xiaoerlang0359/E203plus/E203Plus/readme.txt

项目设计报告请见 燕子设计报告.pdf 包括系统设计方案，功能仿真及测试结果图

constraint 文件夹中是硬件工程的约束文件

DoC 中包含各分系统设计文档

license 中是蜂鸟E203的license，根据开源协议要求添加

rtl 文件夹中是E203Plus SoC设计的rtl代码

sim 文件夹中存放了我们对分系统进行行为仿真和fpga原型测试的tb文件和c文件以及结果照片

测试 文件夹中是对赛题要求的测试项目进行测试的内容。包括c文件，以及结果照片。

软件项目工程 是完成最终身份识别任务的eclipse工程文件
