xiaoerlang0359/E203plus/RISC-V挑战杯 Digilent赛题测试图库/RISC-V Digilent 测试库/README.txt

身份证号码库
--10张身份证号码图片
--图片尺寸85.6X54mm
--微软雅黑
--字号 18
--包含尾号X的身份证号码
--图片格式JPG

人脸图片库
--10组不同的人脸图片，每一组包含15张同一人的图片
--图片像素640X480
--图片格式JPG

*主办方会根据比赛实际情况扩展图片库，图片尺寸以及格式将保持统一，请大家悉知。
