xiaoerlang0359/E203plus/E203Plus/Doc（分系统设计文档）/VGA Controller Spec.docx

# VGA Controller Spec

## 功能介绍

VGA Controller模块接受来自CPU的字符显示数据，并将字符像素通过VGA显示到屏幕上。显示分辨率为640x480，色彩格式为RGB444。总共接受18x10共计180个字符信息。显示字符包括10个阿拉伯数字和大写字母‘X’。

## IO定义

用户侧采用ICB接口：

Name | Direction | Bits | Description
Cmd_valid | I | 1 | 主设备发送读写请求
Cmd_ready | O | 1 | 从设备返回读写接收信号
Cmd_read | I | 1 | 读或者写操作指示
Cmd_addr | I | 32 | 读写地址
Cmd_wdata | I | 32 | 写操作数据
Cmd_wmask | I | 3 | 写操作字节掩码
Rsp_valid | O | 1 | 从设备发送读写反馈请求信号
Rsp_ready | I | 1 | 主设备返回读写反馈接收信号
Rsp_rdata | O | 32 | 读反馈数据
Clk | I | 1 | 模块时钟
Rst_n | I | 1 | 复位，低有效

VGA侧采用RGB444格式输出。

Name | Direction | Bits | Description
Vga_R | O | 4 | VGA四位红色信息
Vga_G | O | 4 | VGA四位绿色信息
Vga_B | O | 4 | VGA四位蓝色信息

## 地址空间

VGA Controller使用了0x1001_0000 ~ 0x1001_0FFF的物理内存空间。

其中0x1001_0000 ~ 0x1000_1083暂存180个字符信息。

0x1001_0FFC为32为模块使能寄存器（只写）。当最低比特位置1使能VGA显示模块，最低比特位置0停止VGA显示模块。
