xiaoerlang0359/E203plus/E203Plus/2+BHL115476+燕子.jpg

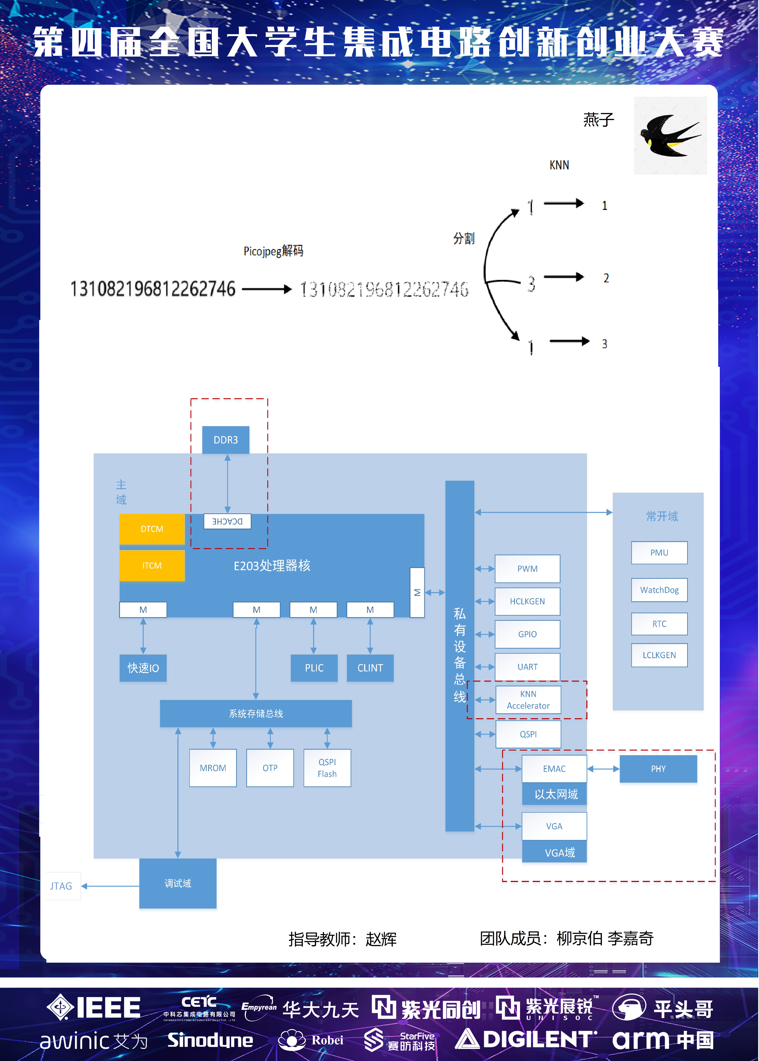
E203Plus/2+BHL115476+燕子.jpg
