xiaoerlang0359/E203plus/E203Plus/Doc（分系统设计文档）/总体设计.jpg

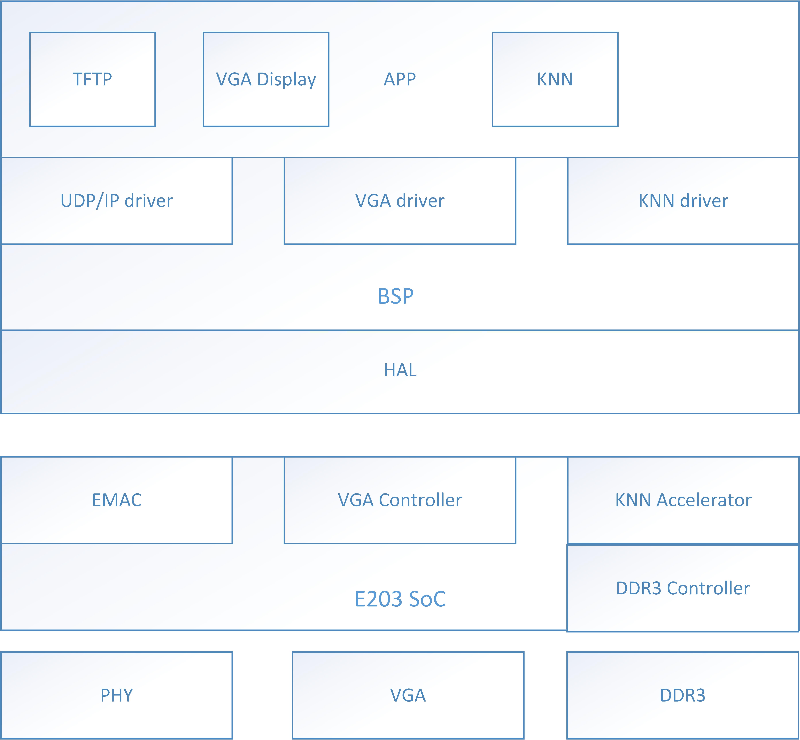
E203Plus/Doc（分系统设计文档）/总体设计.jpg
