xiaoerlang0359/E203plus/E203Plus/log_on.JPG

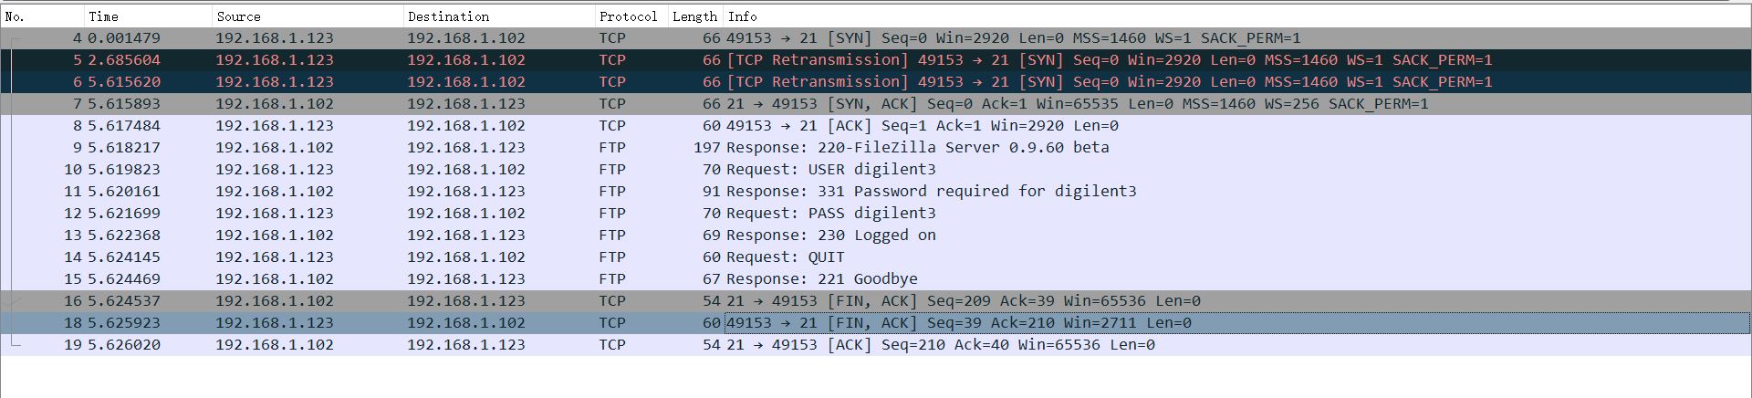
E203Plus/log_on.JPG
