xiaoerlang0359/E203plus/E203Plus/sim（分系统行为仿真及fpga测试）/DDR3/fpga存储测试.jpg

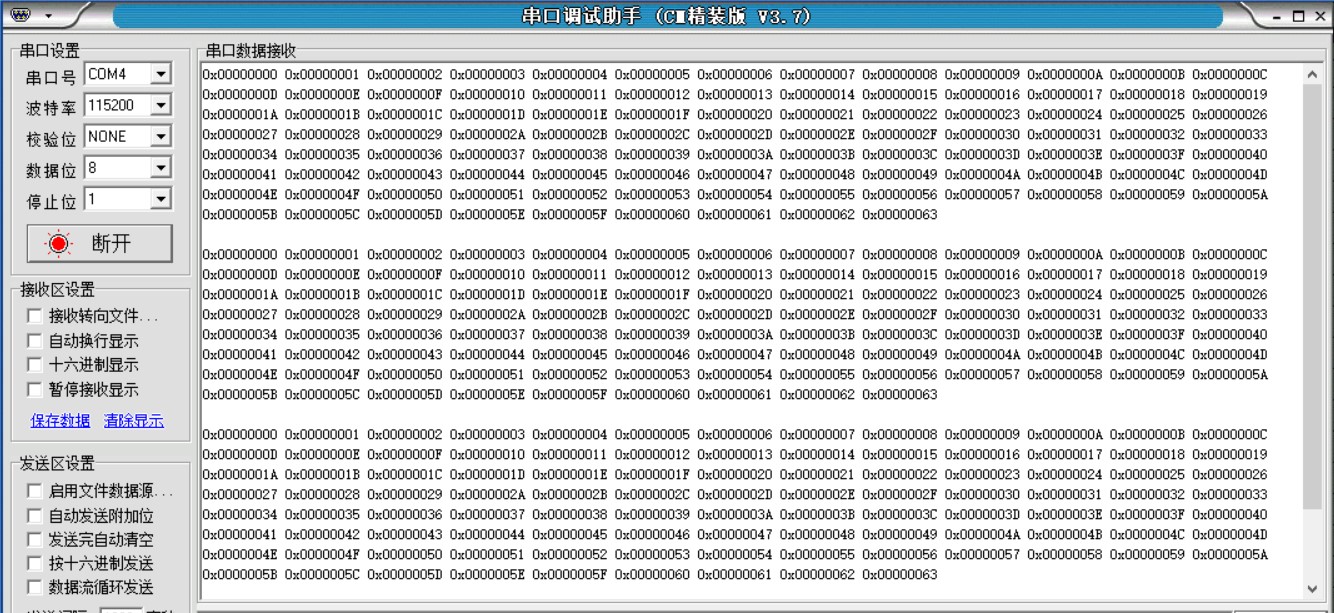
E203Plus/sim（分系统行为仿真及fpga测试）/DDR3/fpga存储测试.jpg
