xiaoerlang0359/E203plus/E203Plus/sim（分系统行为仿真及fpga测试）/EMAC/数据接收.jpg

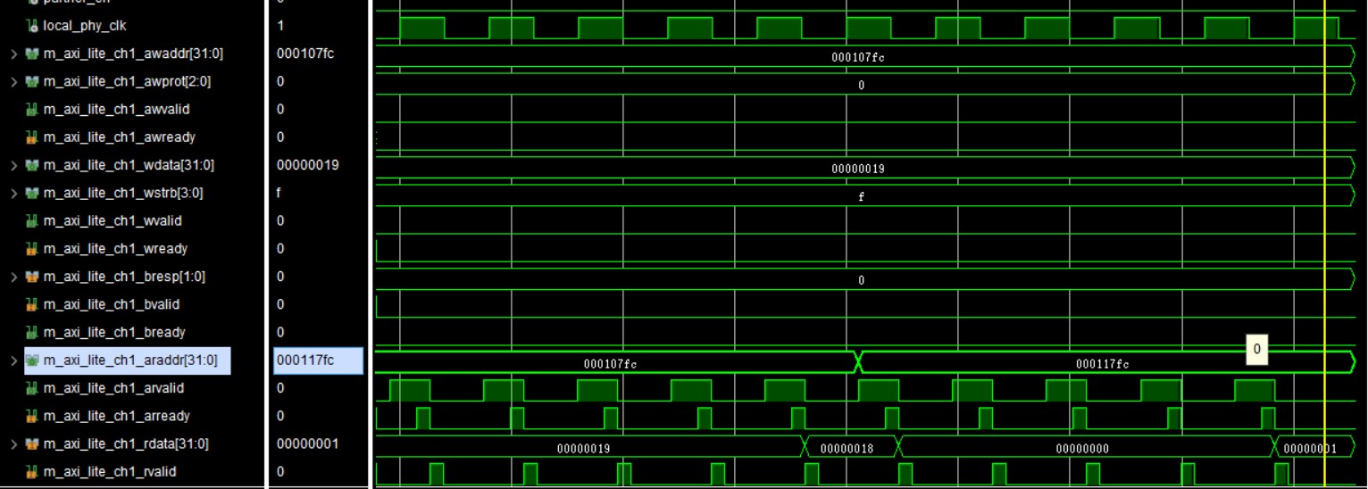
E203Plus/sim（分系统行为仿真及fpga测试）/EMAC/数据接收.jpg
