xiaoerlang0359/E203plus/E203Plus/sim（分系统行为仿真及fpga测试）/KNN/行为仿真2.jpg

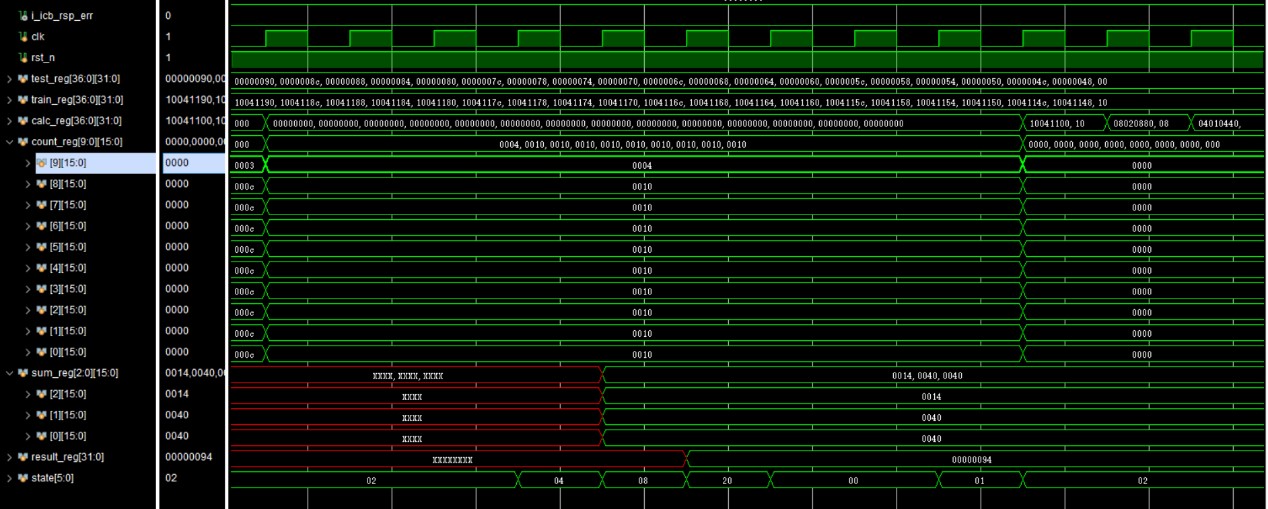
E203Plus/sim（分系统行为仿真及fpga测试）/KNN/行为仿真2.jpg
