xiaoerlang0359/E203plus/E203Plus/测试（赛题要求测试）/gpio/绿色.jpg

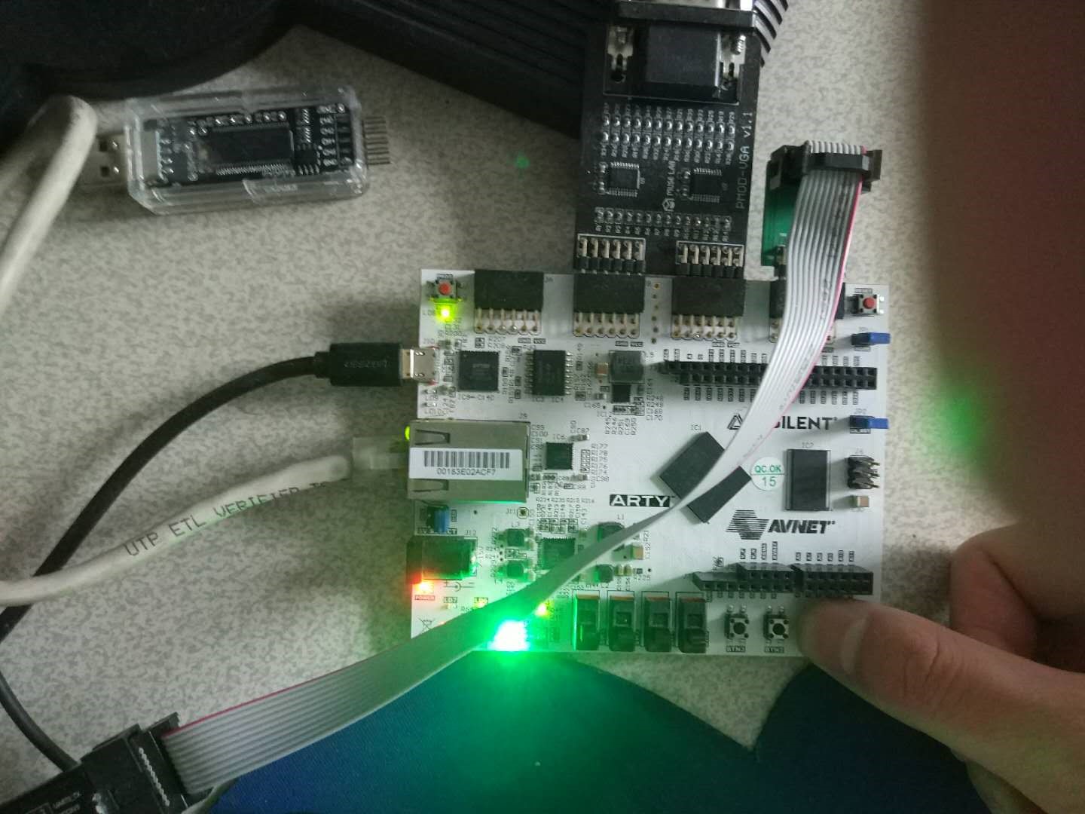
E203Plus/测试（赛题要求测试）/gpio/绿色.jpg
