xiaoerlang0359/E203plus/E203Plus/测试（赛题要求测试）/risc-v/risc_v.jpg

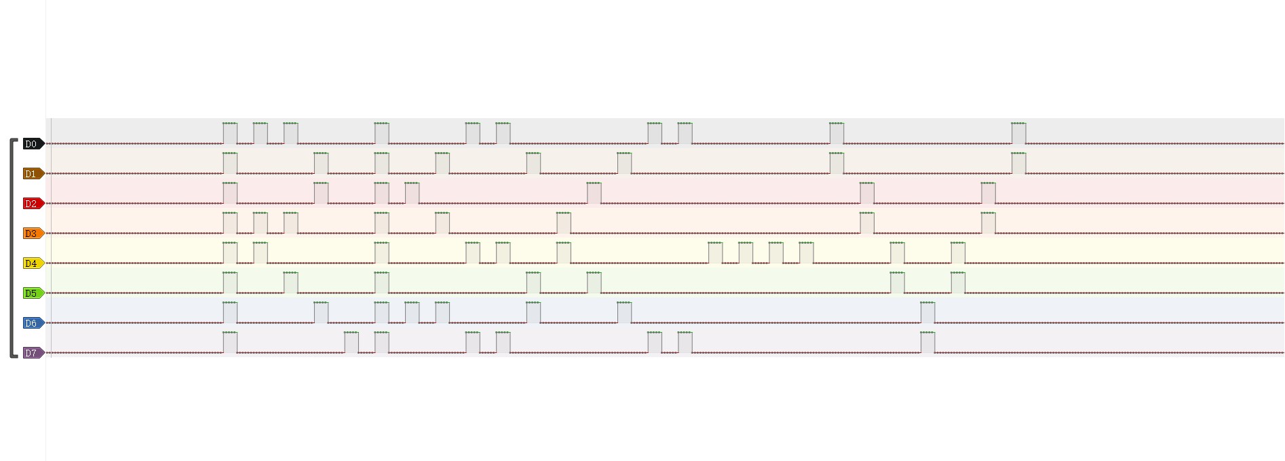
E203Plus/测试（赛题要求测试）/risc-v/risc_v.jpg
