xiaoerlang0359/E203plus/RISC-V挑战杯 Digilent赛题测试图库/RISC-V Digilent 测试库/身份证/1.jpg

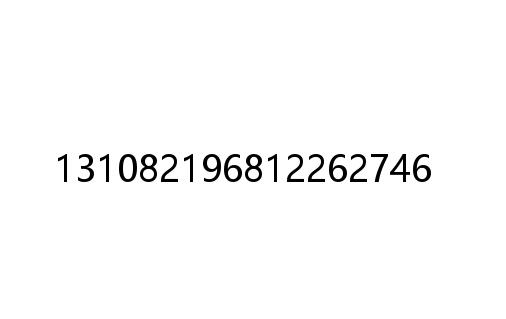
RISC-V挑战杯 Digilent赛题测试图库/RISC-V Digilent 测试库/身份证/1.jpg
