xiaoerlang0359/E203plus/E203Plus/测试（赛题要求测试）/final_test/test.txt

01234567890123456X
976230154896537150
658425970934331400
481988392863422640
382810210809111612
15487560993060459X
321890146238729340
907709837891161564
190196732524782430
78495706105604768X
