xiaoerlang0359/E203plus/trainingset/maketraingset/maketraingset/0_0_test.txt

2097151,2097151,2097151,2097151,2081023,2031679,1966111,1973775,1851151,1589127,1605511,1605511,1605507,1114051,1114051,1114051,1114051,1114051,1114051,1114051,1114051,1114051,1114051,1114055,1605511,1605511,1605511,1851151,1842719,1966111,2031679,2081023,2097151,2097151,2097151,2097151,2097151,
