xiaoerlang0359/E203plus/trainingset/maketraingset/maketraingset/1_0_test.txt

2097151,2097151,2097151,2097151,2095615,2093567,2081279,2032127,1835519,1847807,1896959,2093567,2093567,2093567,2093567,2093567,2093567,2093567,2093567,2093567,2093567,2093567,2093567,2093567,2093567,2093567,2093567,2093567,2093567,2093567,2093567,2093567,2097151,2097151,2097151,2097151,2097151,
