xiaoerlang0359/E203plus/trainingset/maketraingset/maketraingset/2_0_test.txt

2097151,2097151,2097151,2097151,2064895,1966207,1572927,1604639,1703711,1834895,2097039,2097039,2097039,2097039,2096911,2096927,2096671,2096191,2095231,2089215,2081279,2065407,2035711,1974271,1851391,1605631,1638399,1114111,1114111,1048583,1048583,1048583,2097151,2097151,2097151,2097151,2097151,
