xiaoerlang0359/E203plus/trainingset/maketraingset/maketraingset/3_0_test.txt

2097151,2097151,2097151,2097151,2064639,1966207,1835039,1866783,1965583,2096911,2096911,2096911,2096911,2096671,2096671,2095167,2031871,2032127,2031679,2096159,2096911,2096903,2097031,2097031,2097031,2097031,2096903,1834767,1637407,1572895,1572991,1966591,2097151,2097151,2097151,2097151,2097151,
