xiaoerlang0359/E203plus/trainingset/maketraingset/maketraingset/4_0_test.txt

2097151,2097151,2097151,2097151,2096191,2096191,2095167,2095167,2093119,2093119,2089535,2081343,2065983,2068031,2035263,1973823,1982015,1867327,1605183,1113663,130623,261695,3,3,3,2096703,2096703,2096703,2096703,2096703,2096703,2096703,2097151,2097151,2097151,2097151,2097151,
