xiaoerlang0359/E203plus/trainingset/maketraingset/maketraingset/5_0_test.txt

2097151,2097151,2097151,2097151,1835023,1835023,1835023,1867775,1867775,1867775,1900543,1638399,1638399,1638399,1638399,1573375,1572991,1572895,2095119,2096655,2096903,2097031,2097031,2097031,2097031,2097031,2096911,2096655,2096159,1572927,1572991,1835519,2097151,2097151,2097151,2097151,2097151,
