xiaoerlang0359/E203plus/trainingset/maketraingset/maketraingset/6_0_test.txt

2097151,2097151,2097151,2097151,2093087,2080783,2064399,2033615,1974271,1851391,1851391,1605631,1605631,1638399,1114111,1110143,1097759,1081359,1056519,1081223,1081219,1114051,1114051,1114051,1114051,1638339,1605511,1851271,1842703,1966111,2031679,2081023,2097151,2097151,2097151,2097151,2097151,
