xiaoerlang0359/E203plus/trainingset/maketraingset/maketraingset/7_0_test.txt

2097151,2097151,2097151,2097151,1048583,1048583,1048583,2097039,2096911,2096927,2096671,2096703,2096191,2096255,2095231,2095231,2093311,2093311,2093567,2089471,2089471,2081791,2081791,2081791,2066431,2066431,2066431,2066431,2035711,2035711,2035711,2035711,2097151,2097151,2097151,2097151,2097151,
