xiaoerlang0359/E203plus/trainingset/maketraingset/maketraingset/8_0_test.txt

2097151,2097151,2097151,2097151,2081023,2031679,1966111,1842703,1588999,1605511,1605511,1605511,1605511,1867535,1851151,1973791,2031679,2031679,1835039,1850895,1638159,1113991,1179591,1179591,1179591,1179591,1113991,1638287,1588751,1835039,1966143,2064639,2097151,2097151,2097151,2097151,2097151,
