xiaoerlang0359/E203plus/trainingset/maketraingset/maketraingset/9_0_test.txt

2097151,2097151,2097151,2097151,2081023,2031679,1966111,1842703,1589007,1605511,1113991,1114055,1114051,1114051,1114051,1114051,1605507,1588995,1580547,1835075,1966147,2064835,2097095,2097031,2097031,2097039,2096911,2096671,1701951,1572991,1573119,1836031,2097151,2097151,2097151,2097151,2097151,
