xiaoerlang0359/E203plus/trainingset/maketraingset/maketraingset/X_0_test.txt

2097151,2097151,2097151,2097151,131056,1114081,1114049,1605571,1851271,1851271,1974031,1973791,2035231,2067519,2065471,2080895,2081023,2089215,2089215,2080895,2064511,2065471,2034751,2039327,1974031,1851151,1851271,1605511,1114051,1114049,131041,262128,2097151,2097151,2097151,2097151,2097151,
