xiaoerlang0359/E203plus/E203Plus/测试（赛题要求测试）/final_test/硬件连接.jpg

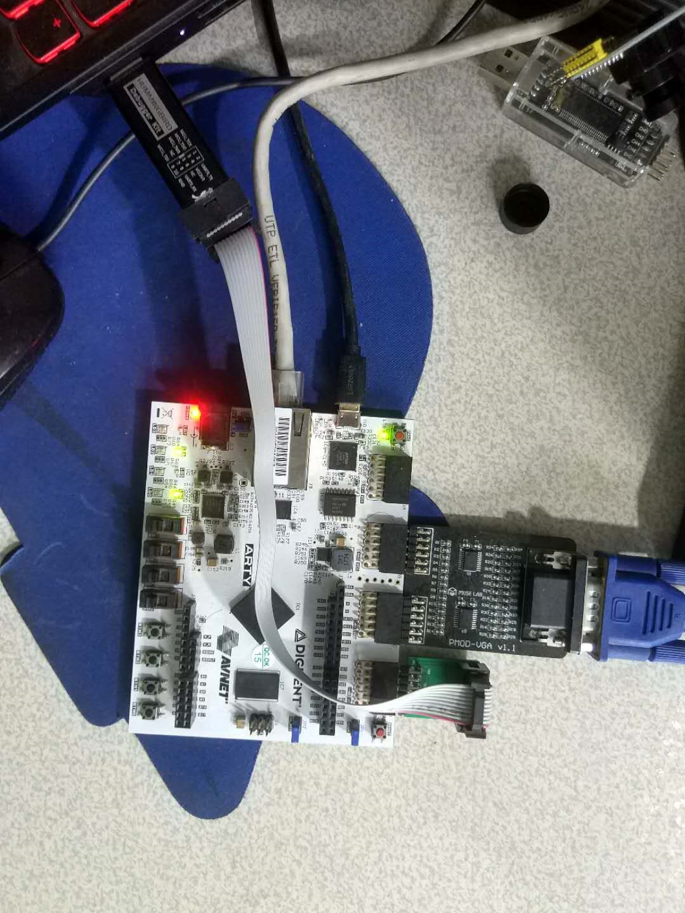
E203Plus/测试（赛题要求测试）/final_test/硬件连接.jpg
