xiaoerlang0359/E203plus/(threads)

Thread 1 (2021-04-27):

hi 您好 这个项目很感兴趣呢

weisuolong, 2021-04-27:
您好 这个项目很感兴趣，但是 浮点数 乘加法，没有除法么？
您是学生？

xiaoerlang0359, 2021-04-27:
您好，感谢您对我的项目的肯定，我是学生。本次设计的SoC中是没有浮点数运算单元的，最终的图像比较是通过KNN算法实现的。详见E203Plus子文件夹中的介绍文档。如果您对risc-v内核的FPU实现感兴趣，可以参考其他开源项目，比如国科大的果壳，或者https://github.com/ljwljwljwljw/FPU，https://github.com/xiaoerlang0359/CNRV-FPU。当然如果您还对用verilog实现的较高性能rv core感兴趣，欢迎关注我的新项目：https://github.com/xiaoerlang0359/HiCore_a_riscv32_core
