xiaoerlang0359/E203plus/boards/nucleikit/蜂鸟FPGA开发板光绘图.pdf

# ART FILM - TOP

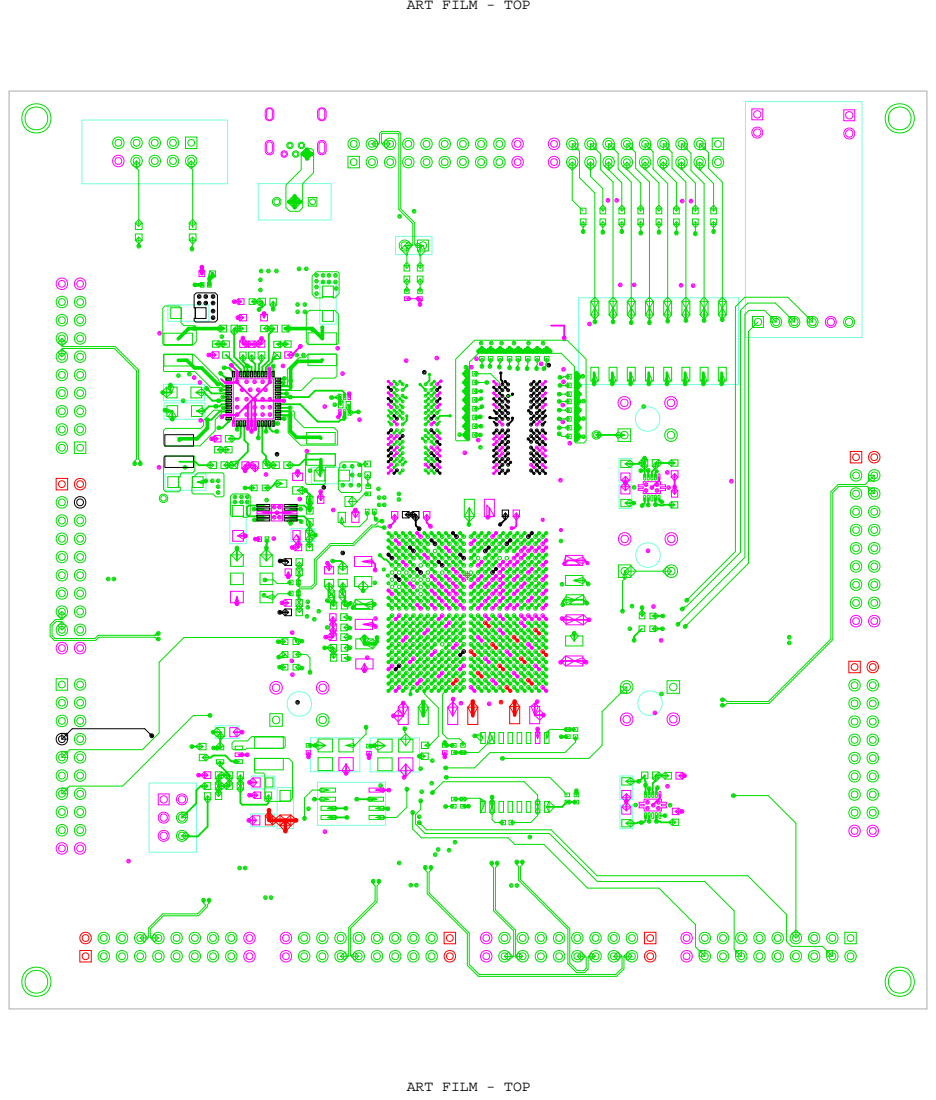
[picture p192: page 1]

ART FILM - TOP

# ART FILM - L2_GND_1

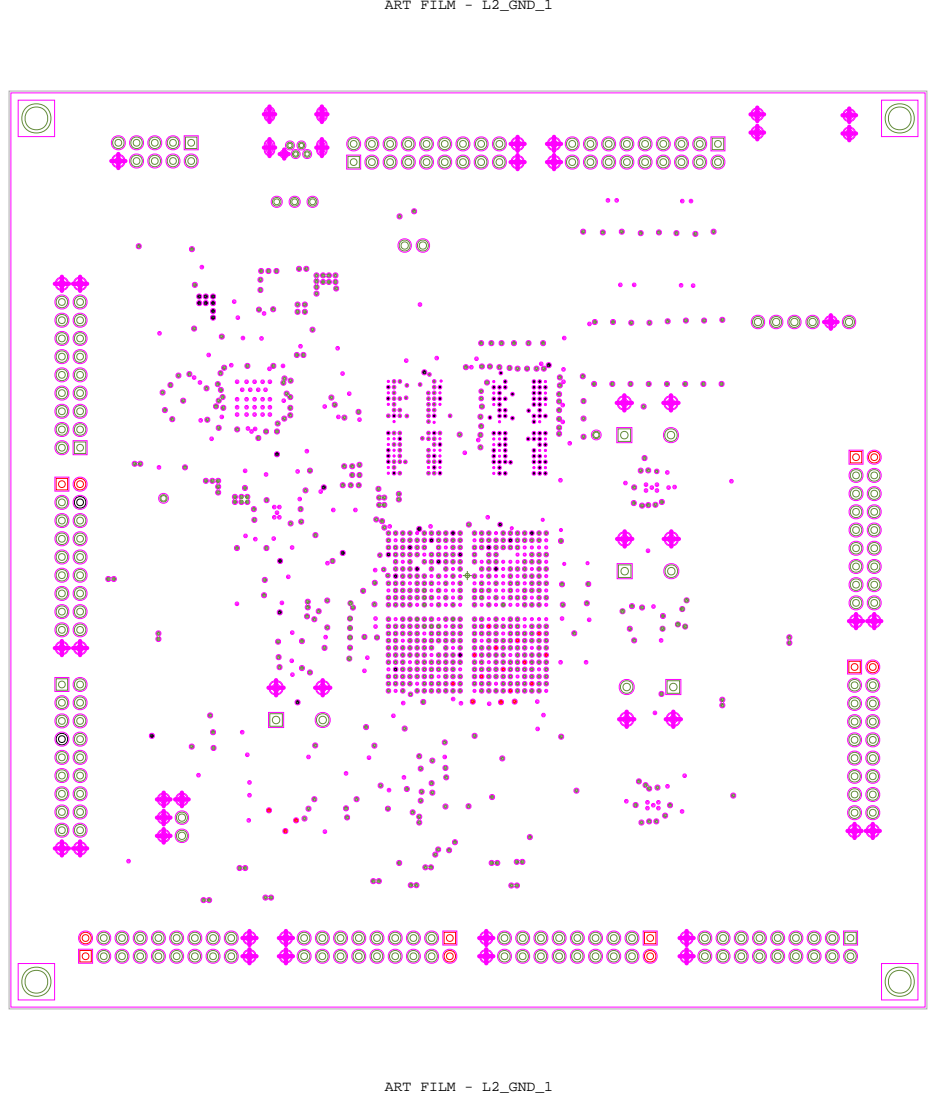
[picture p193: page 2]
ART FILM - L2_GND_1

# ART FILM - L3_SIG_2

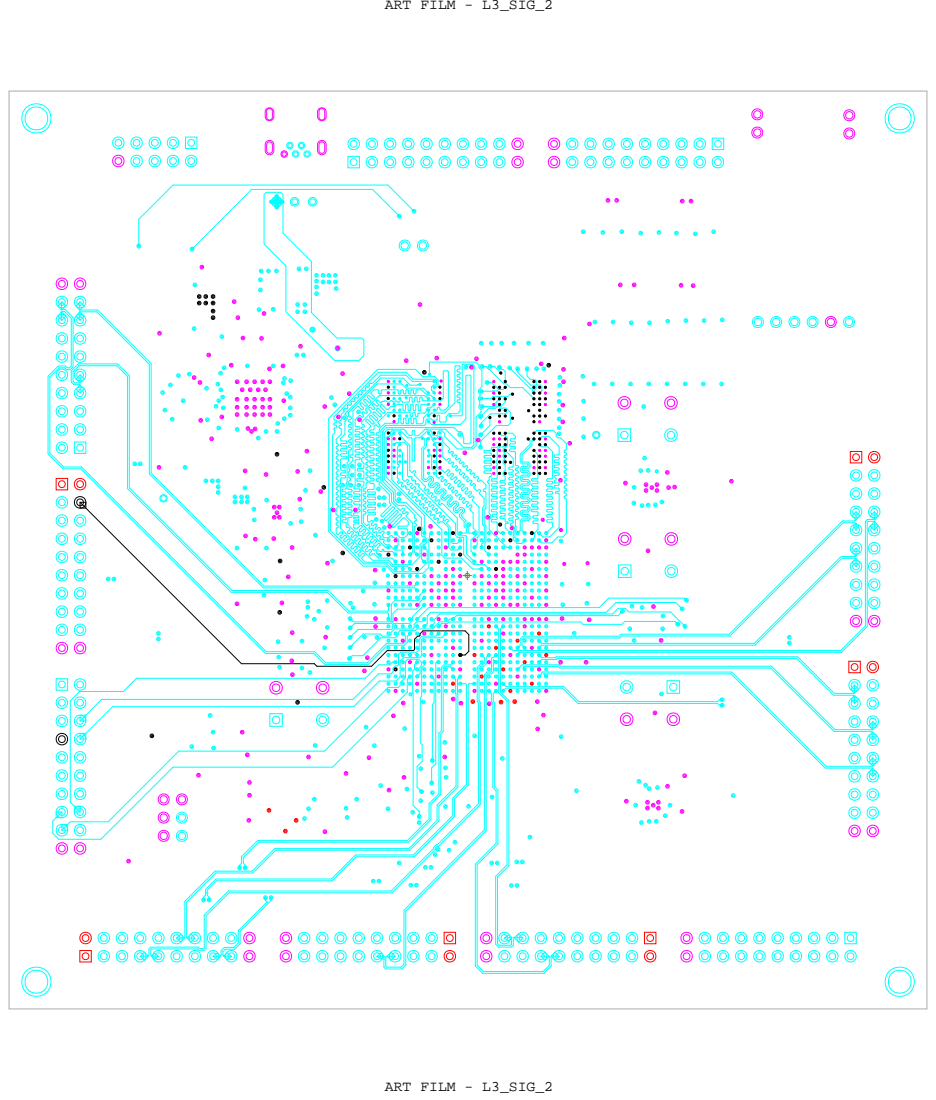
[picture p194: page 3]
ART FILM - L3_SIG_2

# ART FILM - L4_GND_3

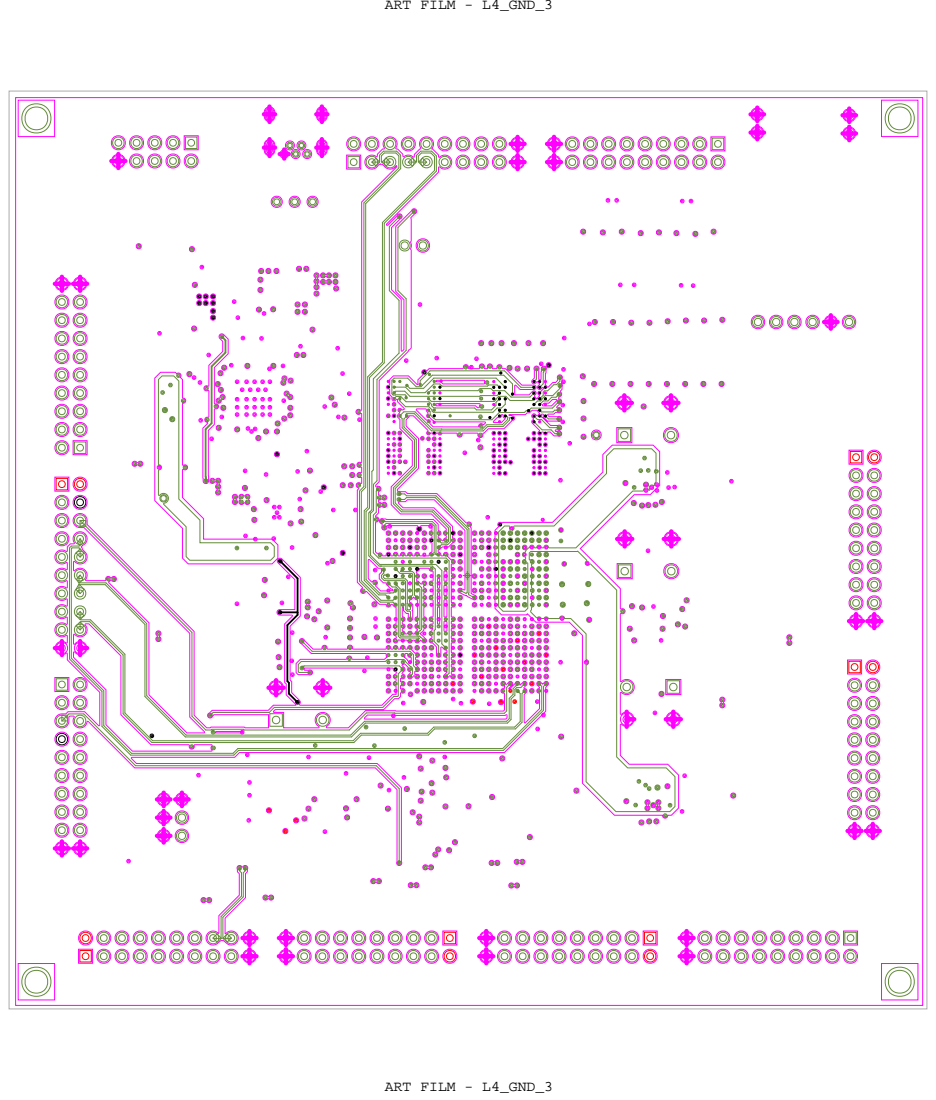
[picture p195: page 4]
ART FILM - L4_GND_3

# ART FILM - L7_GND_6

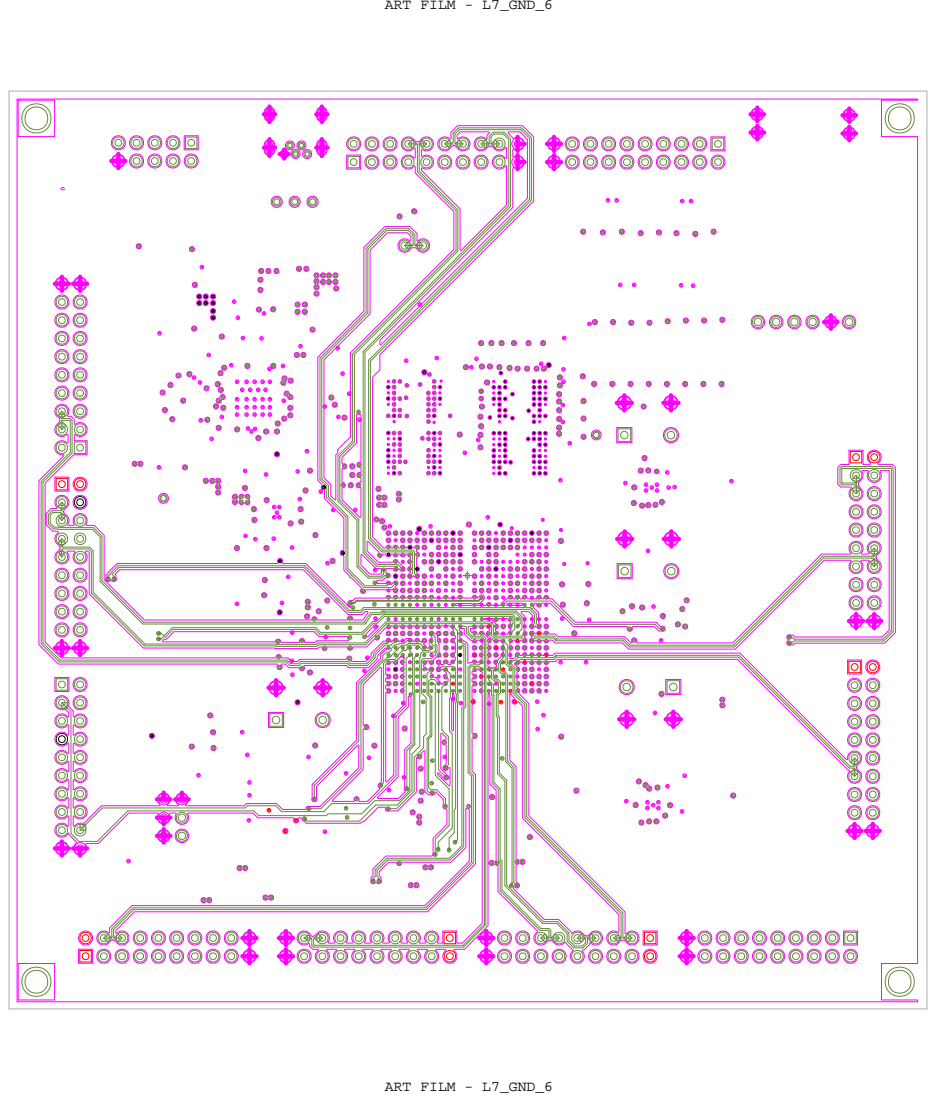
[picture p196: page 5]
ART FILM - L7_GND_6

# ART FILM - BOTTOM

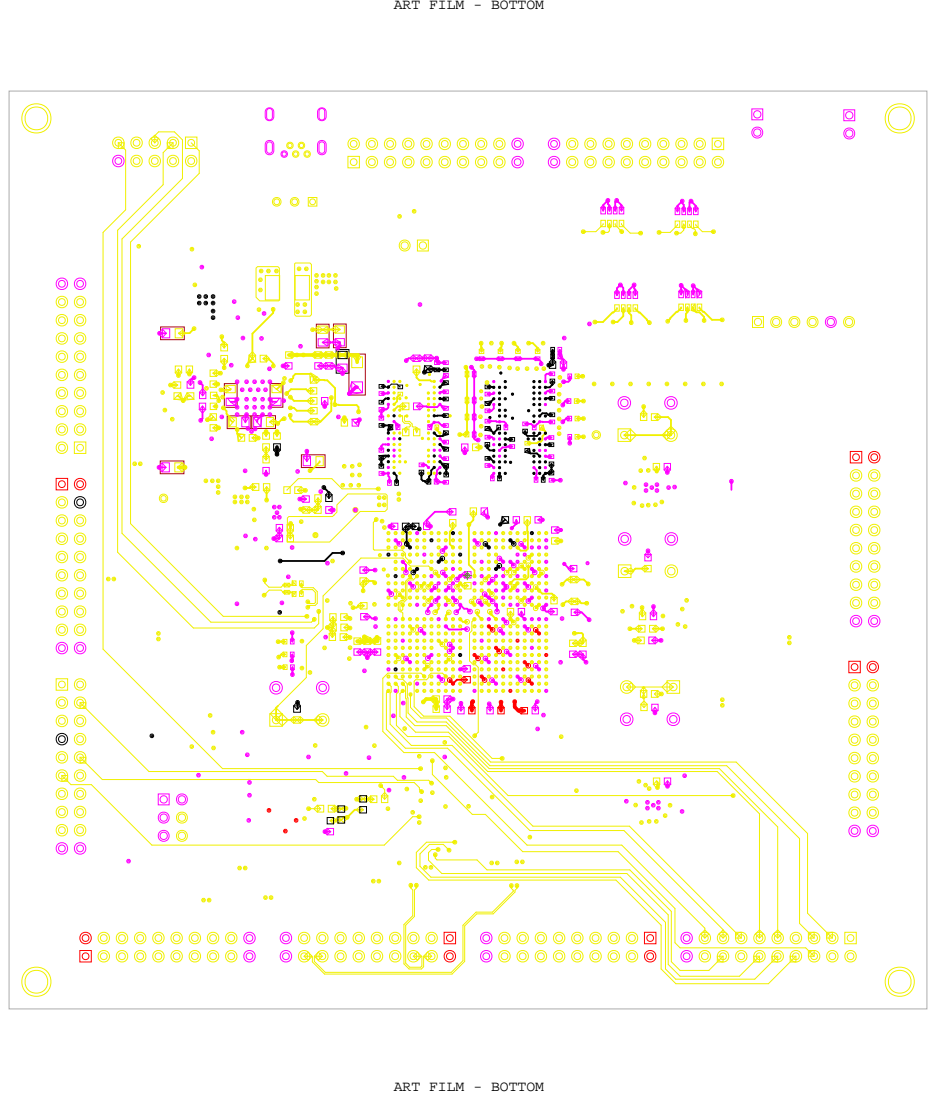
[picture p197: page 6]

ART FILM - BOTTOM

# ART FILM - SILKSCREEN_BOT

RN1

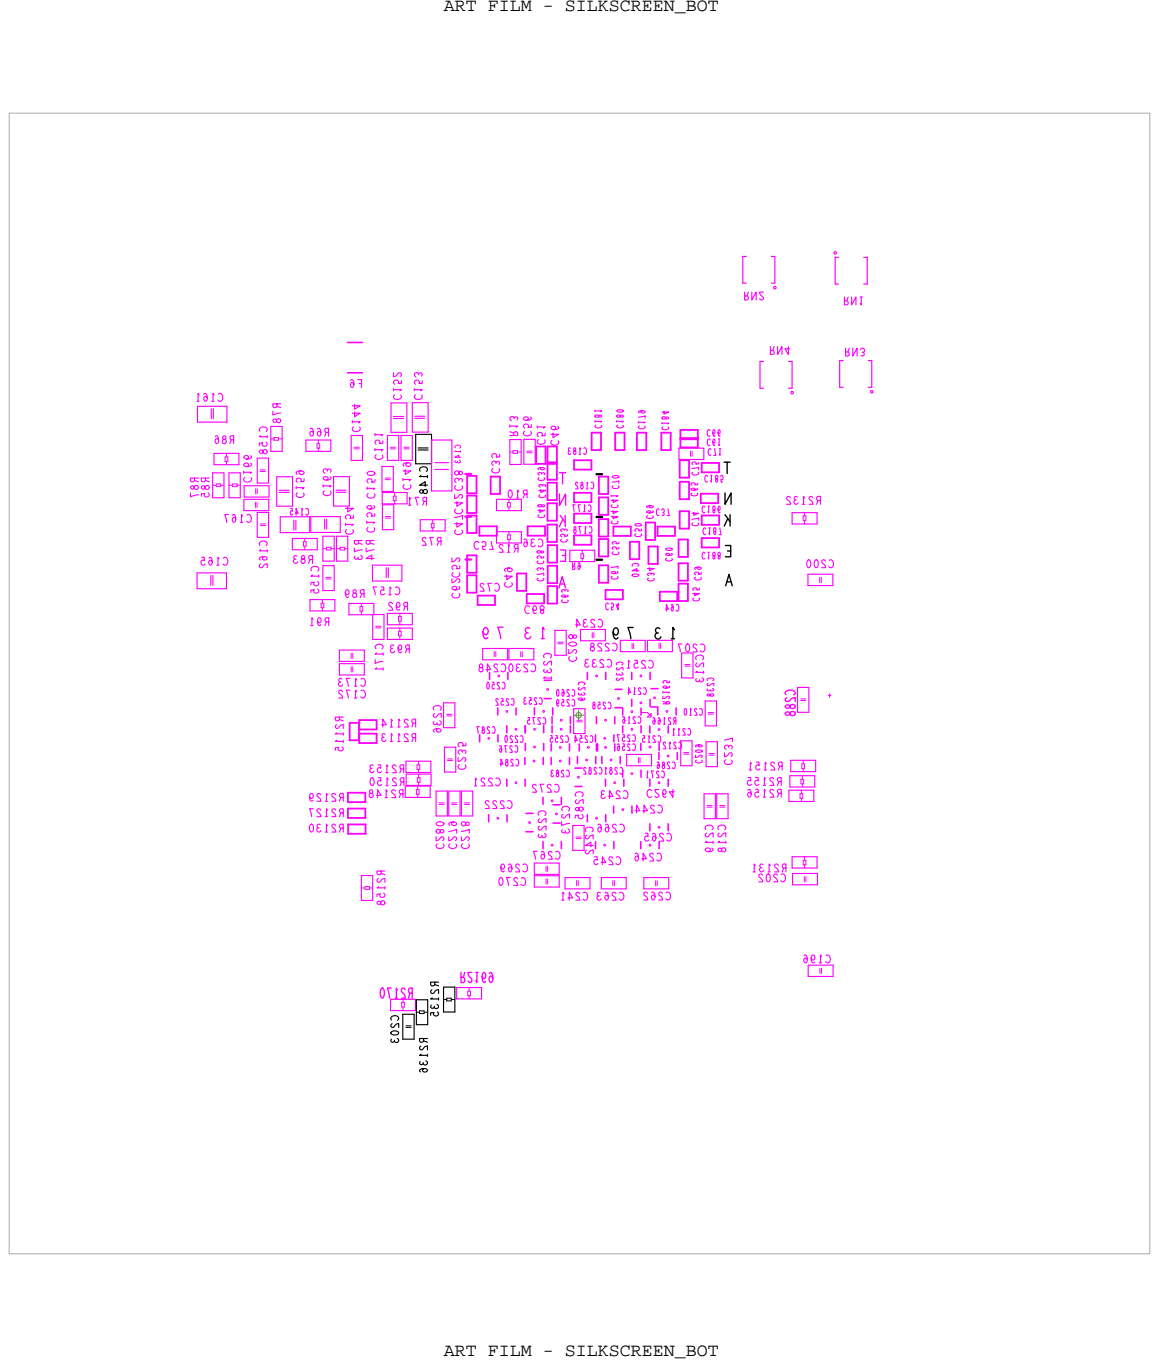
[picture p198: page 7]

# ART FILM - SILKSCREEN_TOP

J50

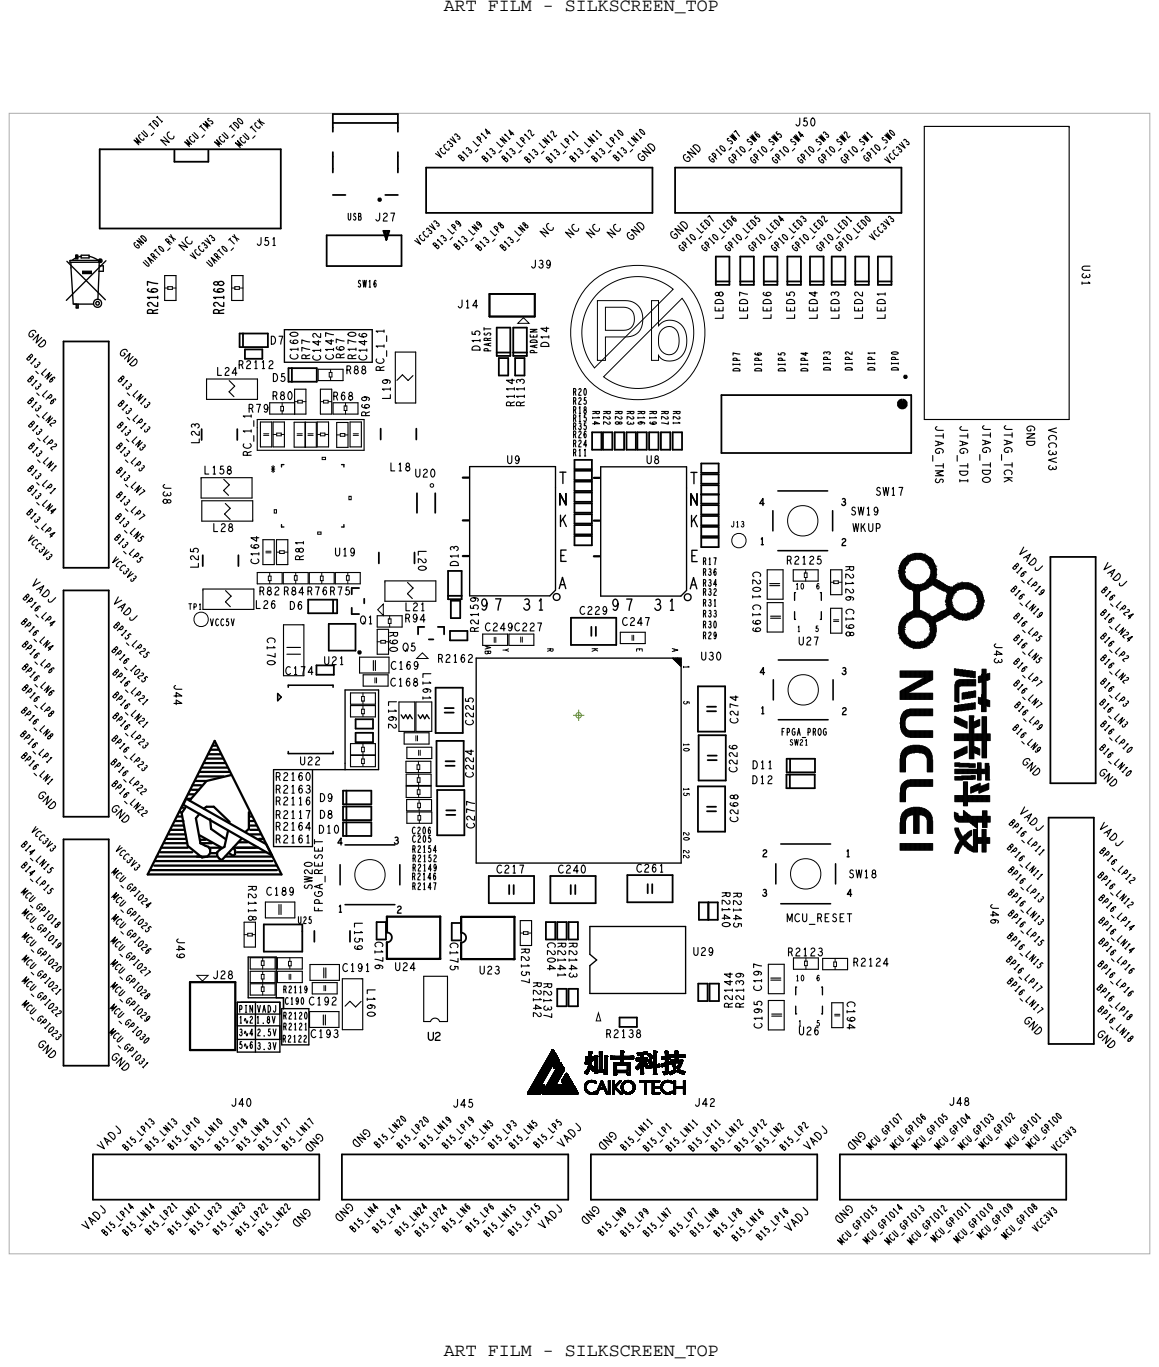
[picture p199: page 8]

# ART FILM - L8_SIG_7

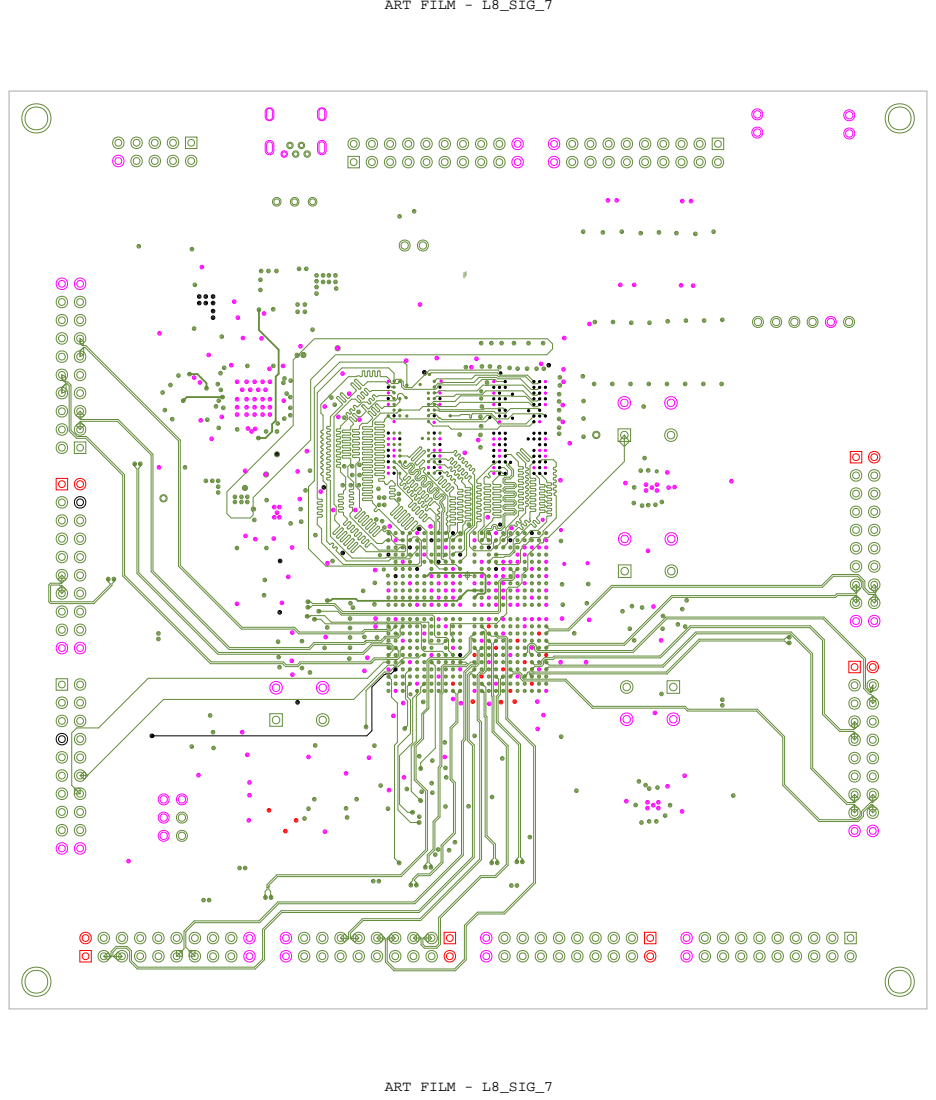
[picture p200: page 9]
ART FILM - L8_SIG_7

# ART FILM - L9_GND_8

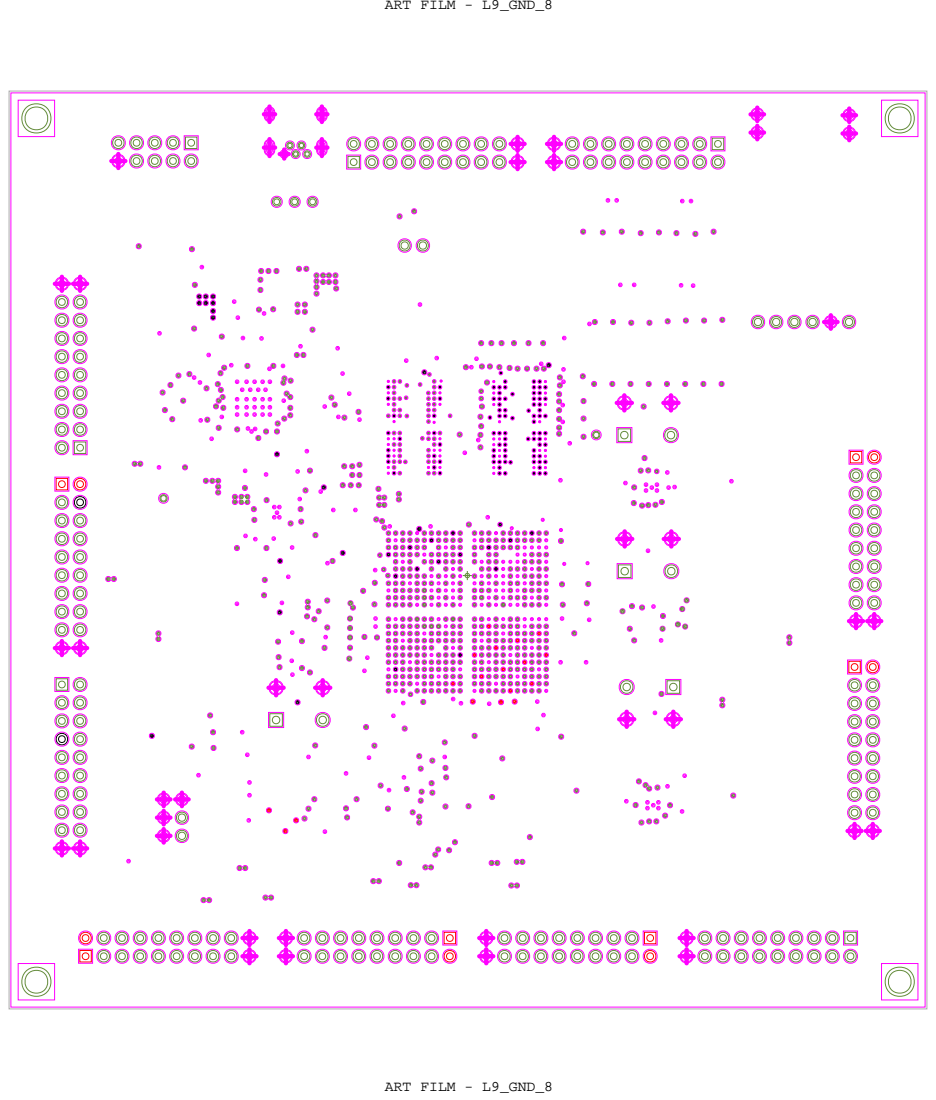
[picture p201: page 10]
ART FILM - L9_GND_8

# ART FILM - L5_PWER_4

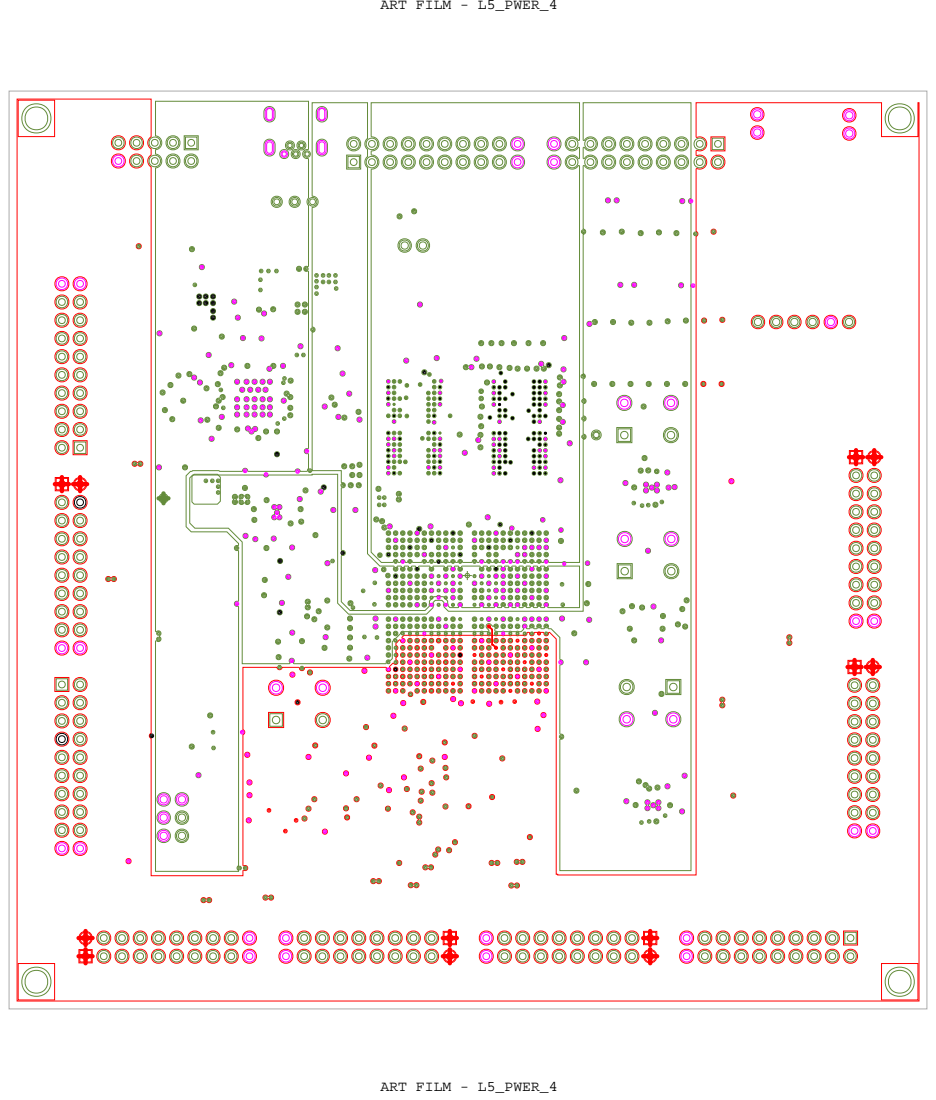
[picture p202: page 11]
ART FILM - L5_PWER_4

# ART FILM - L6_PWER_5

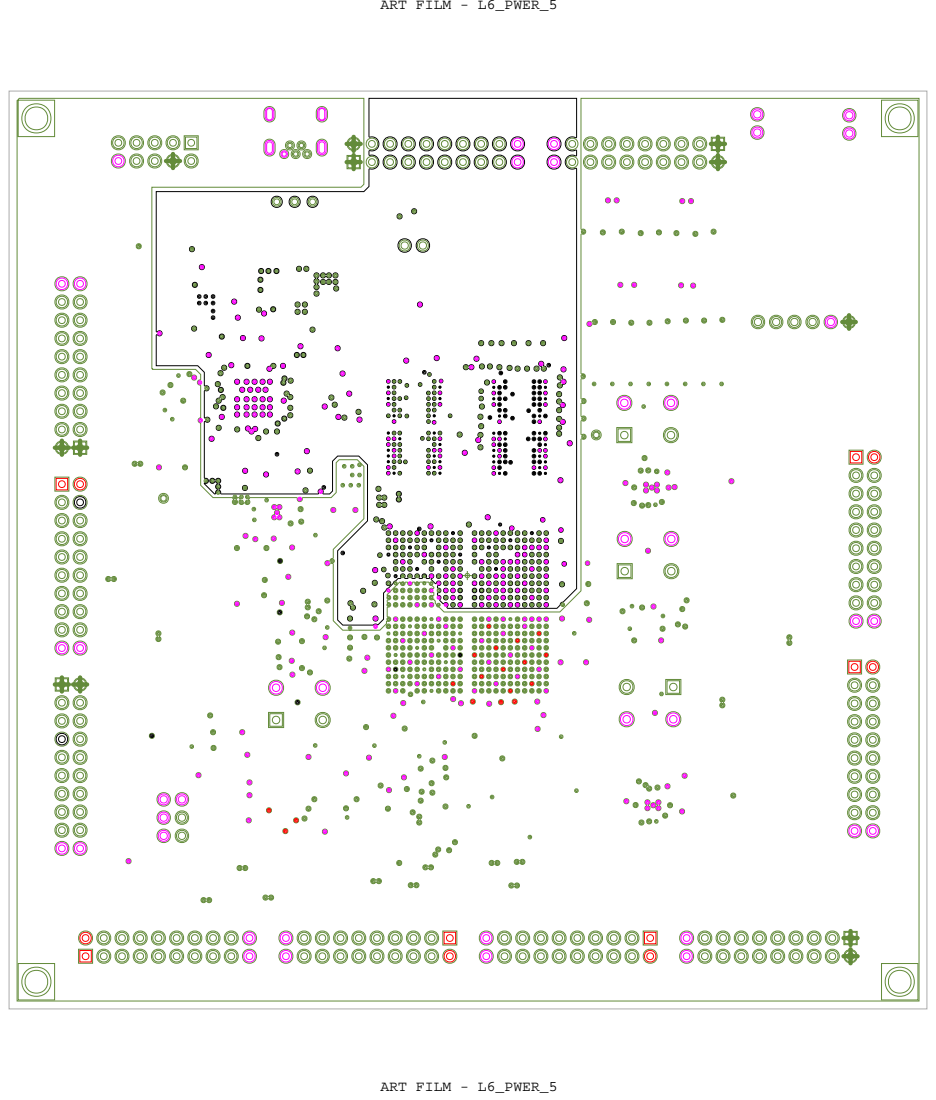
[picture p203: page 12]
ART FILM - L6_PWER_5
