xiaoerlang0359/E203plus/boards/nucleikit/蜂鸟FPGA开发板原理图.pdf

# TOP

## CONNECTOR

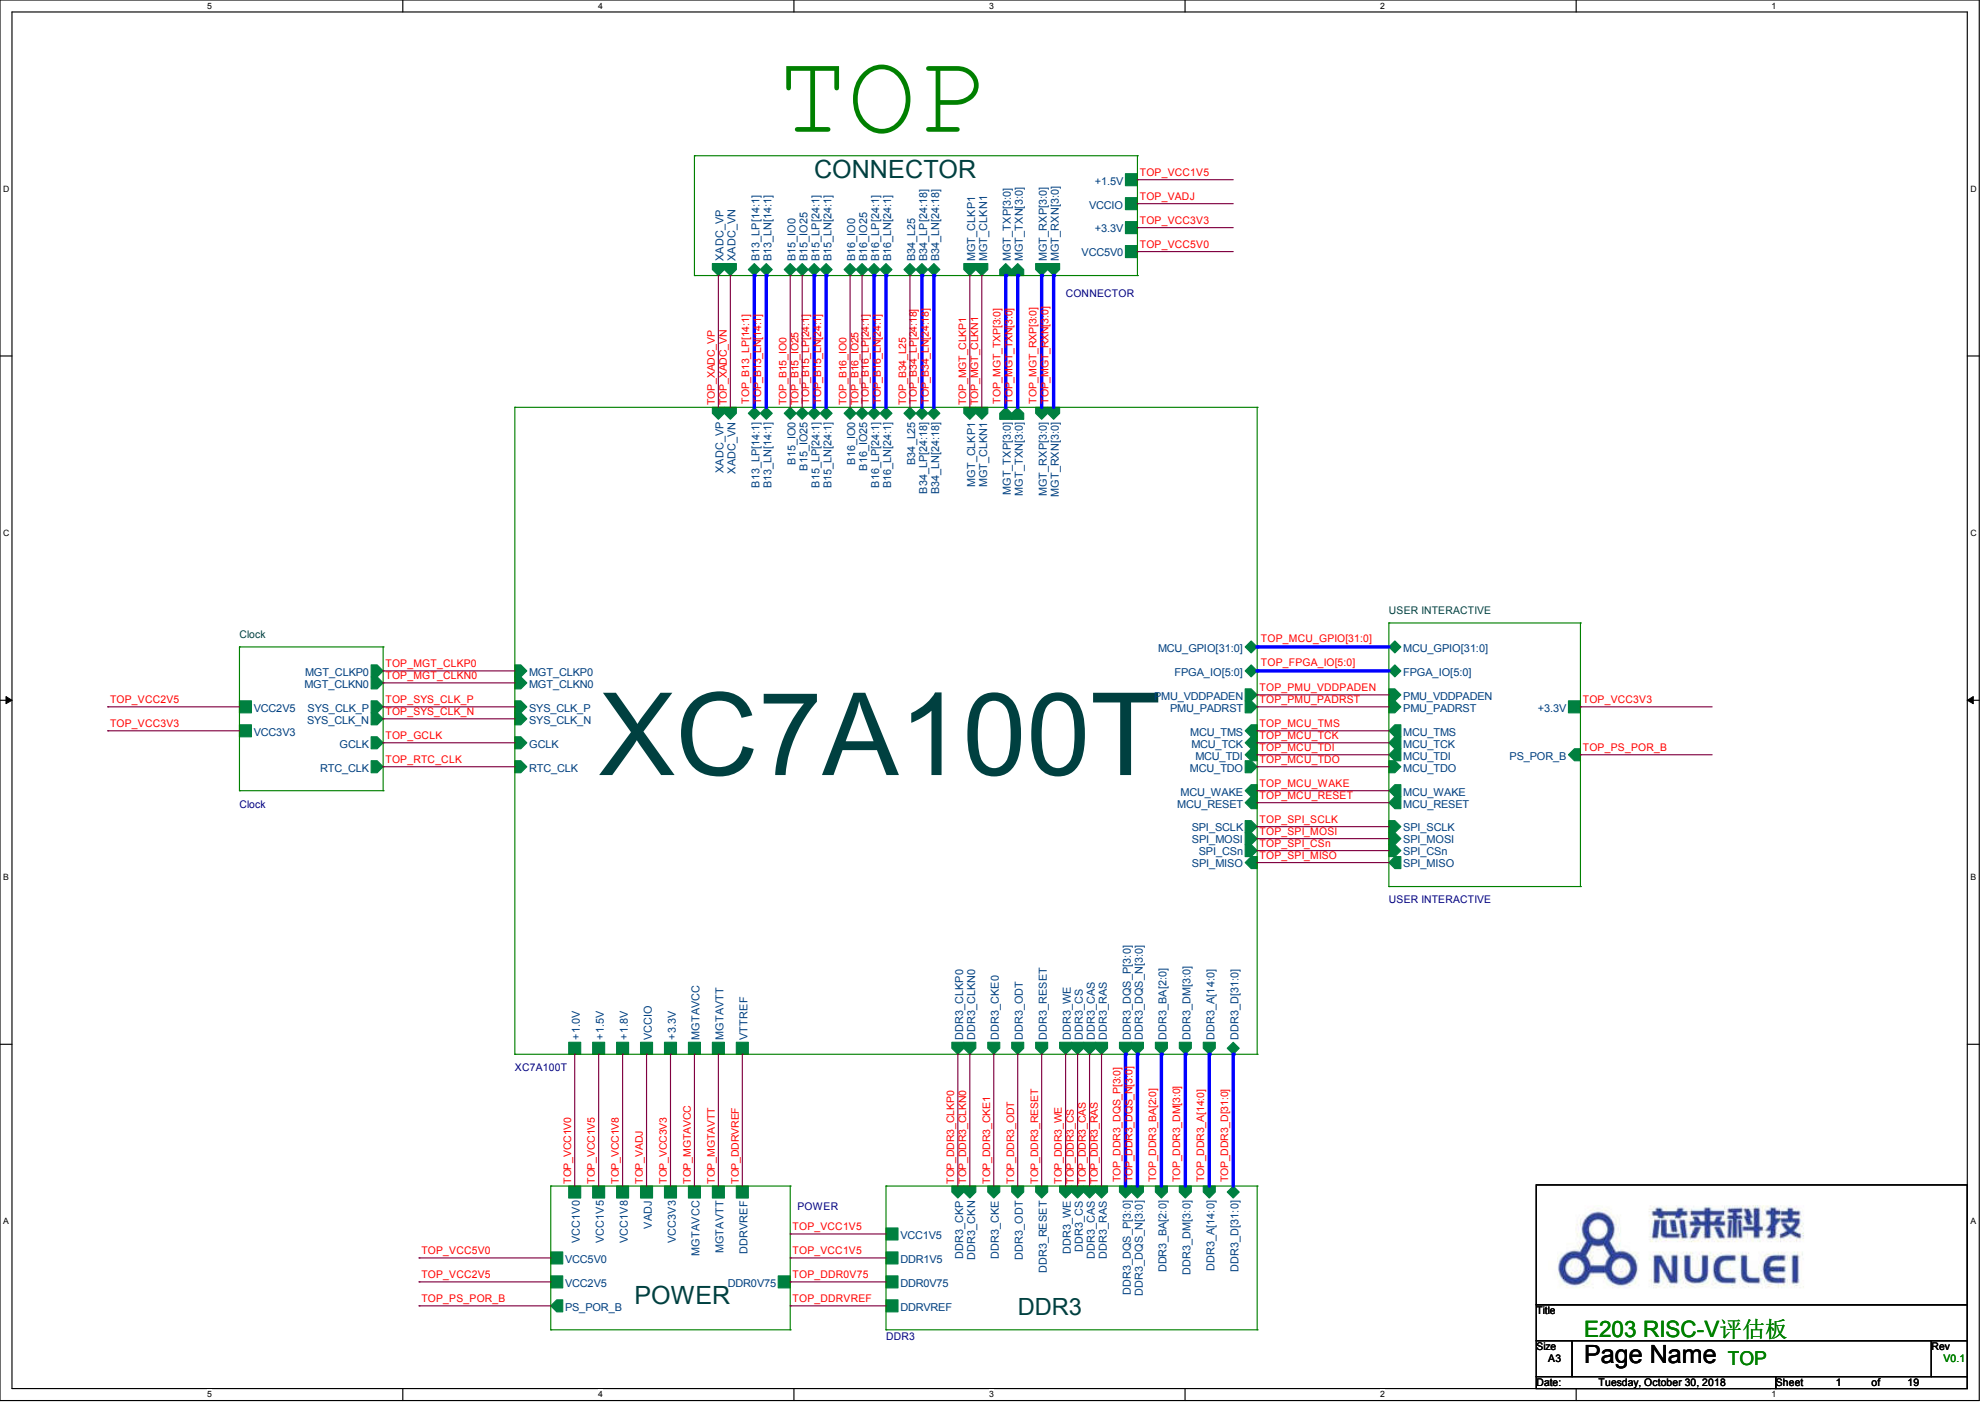
[picture p204: page 1]
Title; Size; Page Name; Rev; Date:; Sheet; TOP; E203 RISC-V评估板; Tuesday, October 30, 2018; CONNECTOR; XADC_VP; XADC_VN; MGT_CLKP1; MGT_CLKN1; MGT_TXP[3:0]; MGT_TXN[3:0]; MGT_RXP[3:0]; MGT_RXN[3:0]; VCC5V0; VCCIO; USER INTERACTIVE; MCU_RESET; MCU_WAKE; MCU_GPIO[31:0]; FPGA_IO[5:0]; MCU_TDI; MCU_TMS MCU_TCK; MCU_TDO; PS_POR_B; PMU_PADRST; PMU_VDDPADEN; SPI_SCLK; SPI_MISO; SPI_MOSI SPI_CSn; Clock; VCC2V5; MGT_CLKP0 MGT_CLKN0; SYS_CLK_N; SYS_CLK_P; VCC3V3; GCLK; RTC_CLK; MGTAVCC; MGTAVTT; VTTREF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

# CLOCK

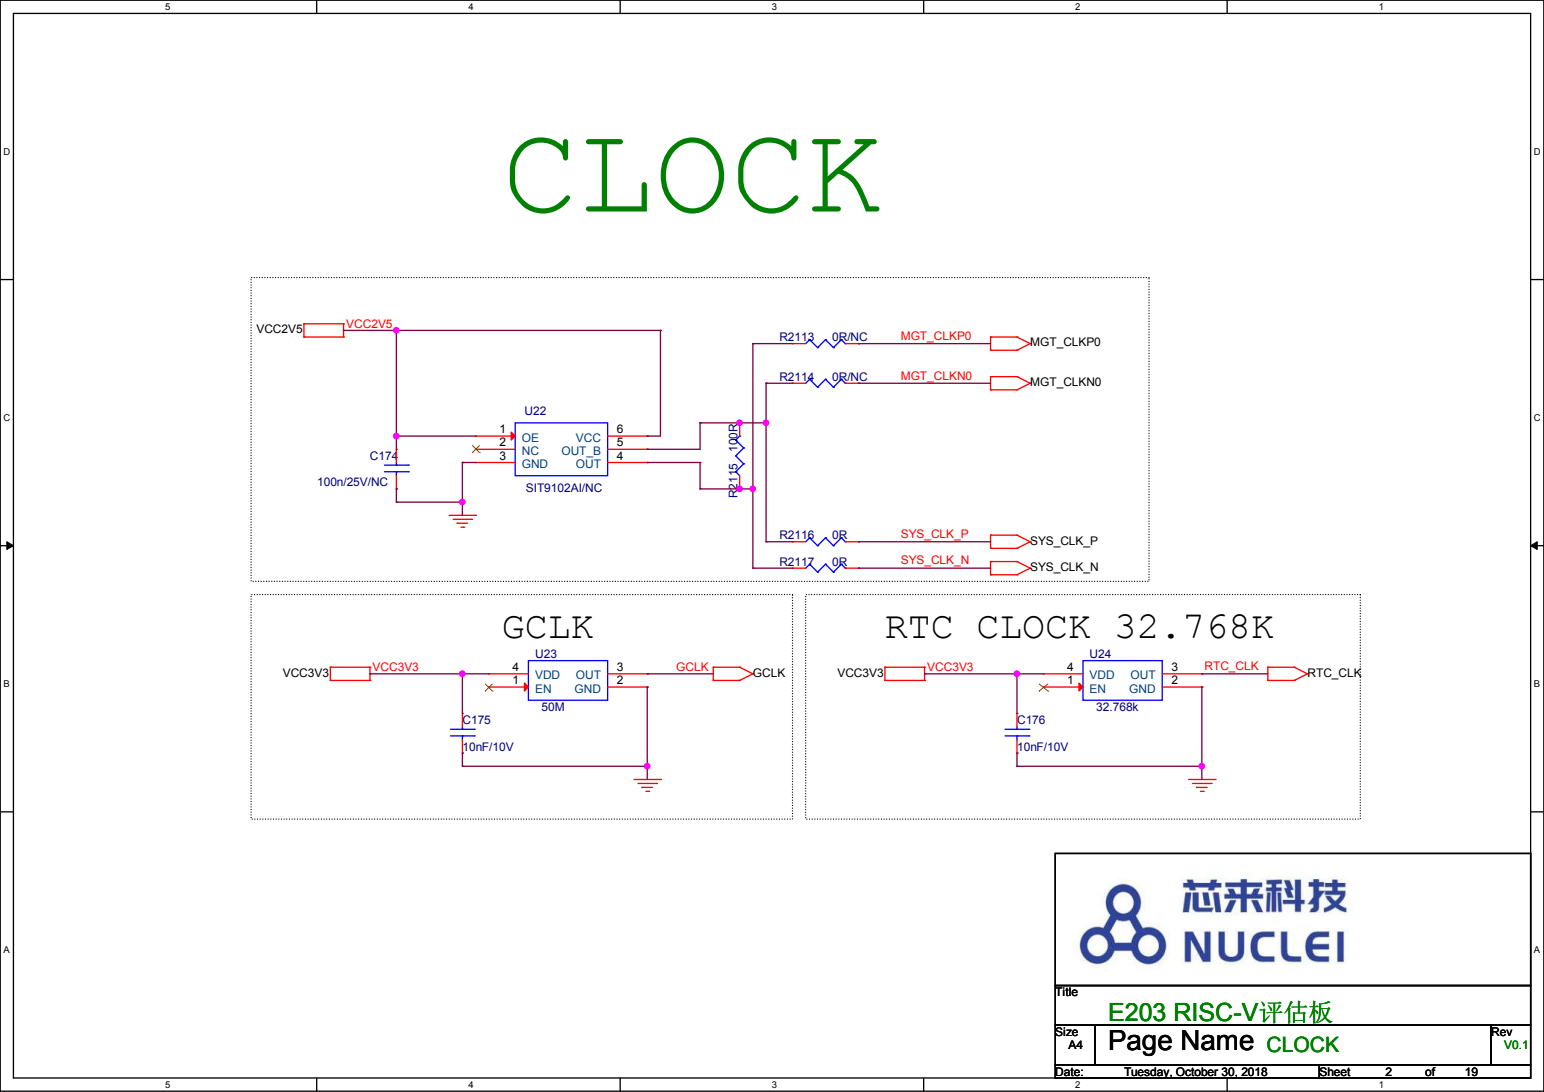
[picture p205: page 2]

# CONNECTOR

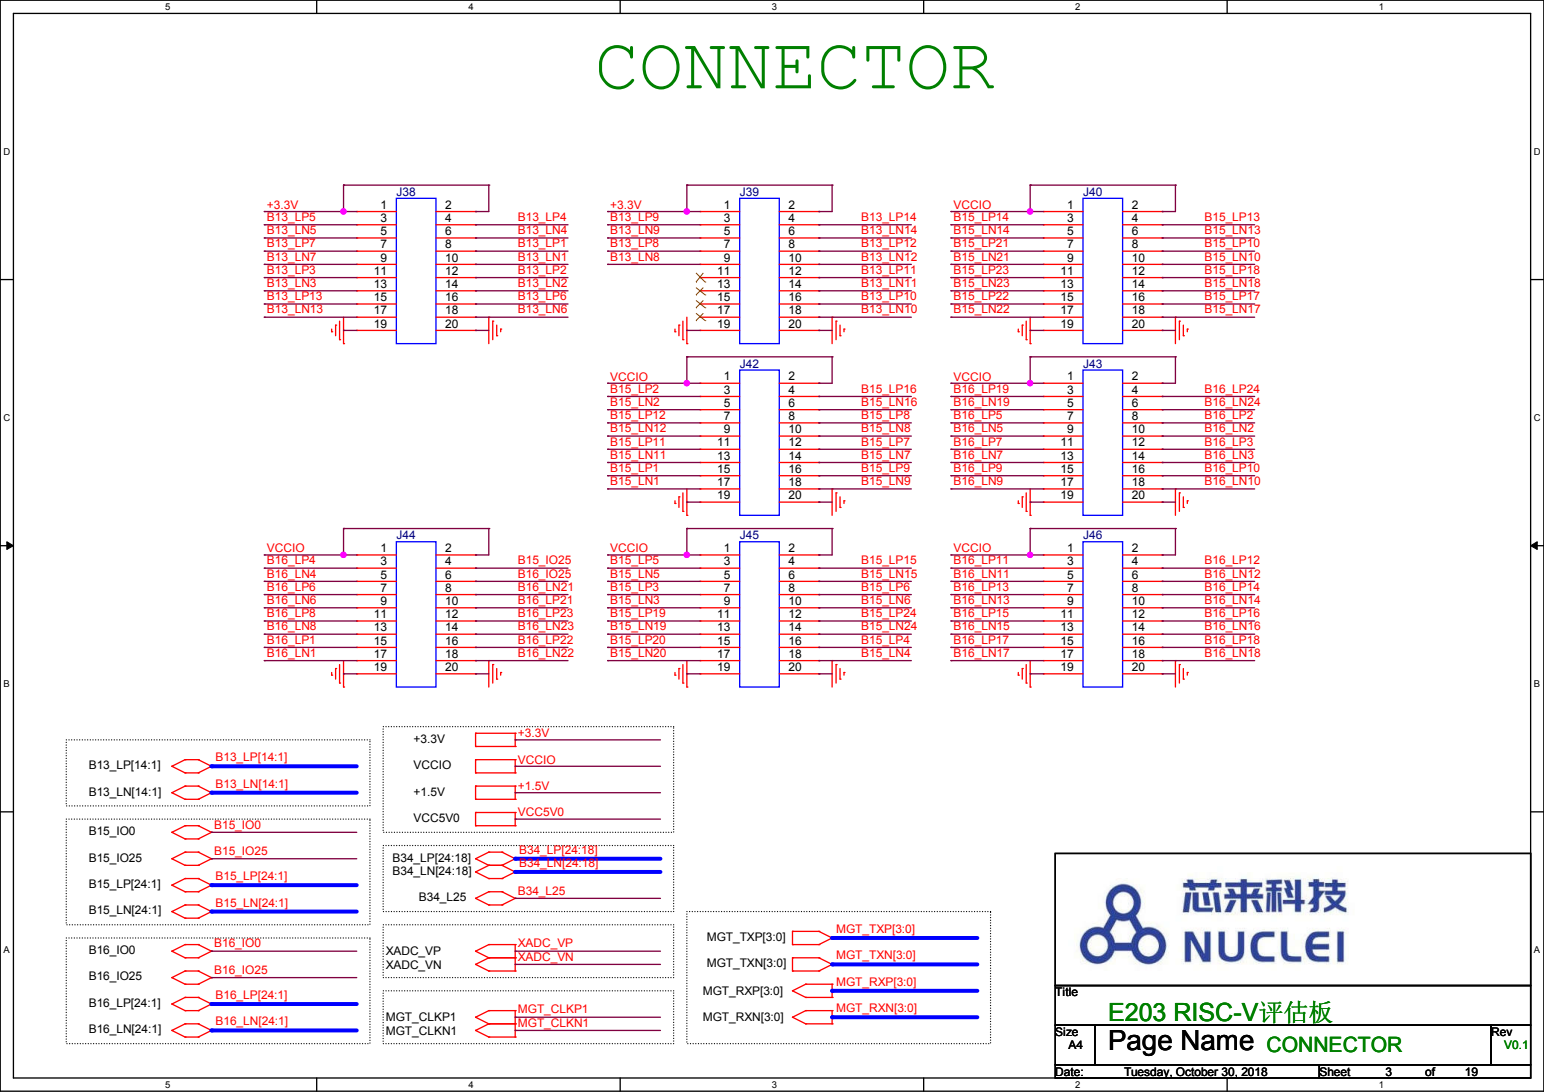
[picture p206: page 3]

# DDR3 TO TOP PORT

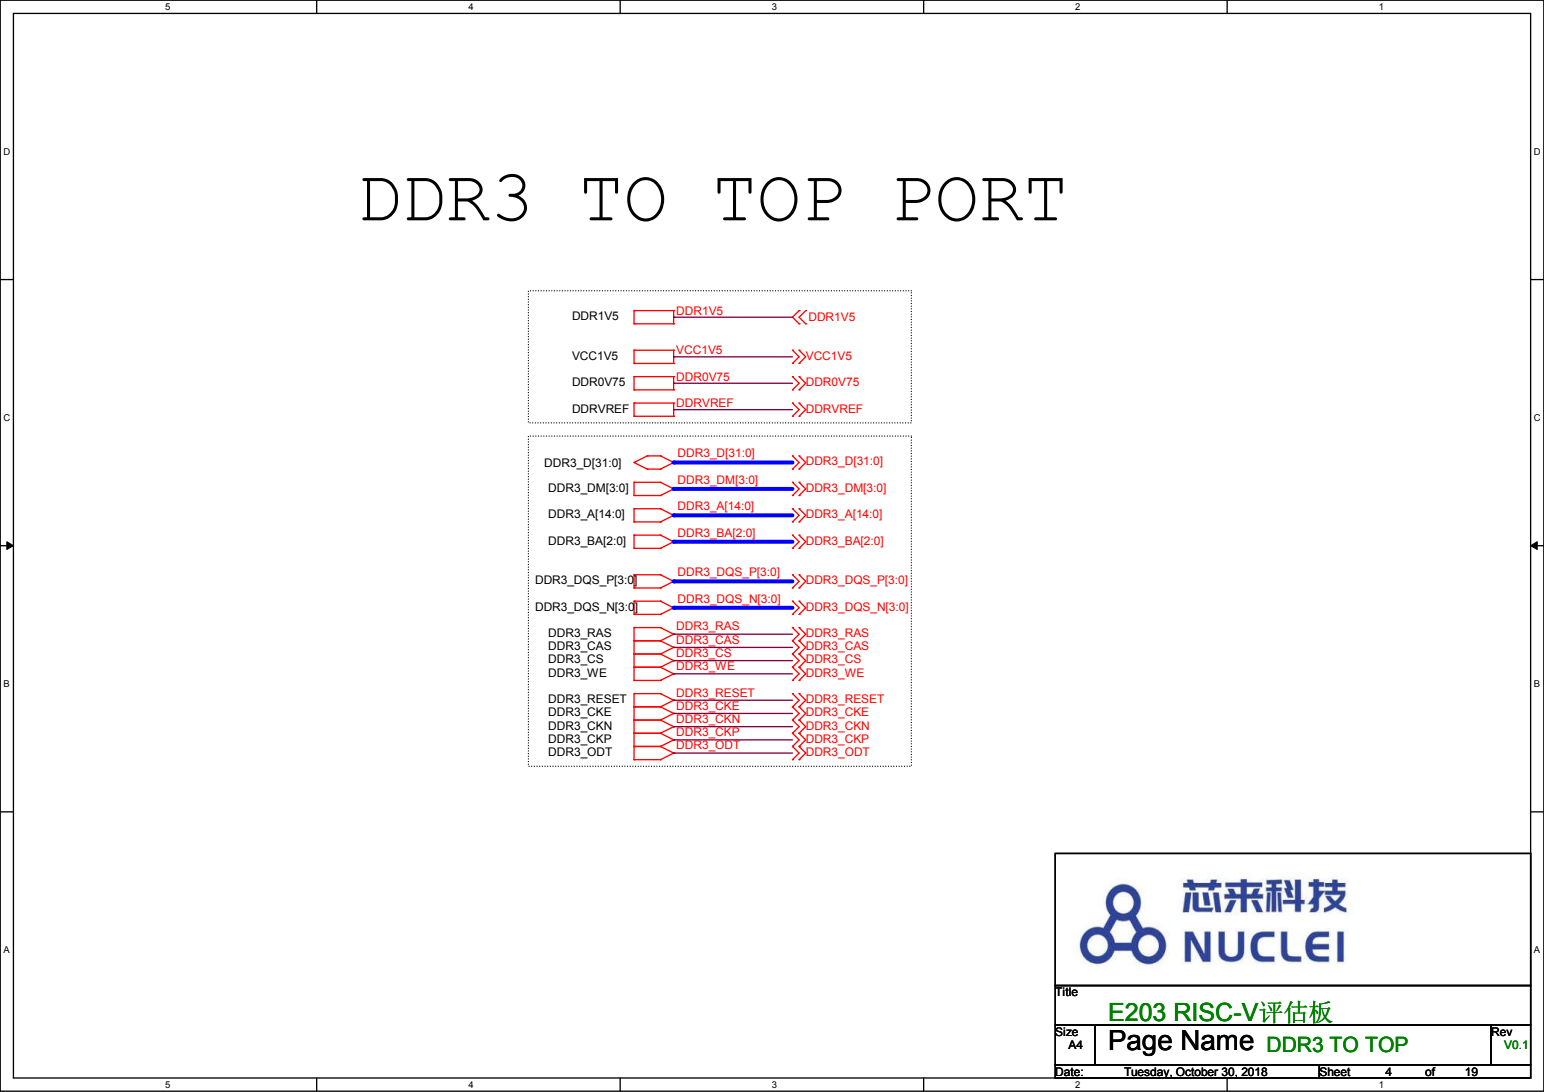
[picture p207: page 4]
VCC1V5; DDR0V75; DDRVREF; DDR3_D[31:0]; DDR3_DM[3:0]; DDR3_A[14:0]; DDR3_BA[2:0]; DDR3_RAS DDR3_CAS DDR3_CS DDR3_WE; DDR3_ODT; DDR3_RESET DDR3_CKE DDR3_CKN DDR3_CKP; DDR1V5; DDR3_DQS_P[3:0]; DDR3_DQS_N[3:0]; Title; DDR3 TO TOP; Tuesday, October 30, 2018; DDR3_RAS; DDR3_CS; DDR3_CAS; DDR3_WE; DDR3_CKE; DDR3_RESET; DDR3_CKN DDR3_CKP DDR3_ODT

# DDR3 SDRAM

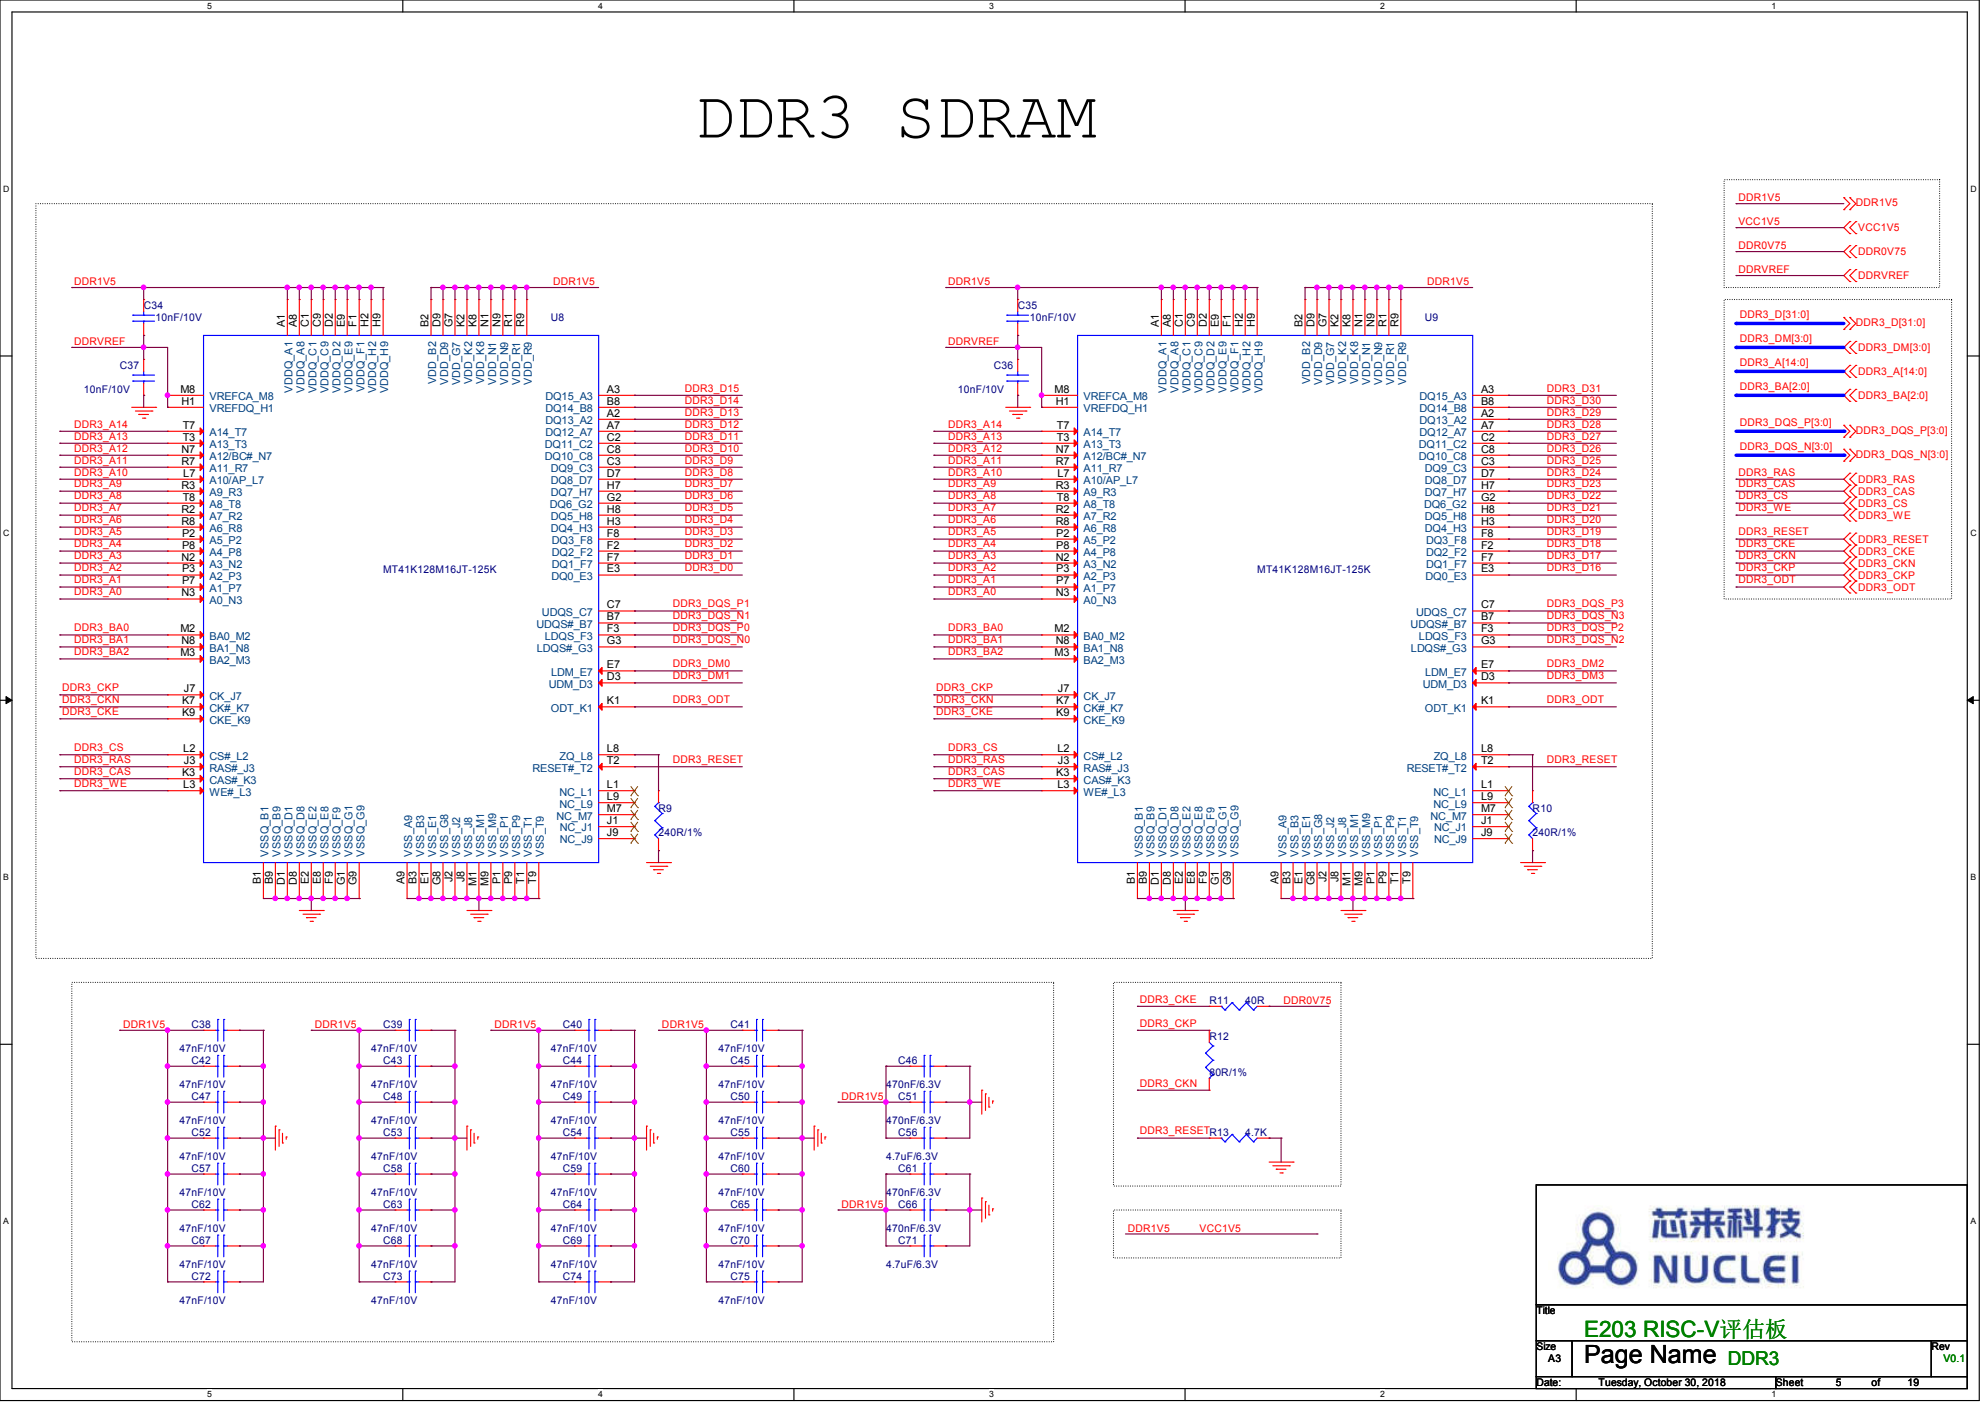
[picture p208: page 5]

# DDR3 TERMINATION

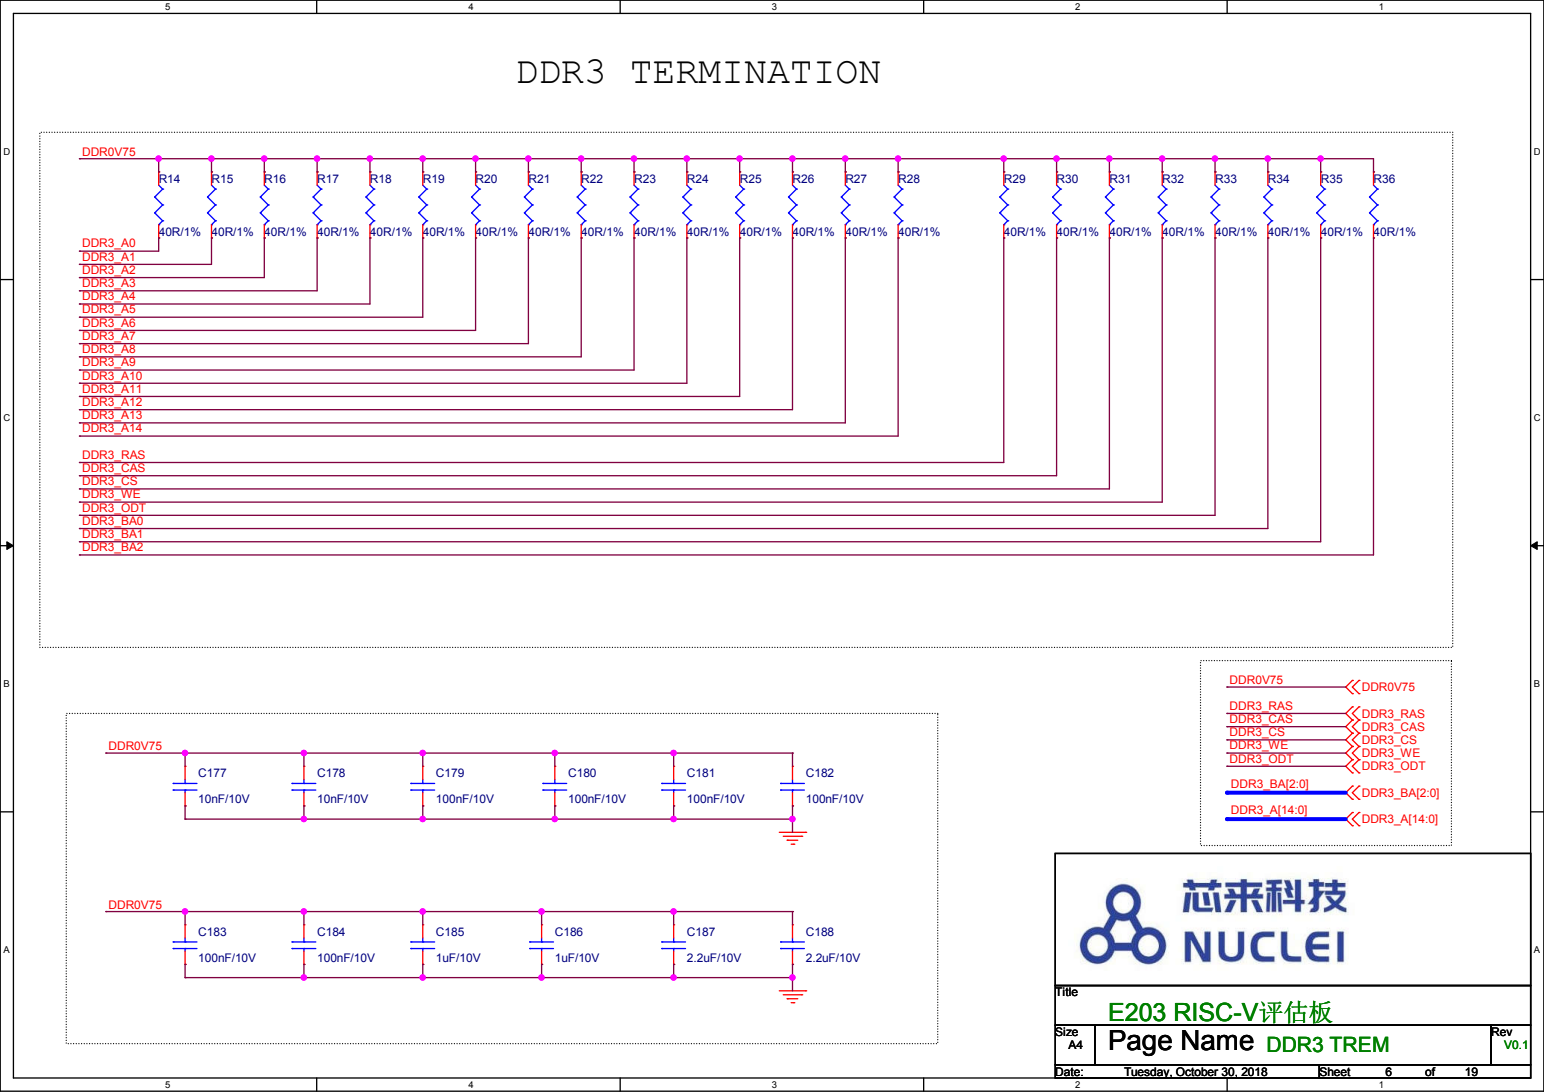
[picture p209: page 6]

# POWER TO TOP

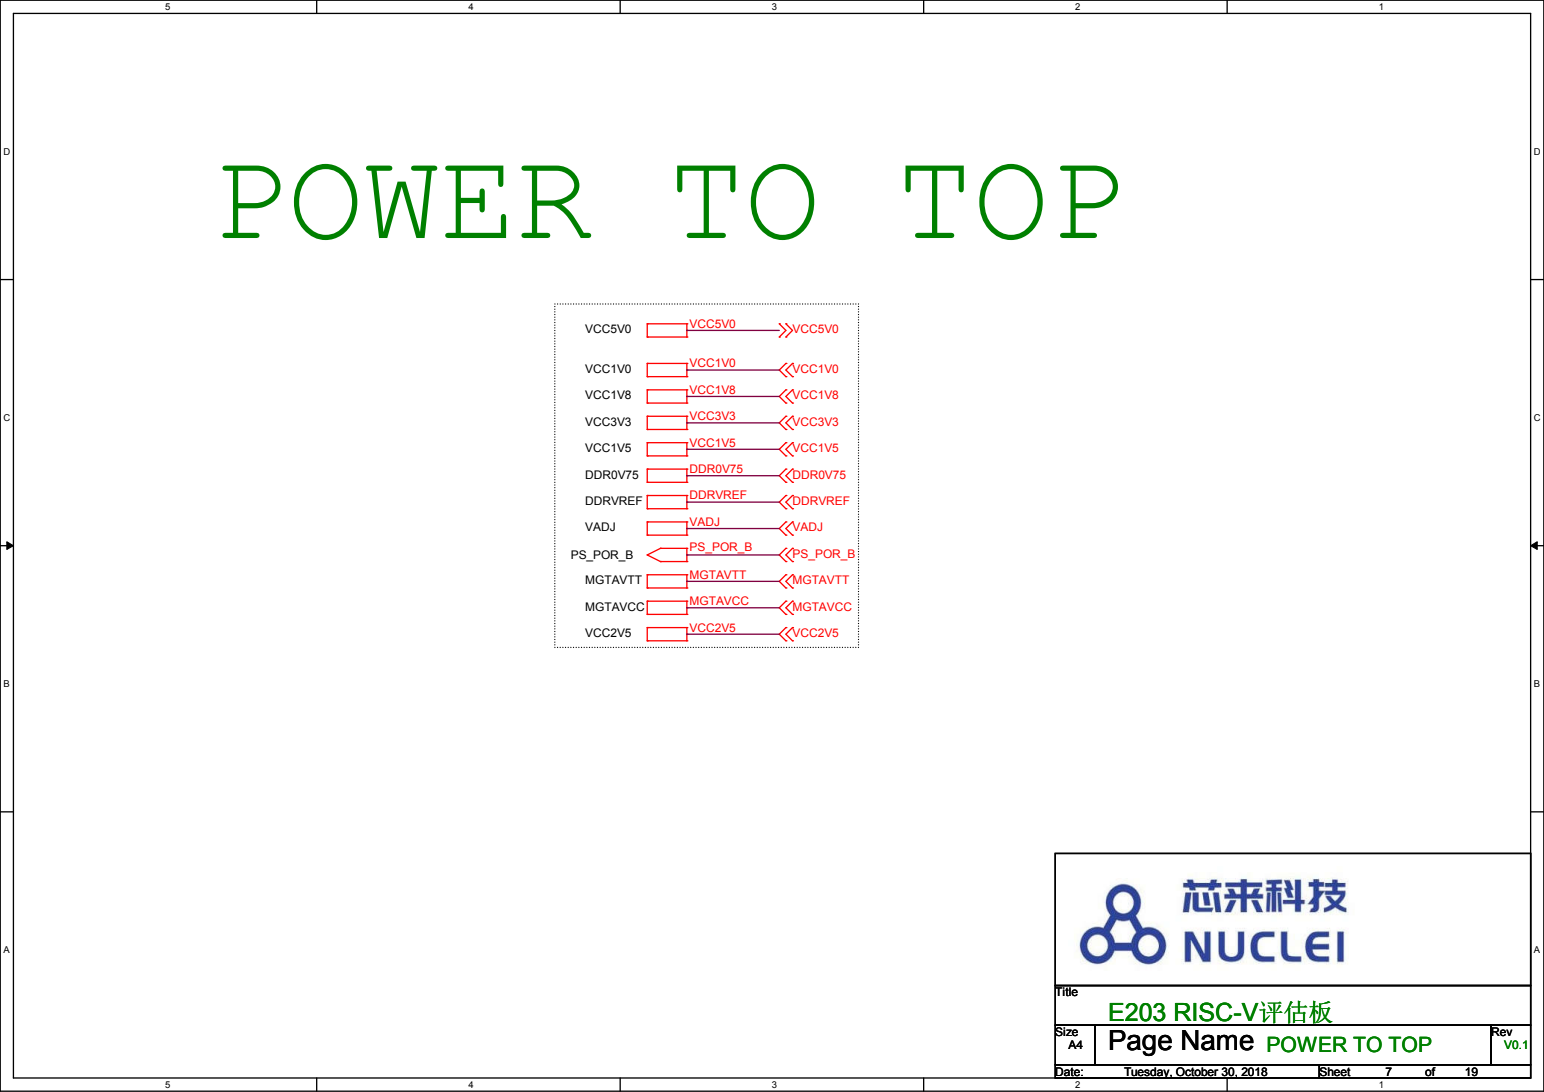
[picture p210: page 7]
VCC5V0; VCC1V0; VCC1V8; VCC3V3; VCC1V5; DDR0V75; DDRVREF; PS_POR_B; VADJ; MGTAVTT; MGTAVCC; VCC2V5; Title; POWER TO TOP; Tuesday, October 30, 2018

# XILINX CORE SUPPLY

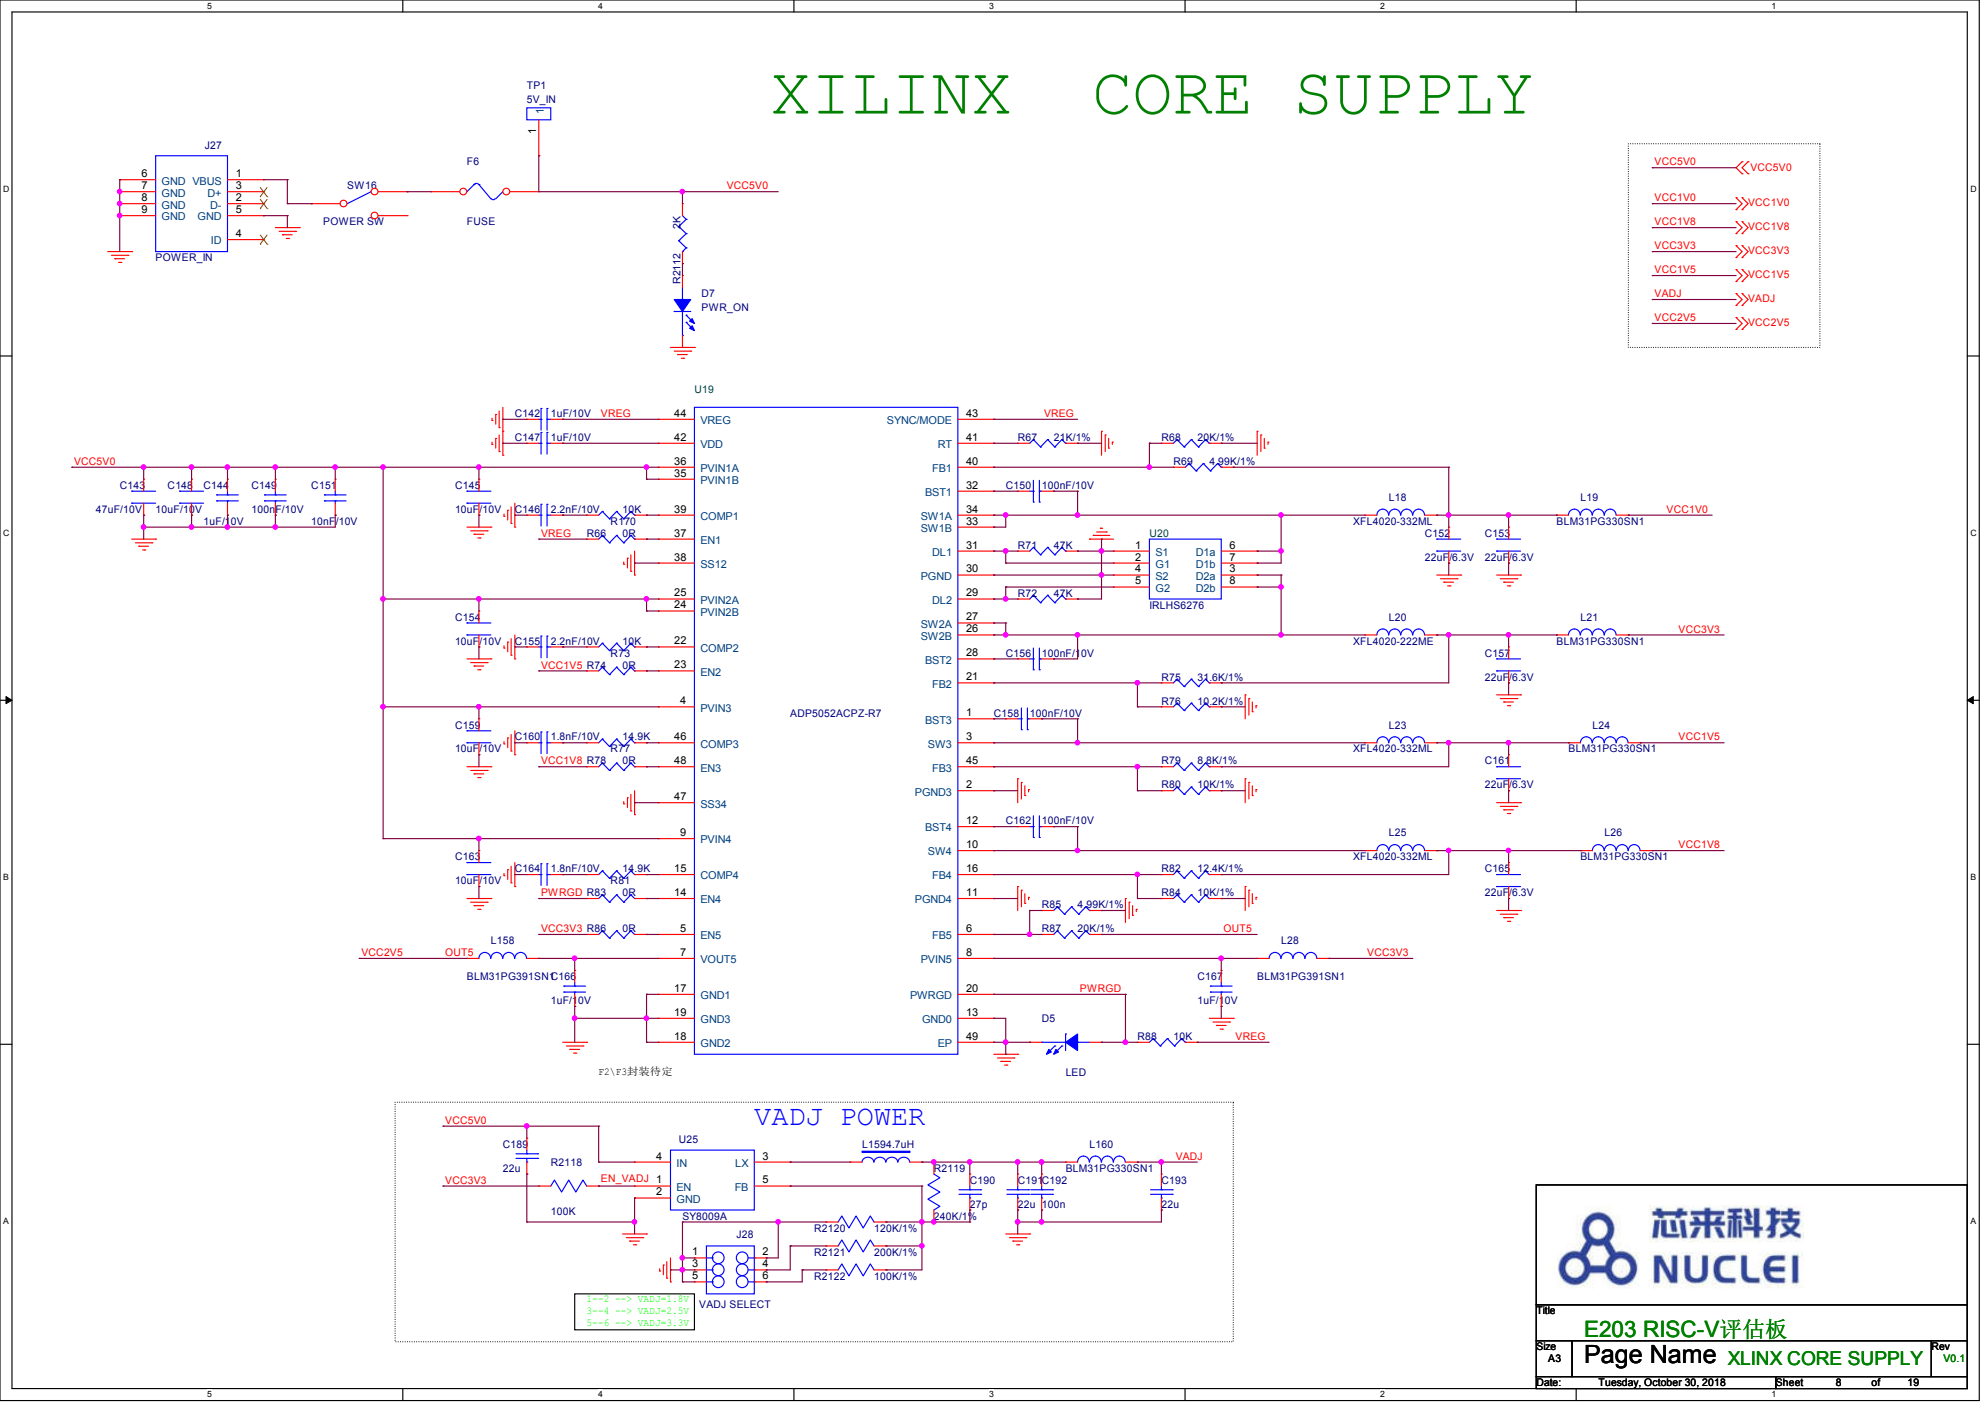
[picture p211: page 8]

DDR3 SUPPLY | DDR0V75

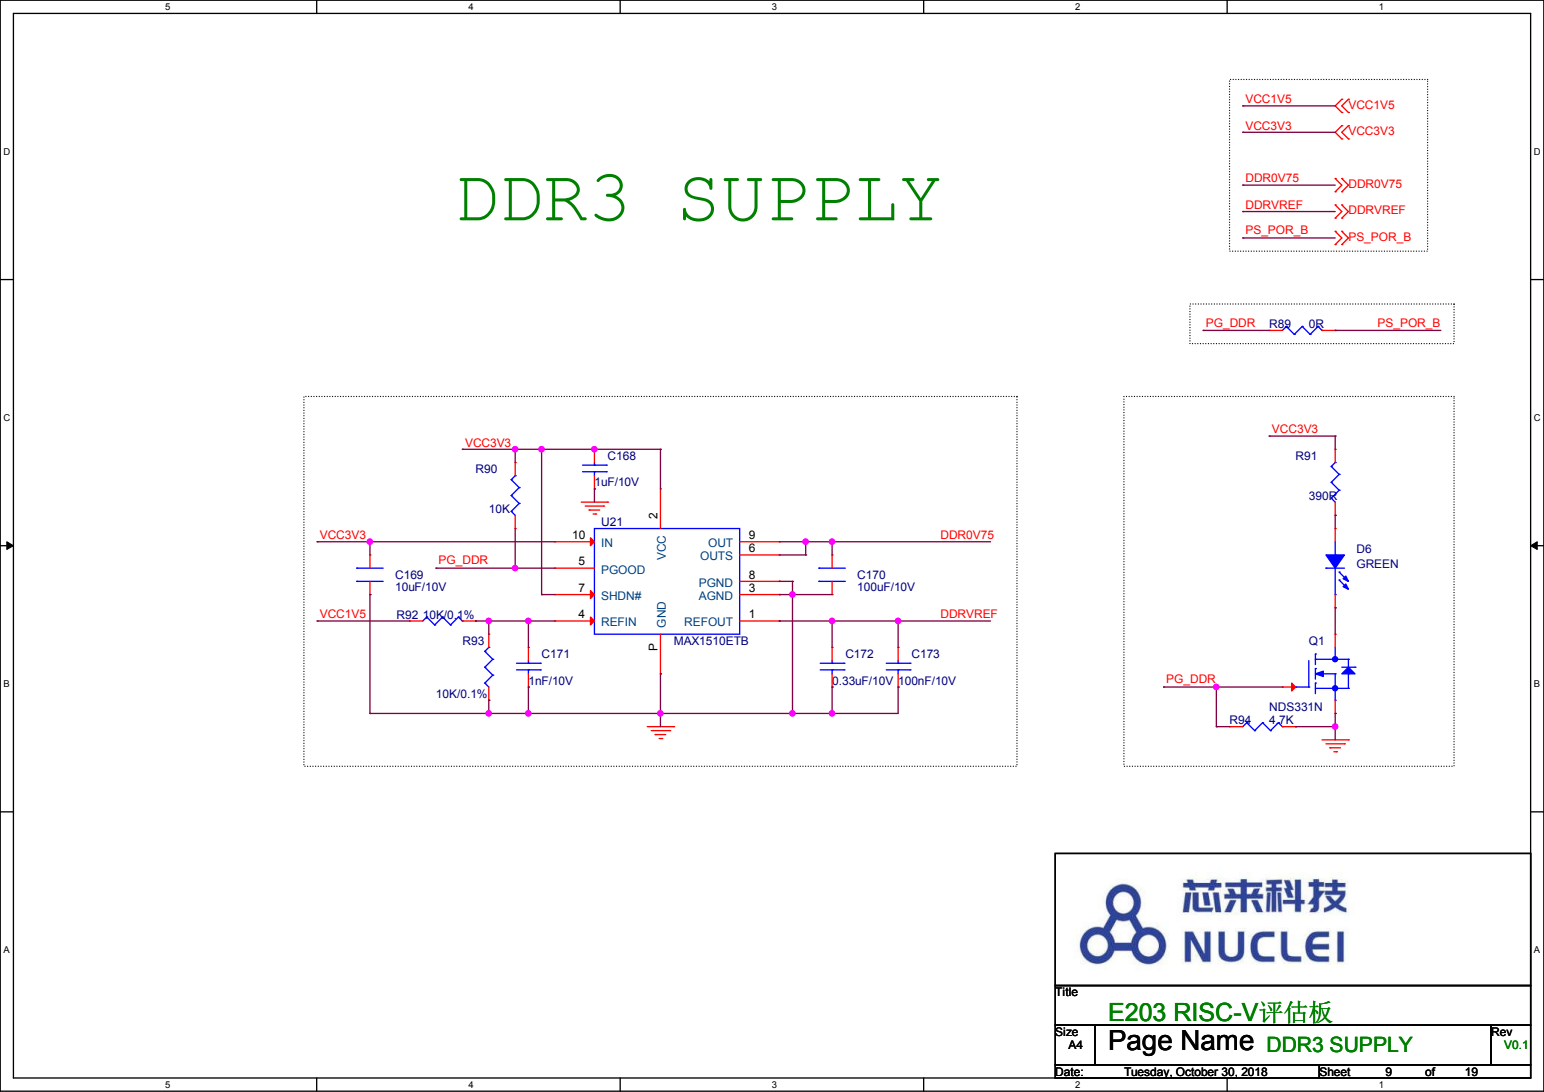
[picture p212: page 9]

# MGT POWER

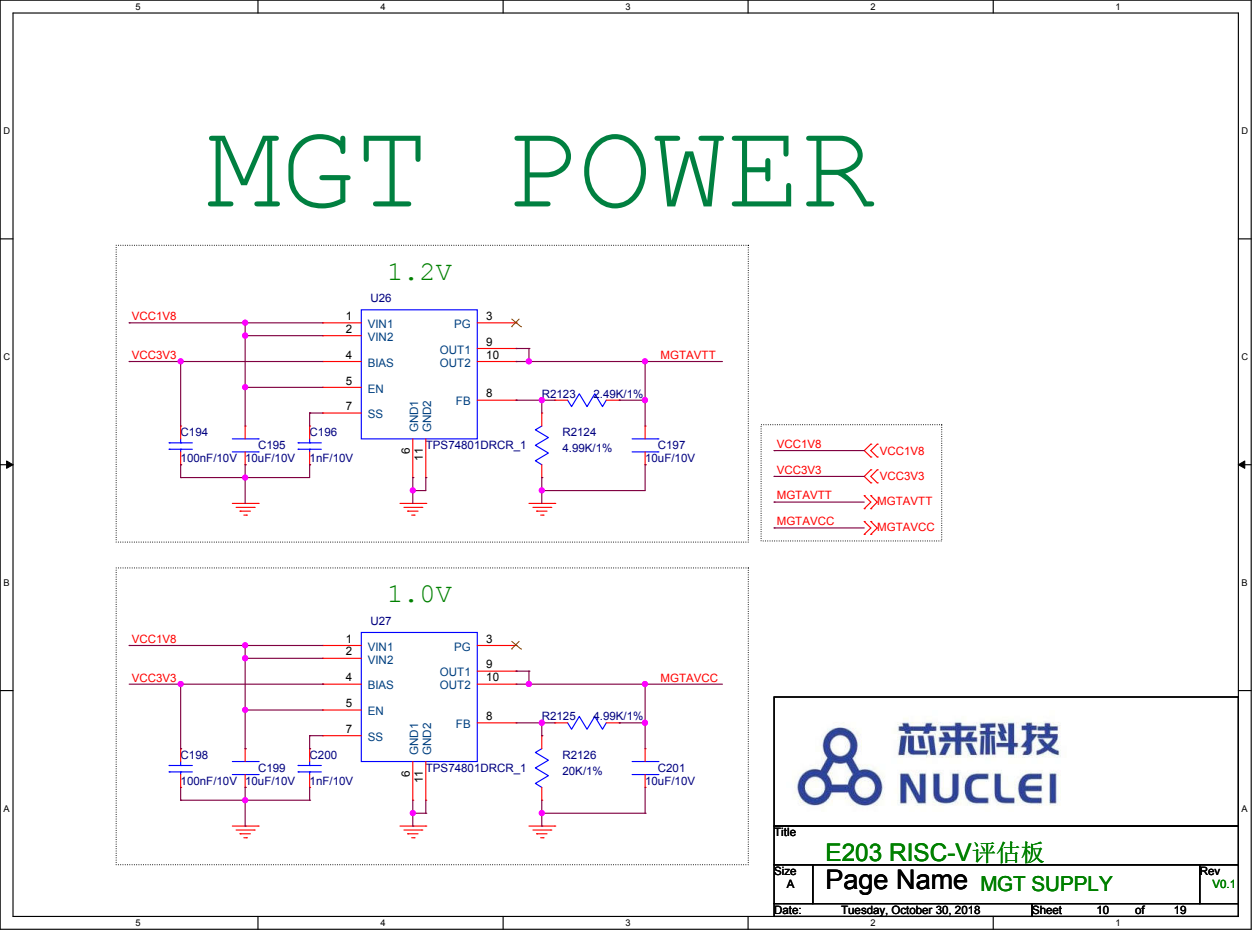
[picture p213: page 10]

# USER INTERACTIVE

## GPIO JACK

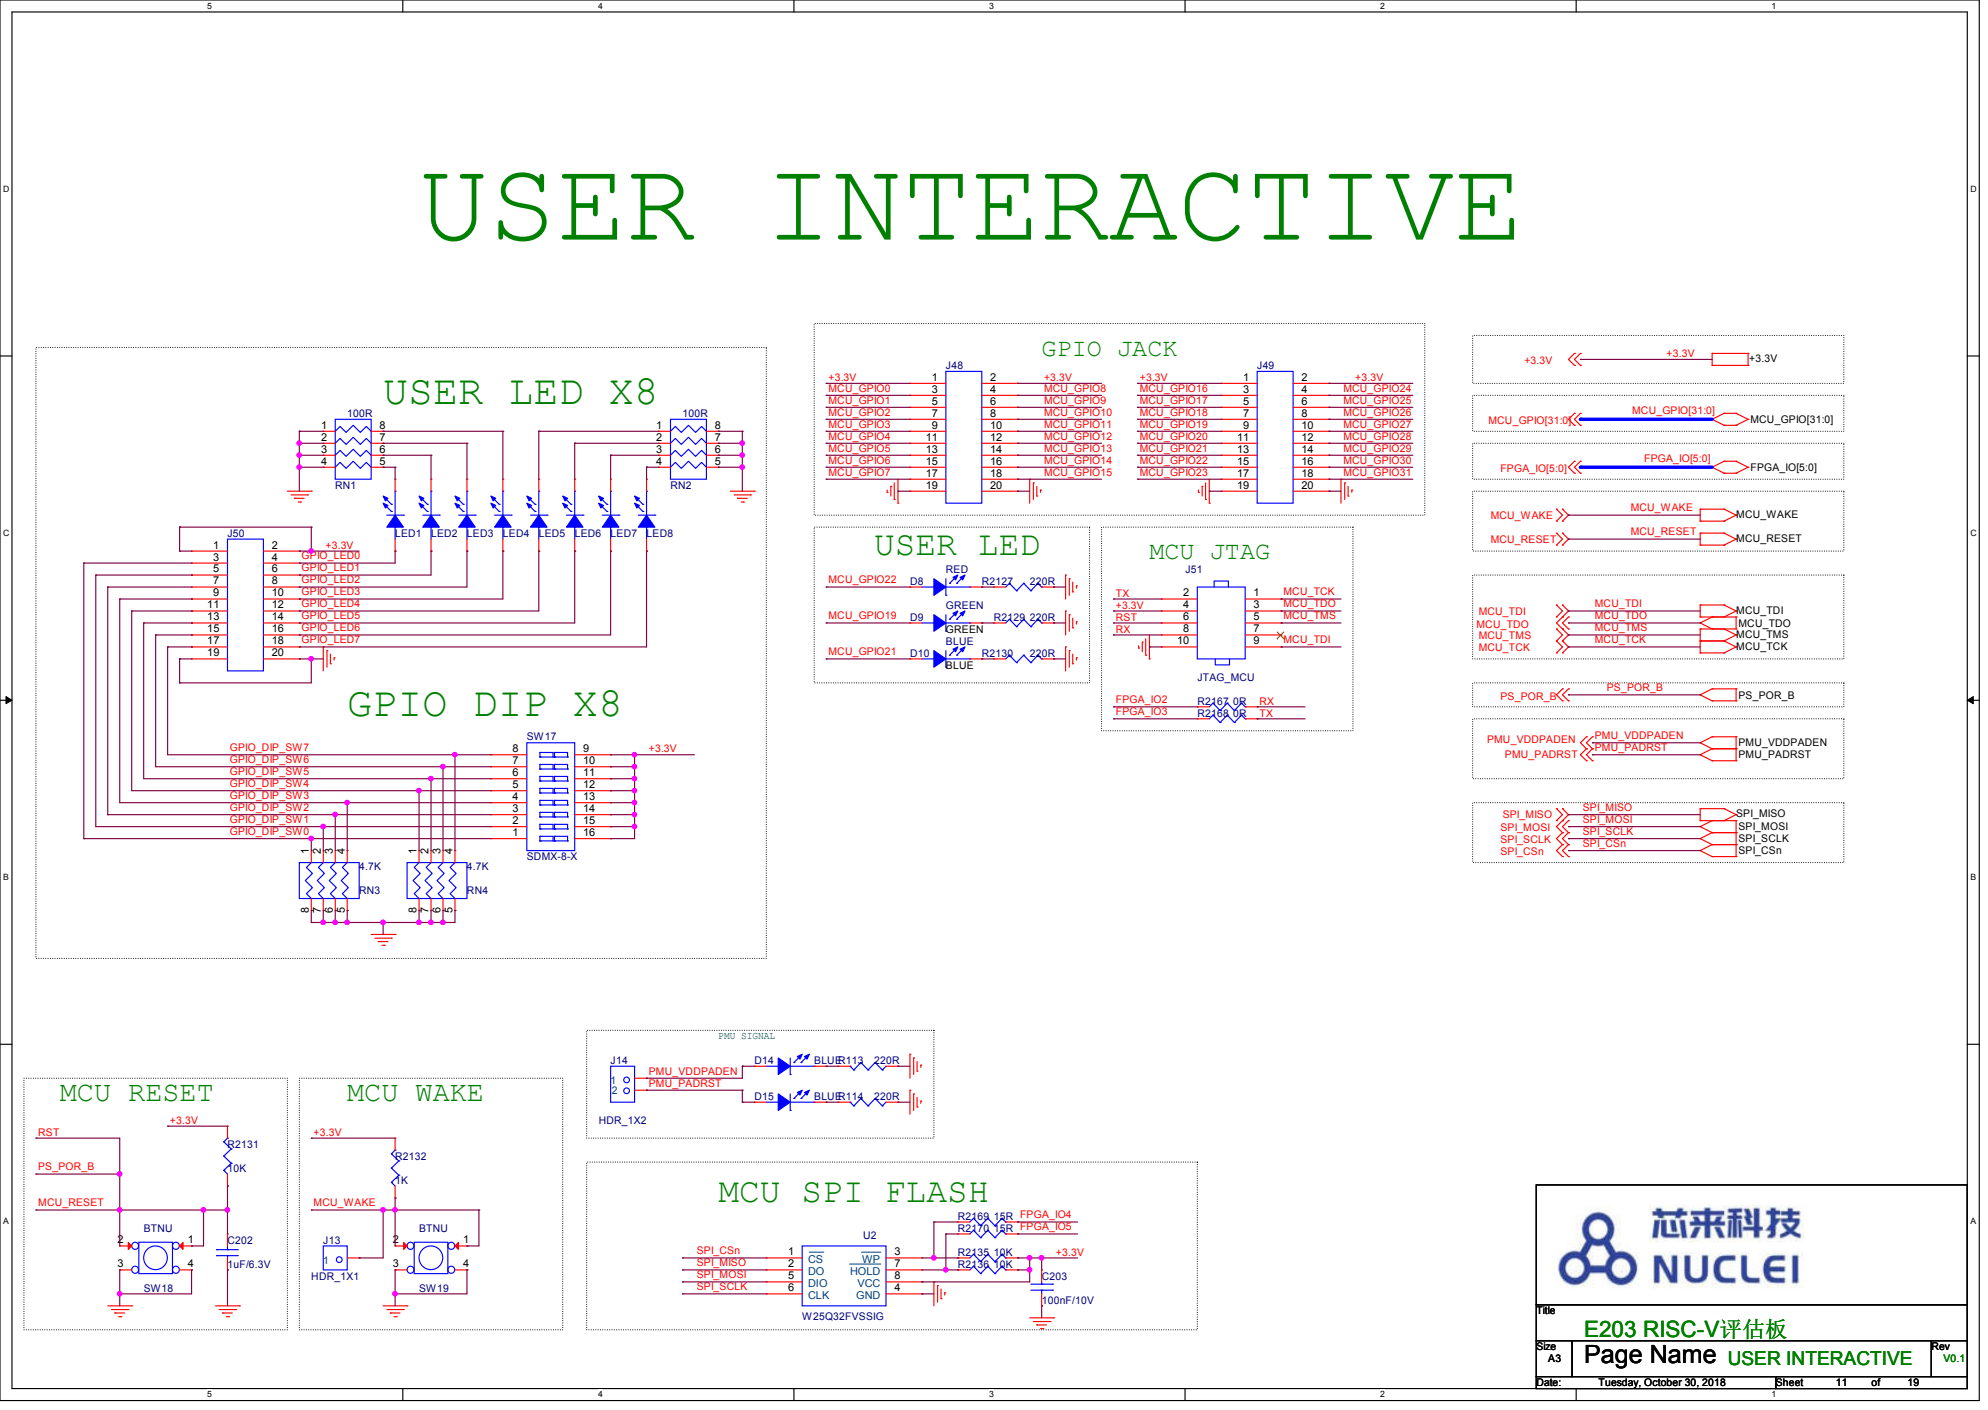
[picture p214: page 11]

# XC7A100T PORT TO TOP

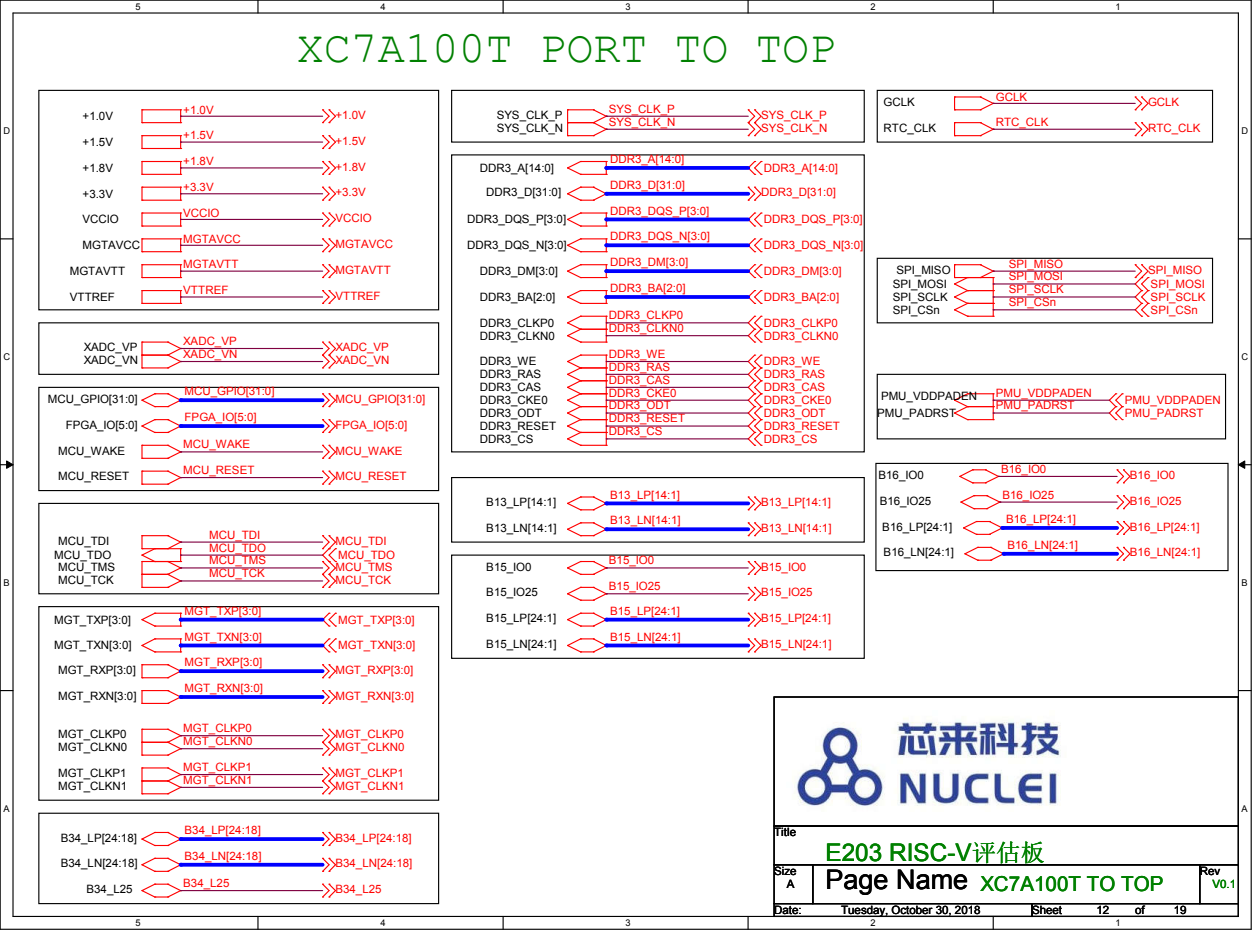
[picture p215: page 12]
XADC_VP XADC_VN; MCU_GPIO[31:0]; FPGA_IO[5:0]; MCU_RESET; MCU_WAKE; MCU_TDI; MCU_TMS MCU_TCK; MCU_TDO; MGT_TXP[3:0]; MGT_TXN[3:0]; MGT_RXP[3:0]; MGT_RXN[3:0]; MGT_CLKP0 MGT_CLKN0; MGT_CLKP1 MGT_CLKN1; SYS_CLK_P SYS_CLK_N; DDR3_A[14:0]; DDR3_D[31:0]; DDR3_DQS_P[3:0]; DDR3_DQS_N[3:0]; DDR3_DM[3:0]; DDR3_BA[2:0]; DDR3_CLKP0 DDR3_CLKN0; DDR3_WE DDR3_RAS DDR3_CAS DDR3_CKE0; DDR3_RESET; RTC_CLK; GCLK; VCCIO; MGTAVCC; MGTAVTT; VTTREF; DDR3_CS; DDR3_ODT; PMU_VDDPADEN; PMU_PADRST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

# FPGA & MCU CONFIG

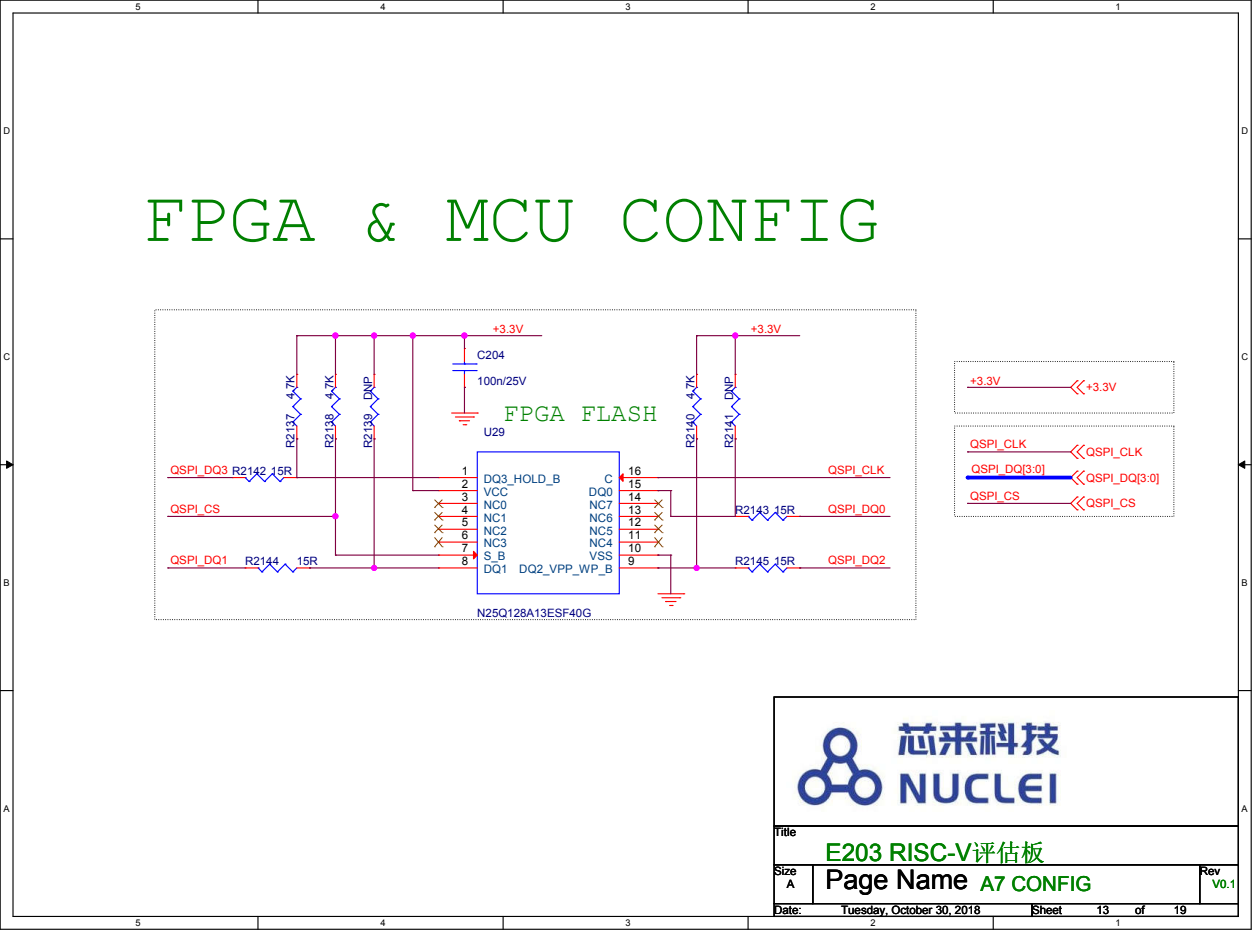
[picture p216: page 13]

# BANK0

## BANK0

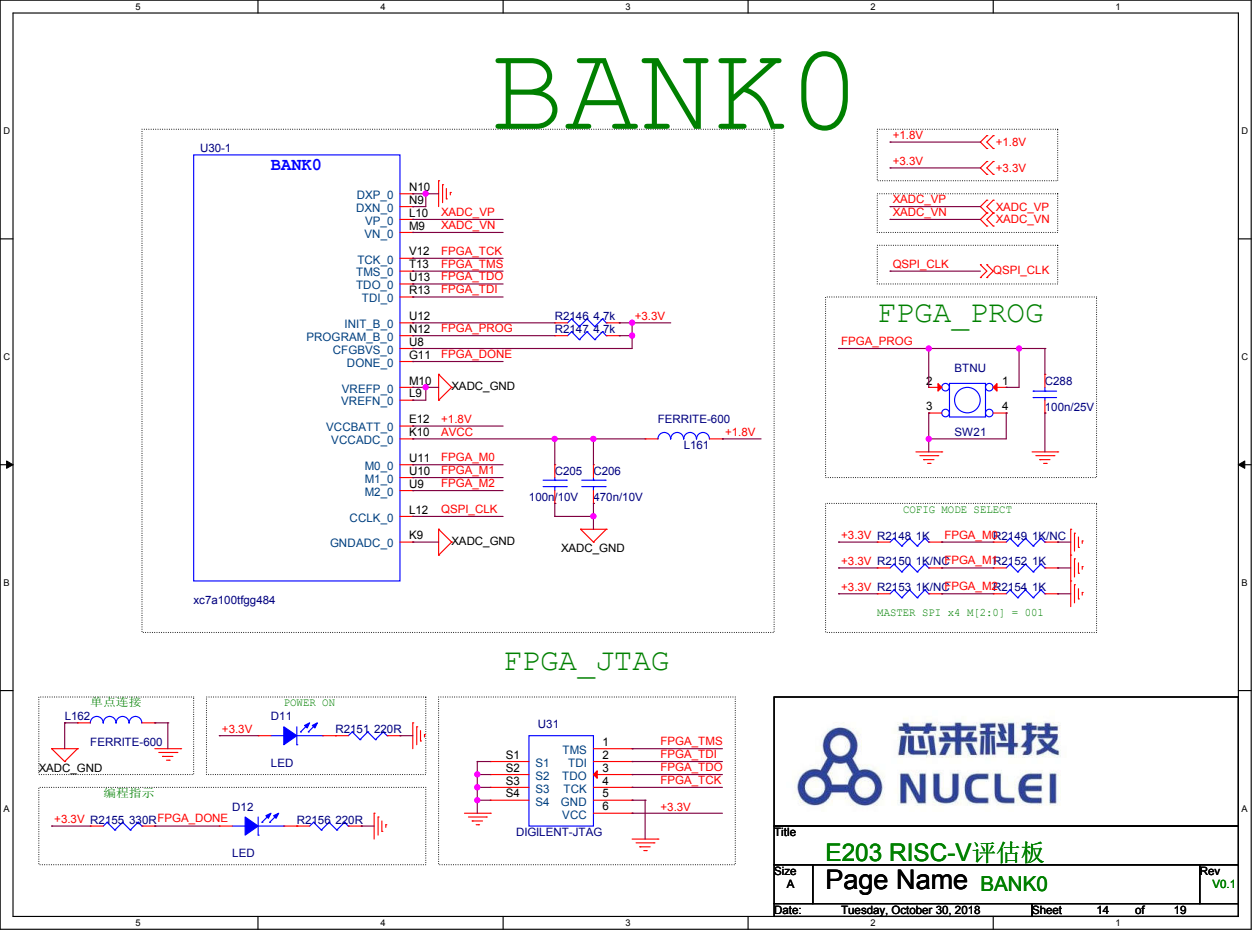
[picture p217: page 14]

# BANK13 & BANK14

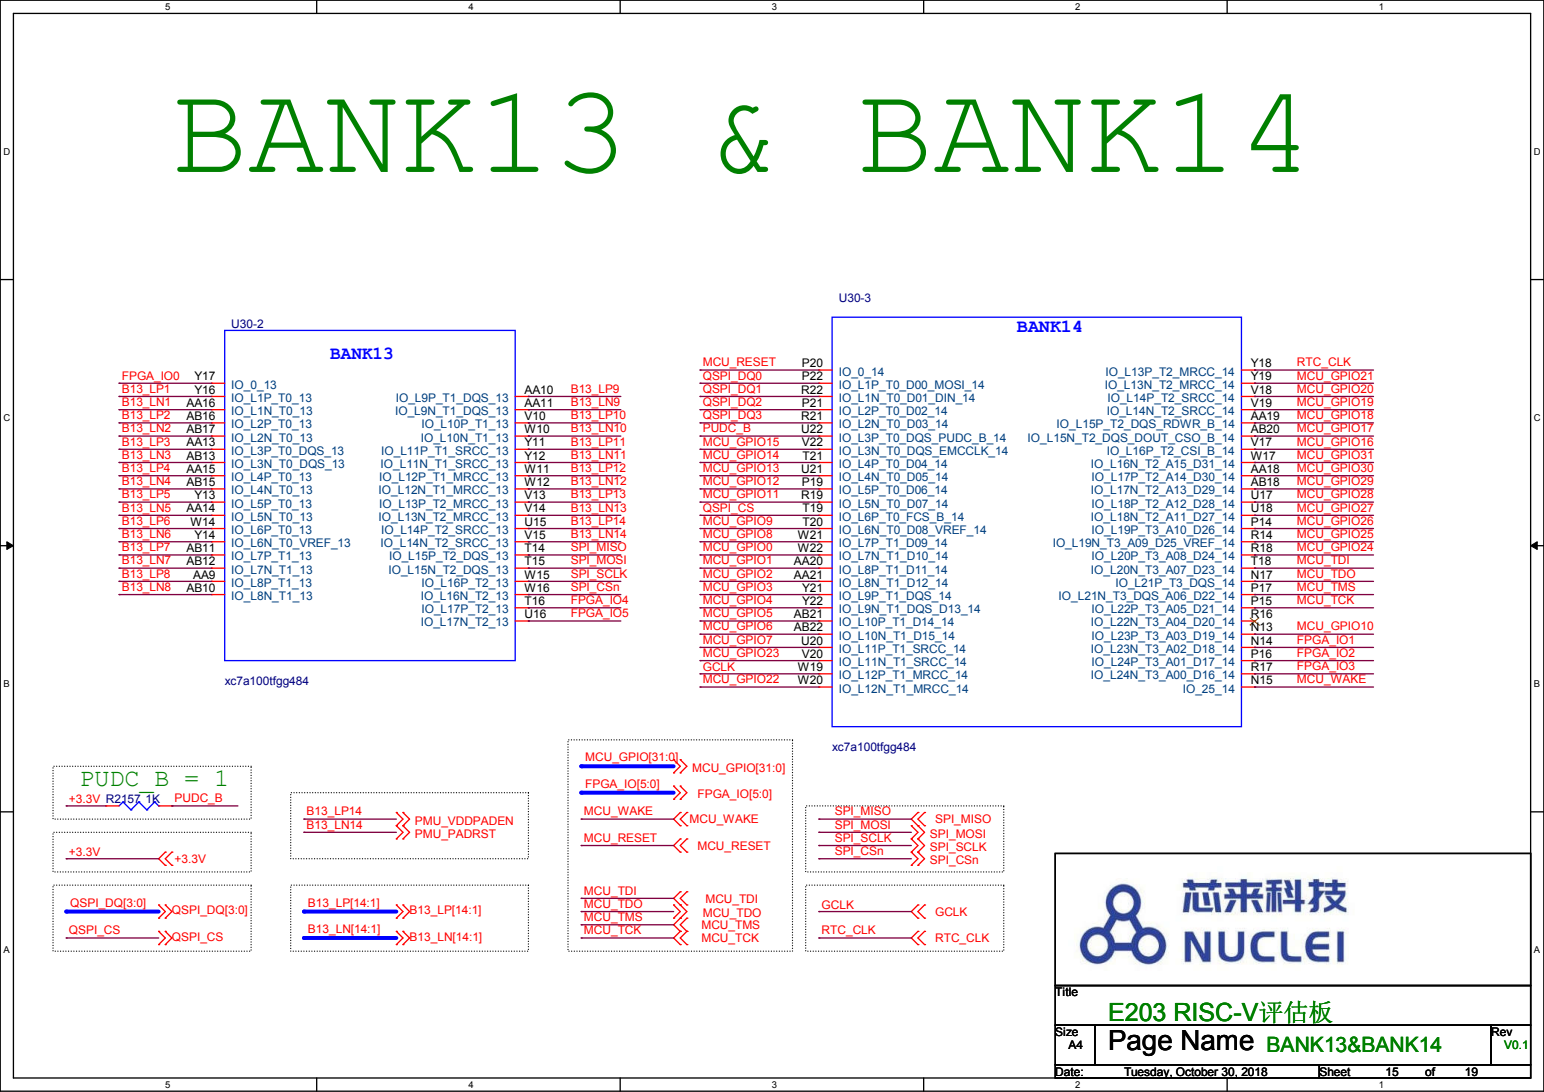
[picture p218: page 15]

# BANK15 & BANK16

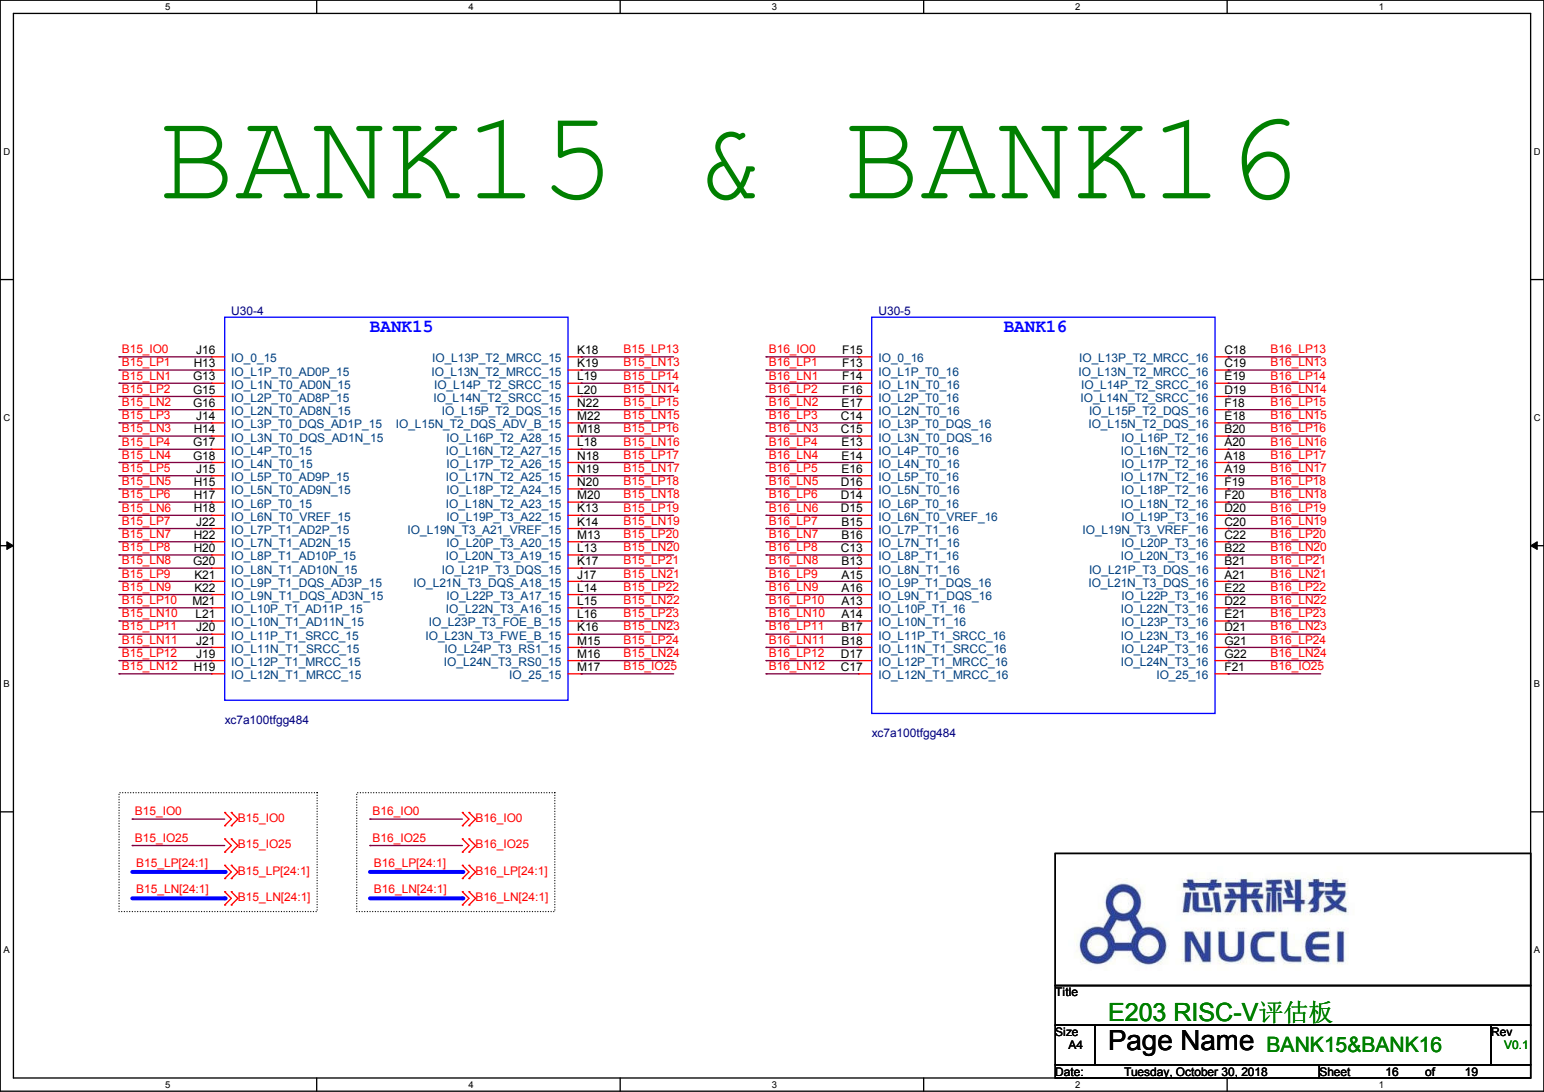
[picture p219: page 16]

# BANK34 & BANK35

## BANK35

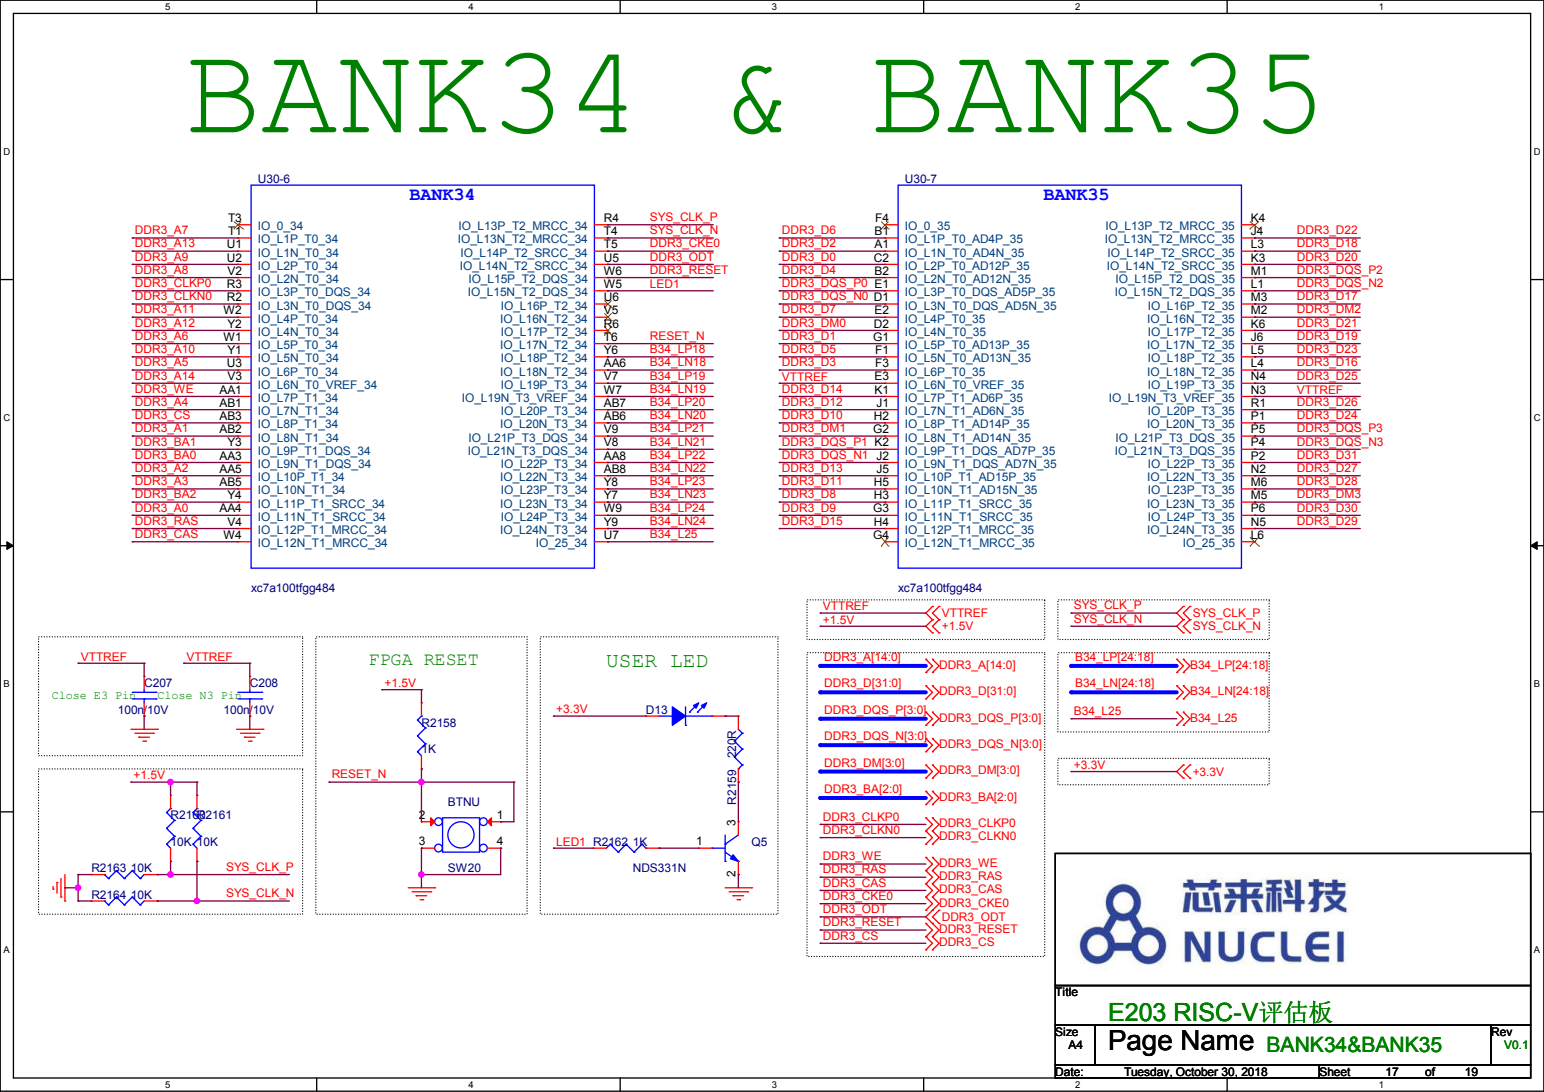
[picture p220: page 17]

# BANK216

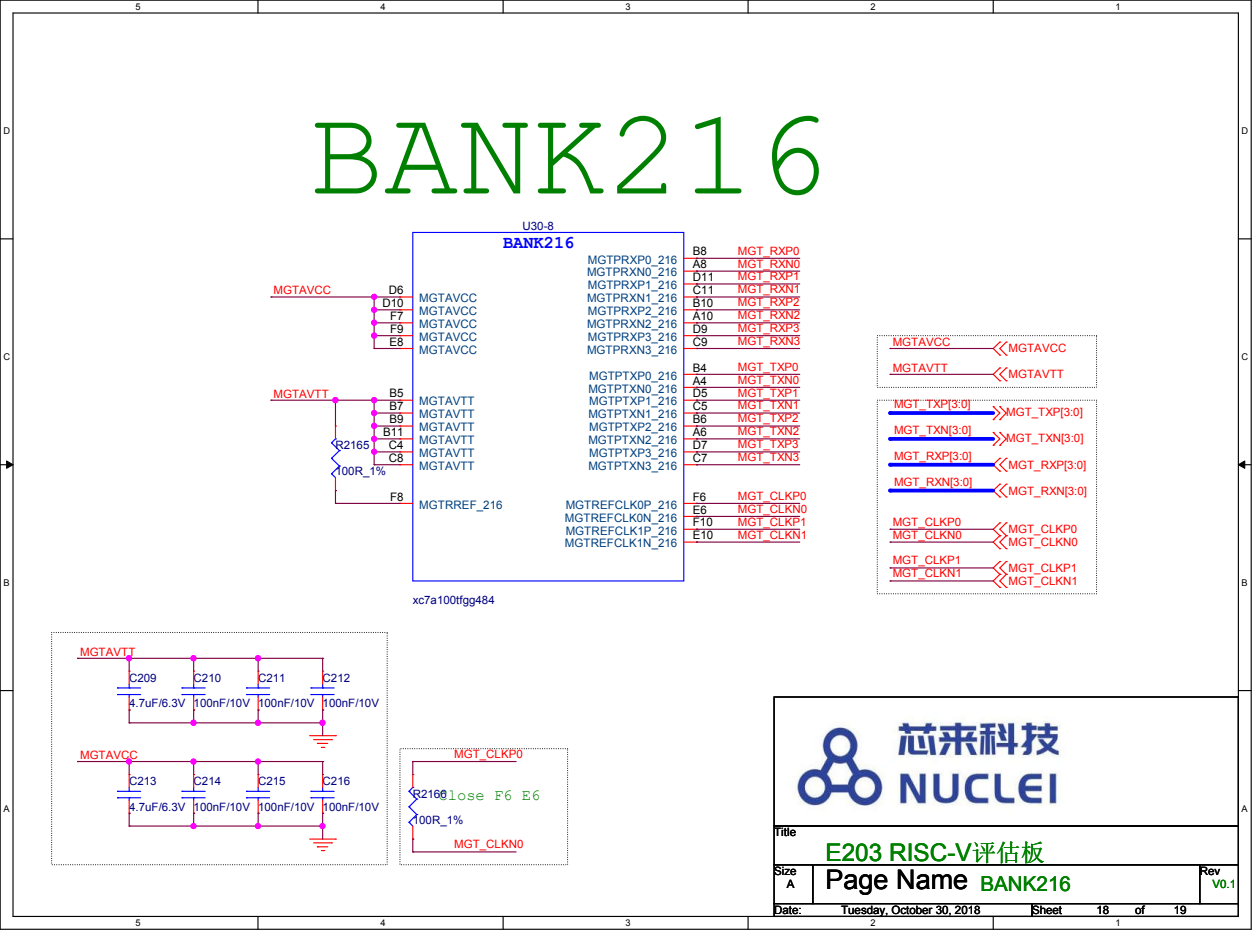
[picture p221: page 18]

# BANK POWER

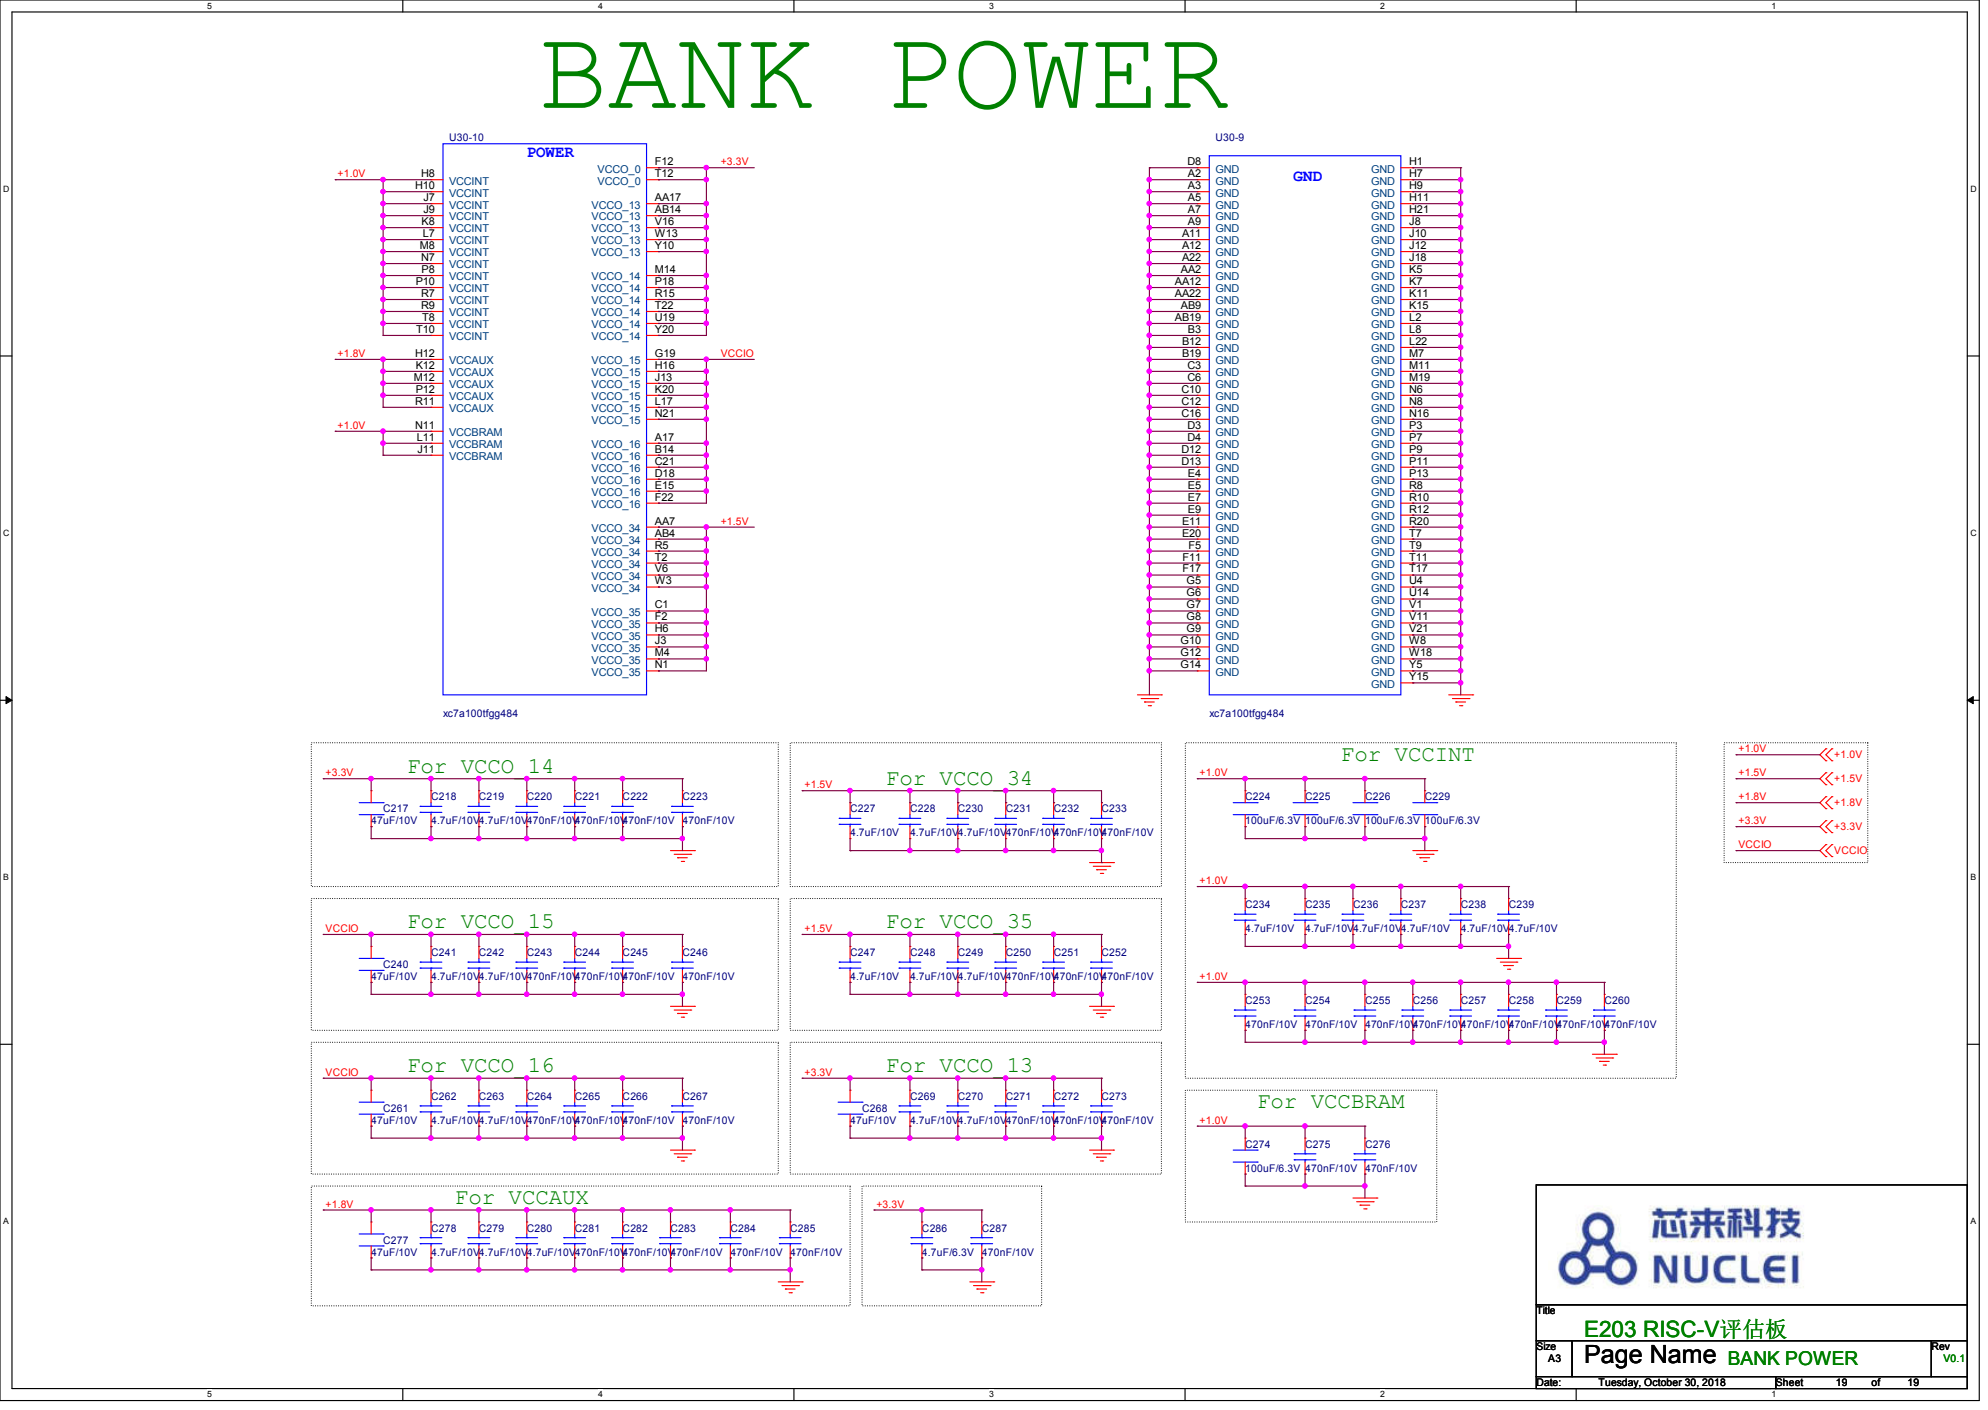
[picture p222: page 19]
