xiaoerlang0359/E203plus/JTAG/convert.pdf

5

4

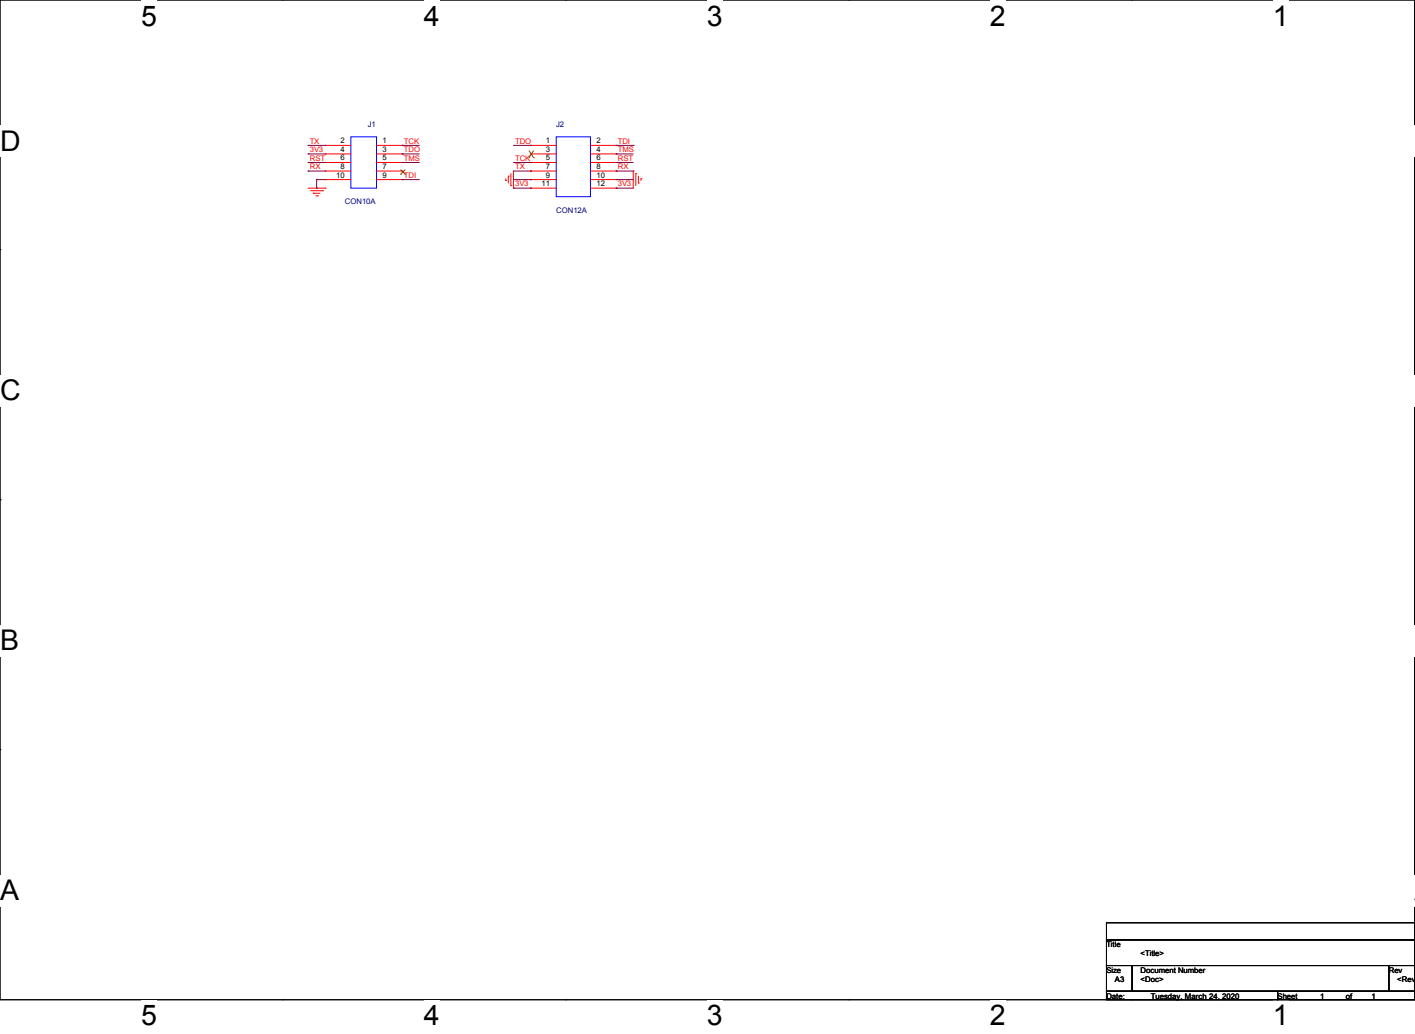
[picture p223: page 1]
Title; Size; Document Number; Rev; Date:; Sheet; <Doc>; <RevCode>; <Title>; Tuesday, March 24, 2020; CON10A; CON12A; TX 3V3 RST RX; TCK TDO TMS; TDI; TDO; TCK TX; TDI TMS RST RX
