xiaoerlang0359/E203plus/boards/hbirdkit/Hummingbird EV KIT.pdf

# CONNECTOR

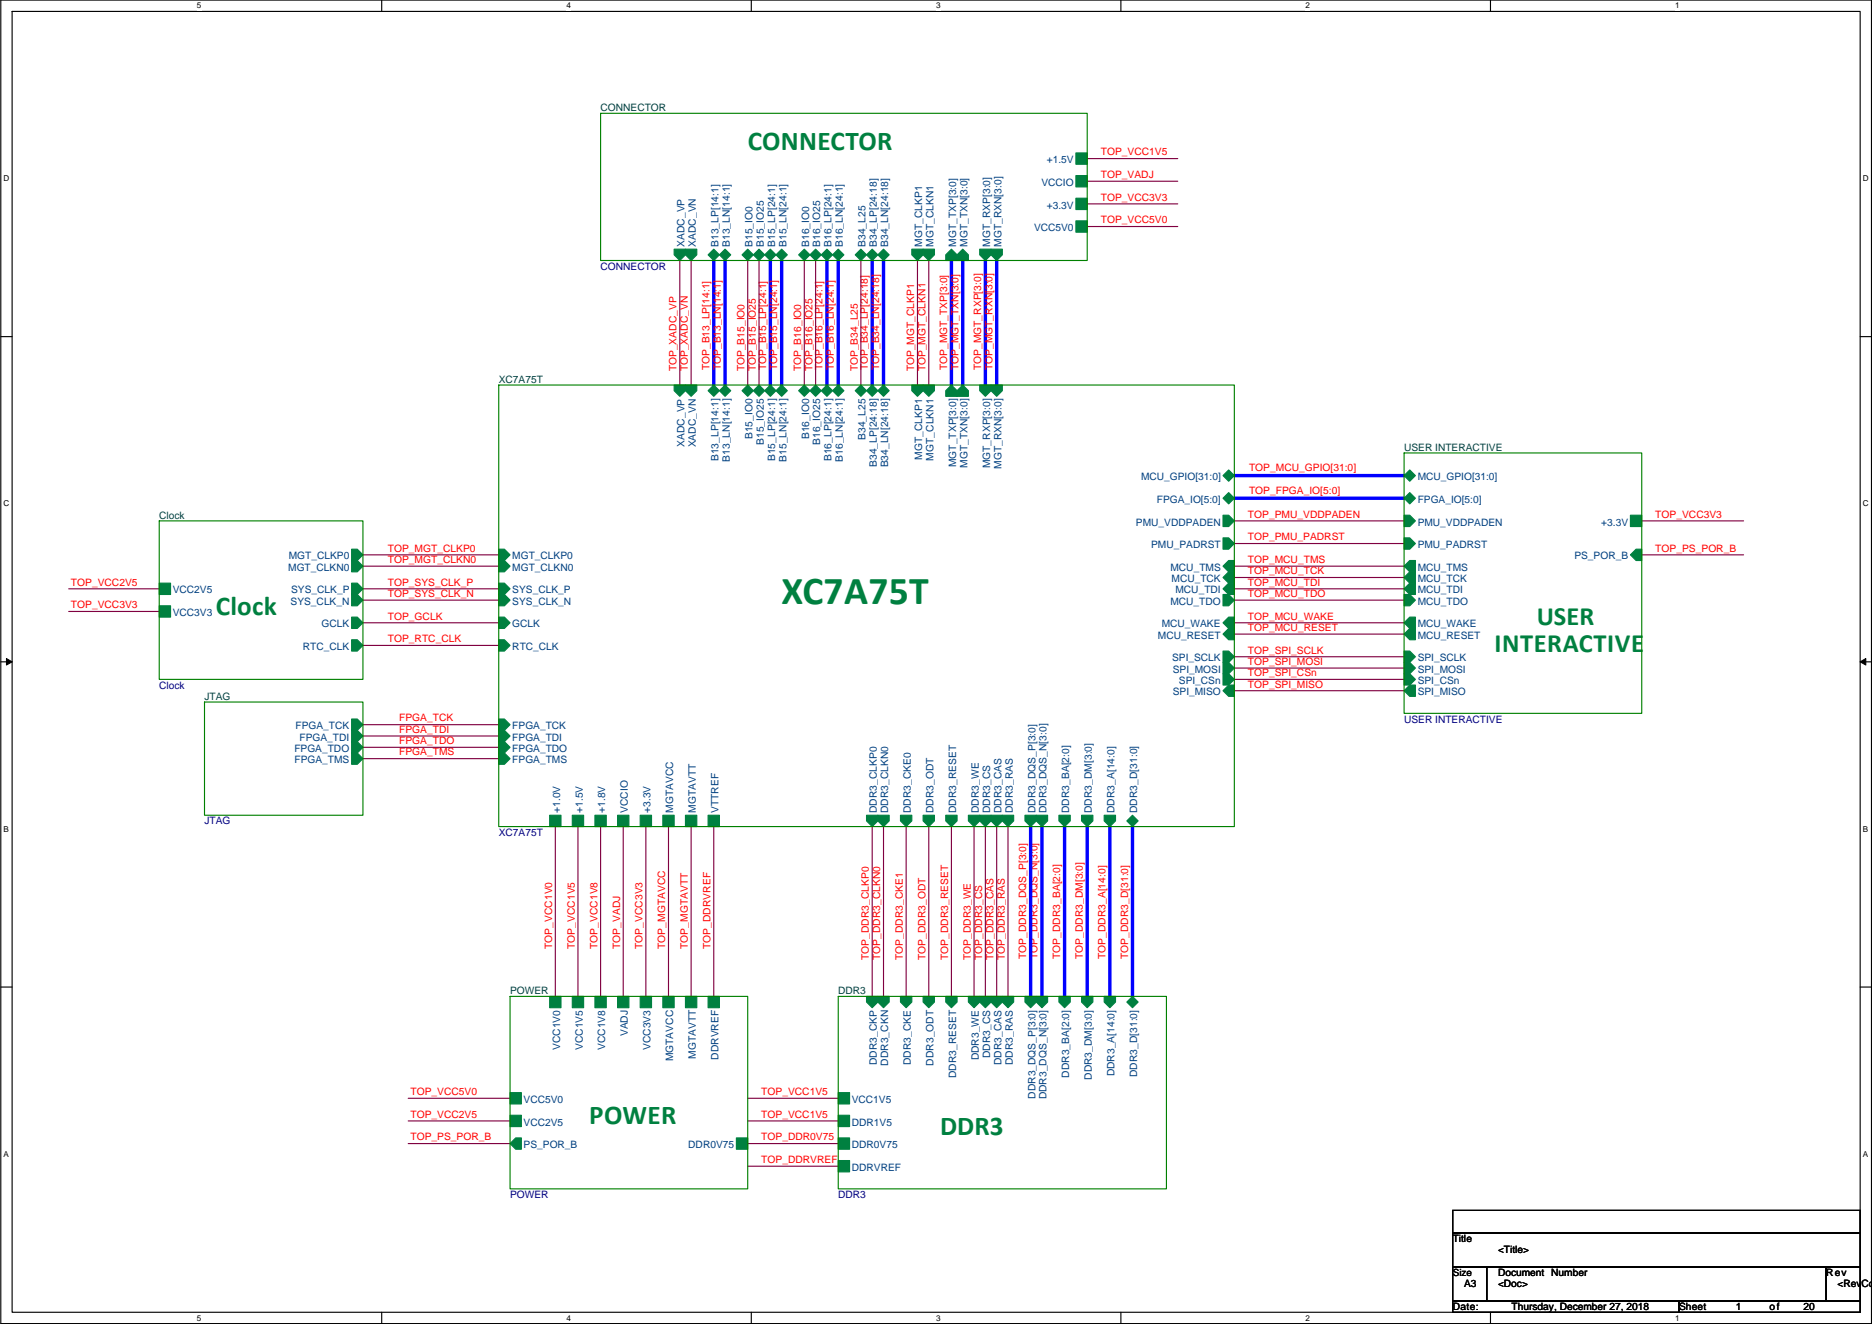
[picture p224: page 1]
XC7A75T Clock; POWER; DDR3; USER INTERACTIVE; TOP_XADC_VP; TOP_XADC_VN; TOP_B13_LP[14:1]; TOP_B13_LN[14:1]; TOP_B15_IO0; TOP_B15_IO25; TOP_B15_LP[24:1]; TOP_B15_LN[24:1]; TOP_B16_IO0; TOP_B16_IO25; TOP_B16_LP[24:1]; TOP_B16_LN[24:1]; TOP_B34_L25; TOP_B34_LP[24:18]; TOP_B34_LN[24:18]; TOP_MGT_CLKP1; TOP_MGT_CLKN1; TOP_MGT_TXP[3:0]; TOP_MGT_TXN[3:0]; TOP_MGT_RXP[3:0]; TOP_MGT_RXN[3:0]; TOP_VCC5V0; TOP_VCC3V3; TOP_VADJ; TOP_VCC1V5; TOP_PS_POR_B; TOP_MCU_GPIO[31:0]; TOP_FPGA_IO[5:0]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

TOP_SYS_CLK_N | TOP_MCU_TDO

TOP_GCLK | TOP_MCU_WAKE
TOP_RTC_CLK | TOP_MCU_RESET

Size A3 | Document Number <Doc> <Doc> <Doc> | Rev <RevCo <RevCo <RevCo

Date: Thursday, December 27, 2018 Thursday, December 27, 2018 Thursday, December 27, 2018 | Sheet 1 1 1 of 20 20 20

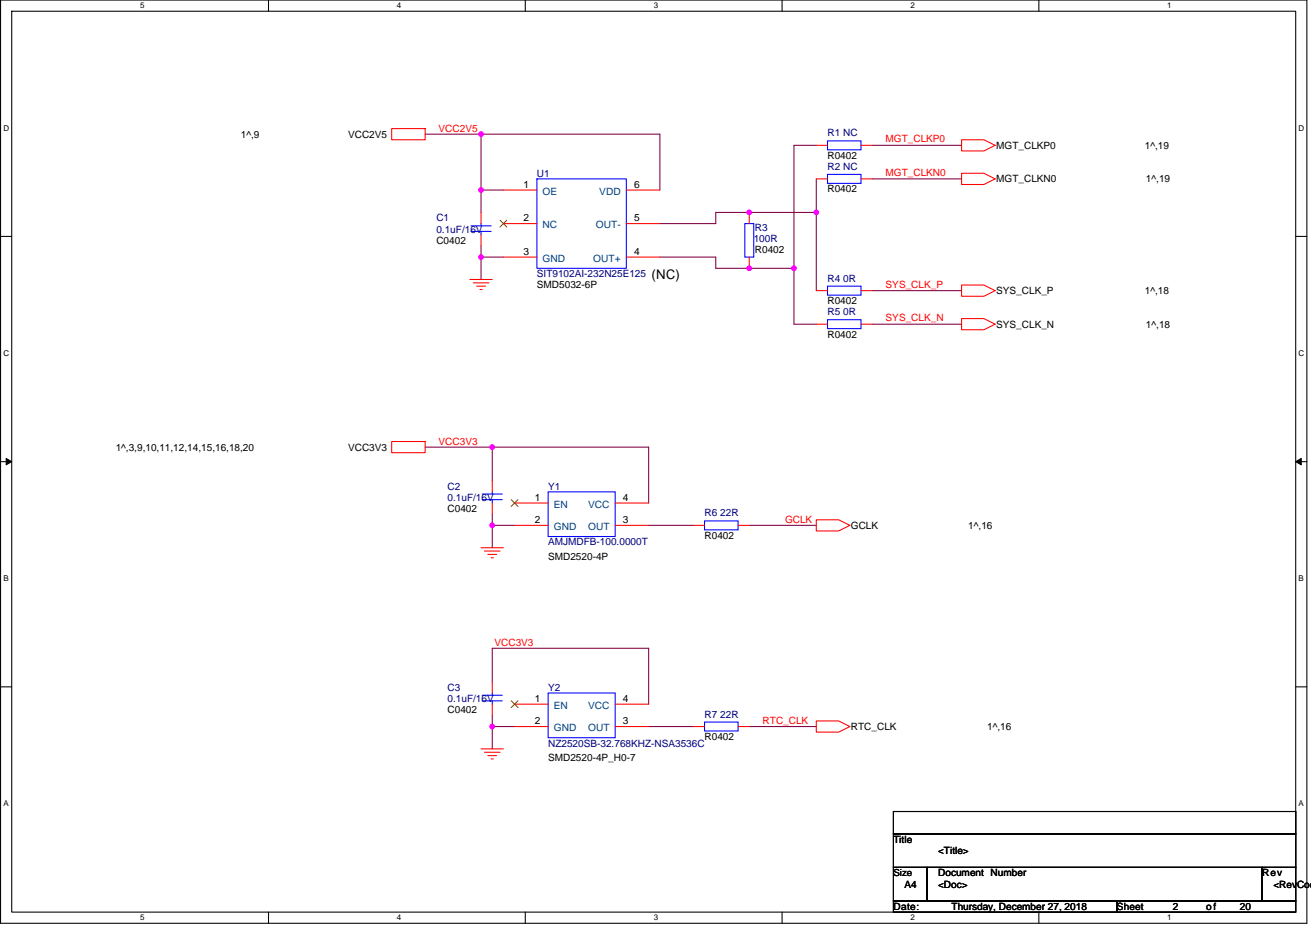
[picture p225: page 2]

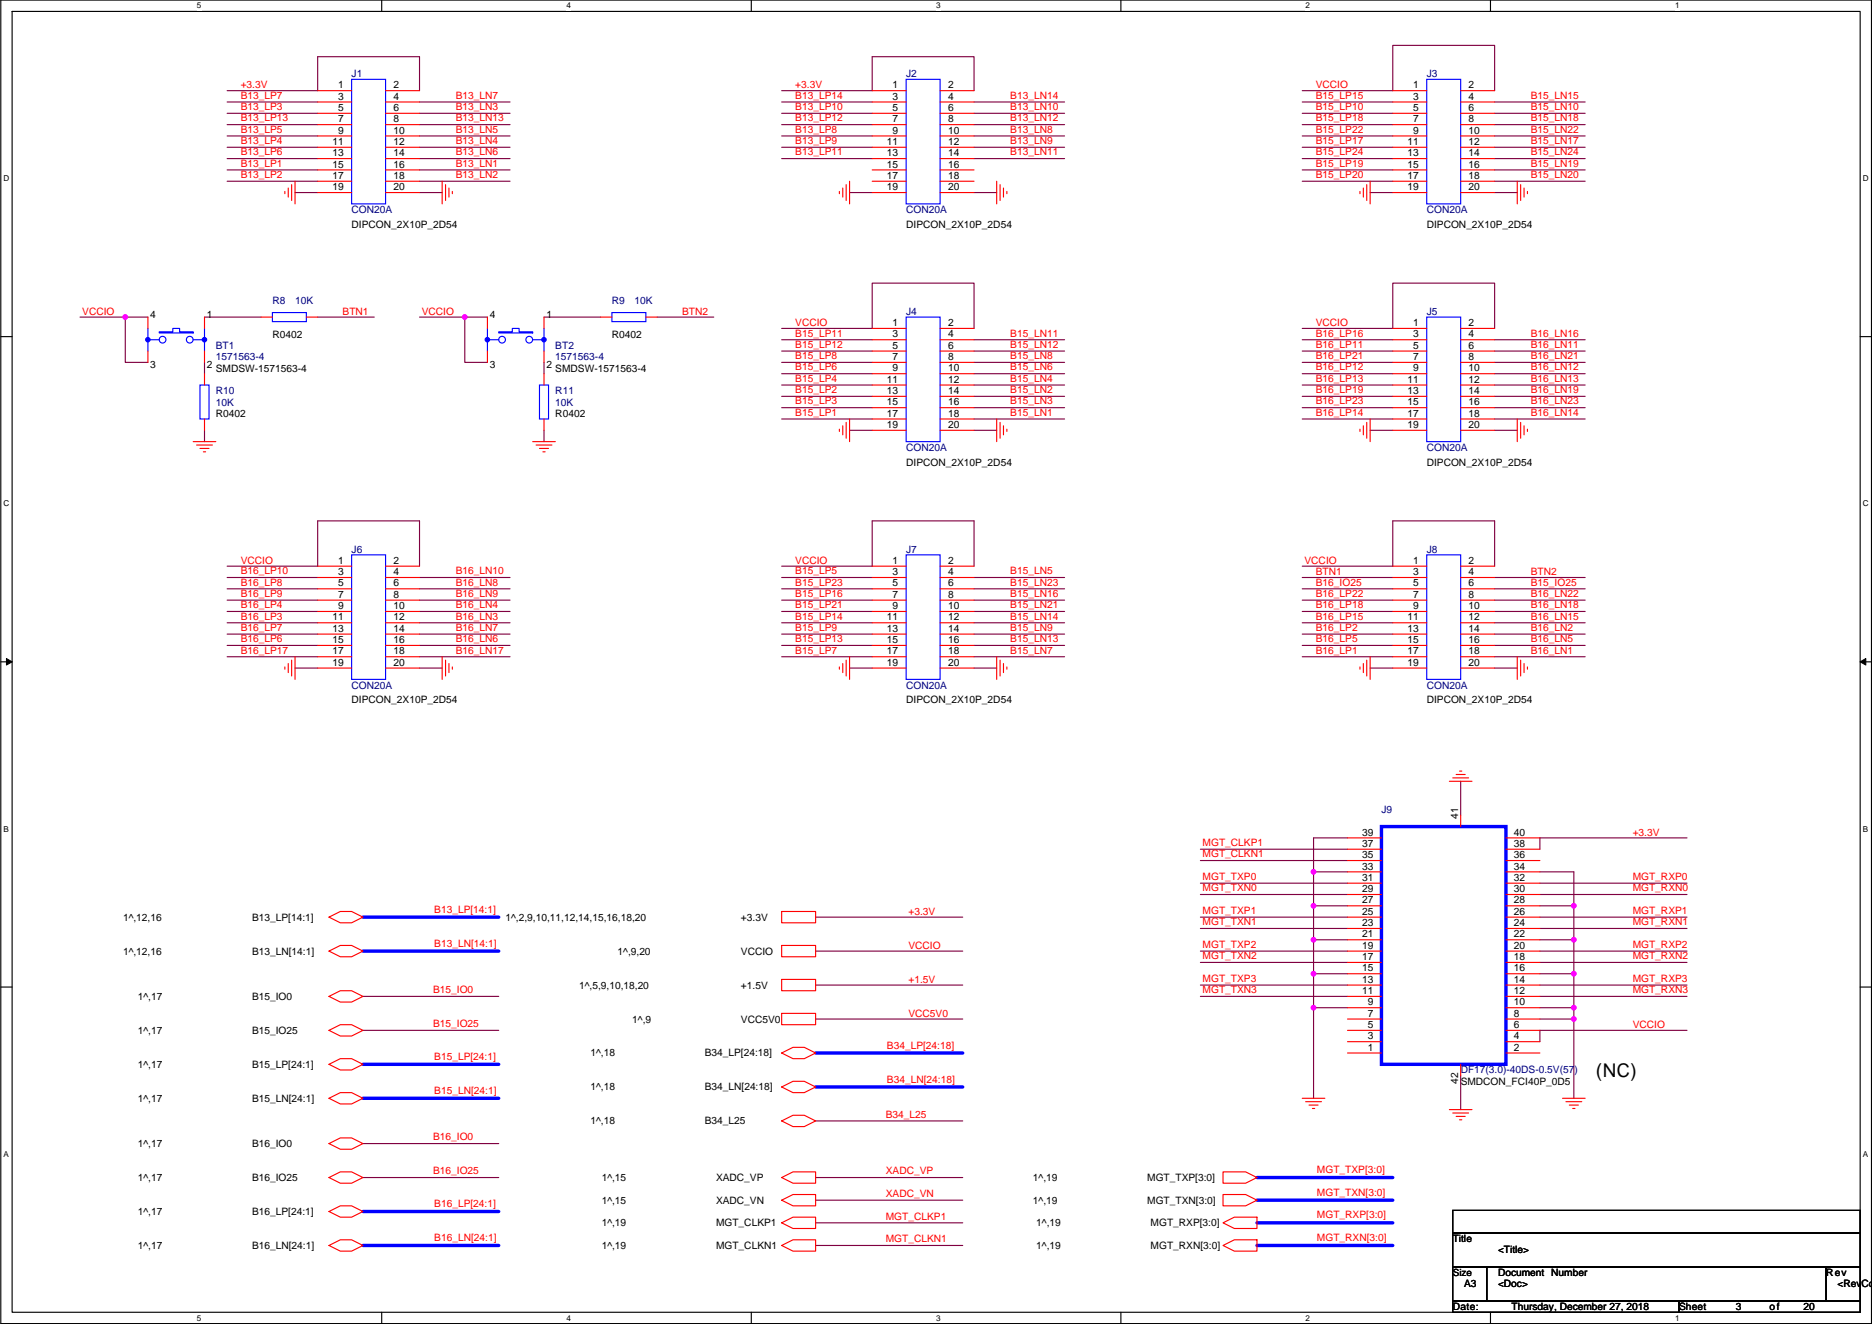
[picture p226: page 3]

<Doc> <Doc> <Doc> | <RevCo <RevCo <RevCo

Thursday, December 27, 2018 Thursday, December 27, 2018 Thursday, December 27, 2018 | 3 3 3 20 20 20

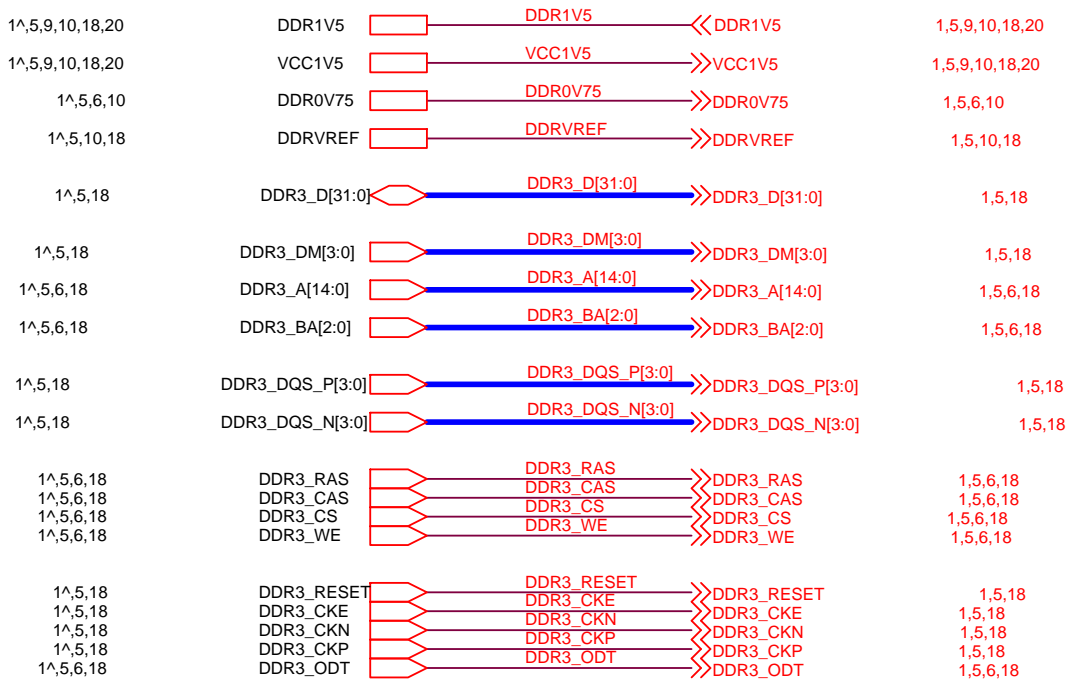
[picture p227: page 4]
DDR1V5; VCC1V5; DDR0V75; DDRVREF; DDR3_D[31:0]; DDR3_DM[3:0]; DDR3_A[14:0]; DDR3_BA[2:0]; DDR3_DQS_P[3:0]; DDR3_DQS_N[3:0]; DDR3_RAS DDR3_CAS DDR3_CS DDR3_WE; DDR3_RESET DDR3_CKE DDR3_CKN DDR3_CKP DDR3_ODT; DDR3_RAS; DDR3_CAS; DDR3_CS; DDR3_WE; DDR3_RESET; DDR3_CKE; DDR3_CKN; DDR3_CKP; DDR3_ODT; Title; <Doc>; <RevCode>; <Title>

Thursday, December 27, 2018 Thursday, December 27, 2018 Thursday, December 27, 2018 | 4 4 4 20 20 20

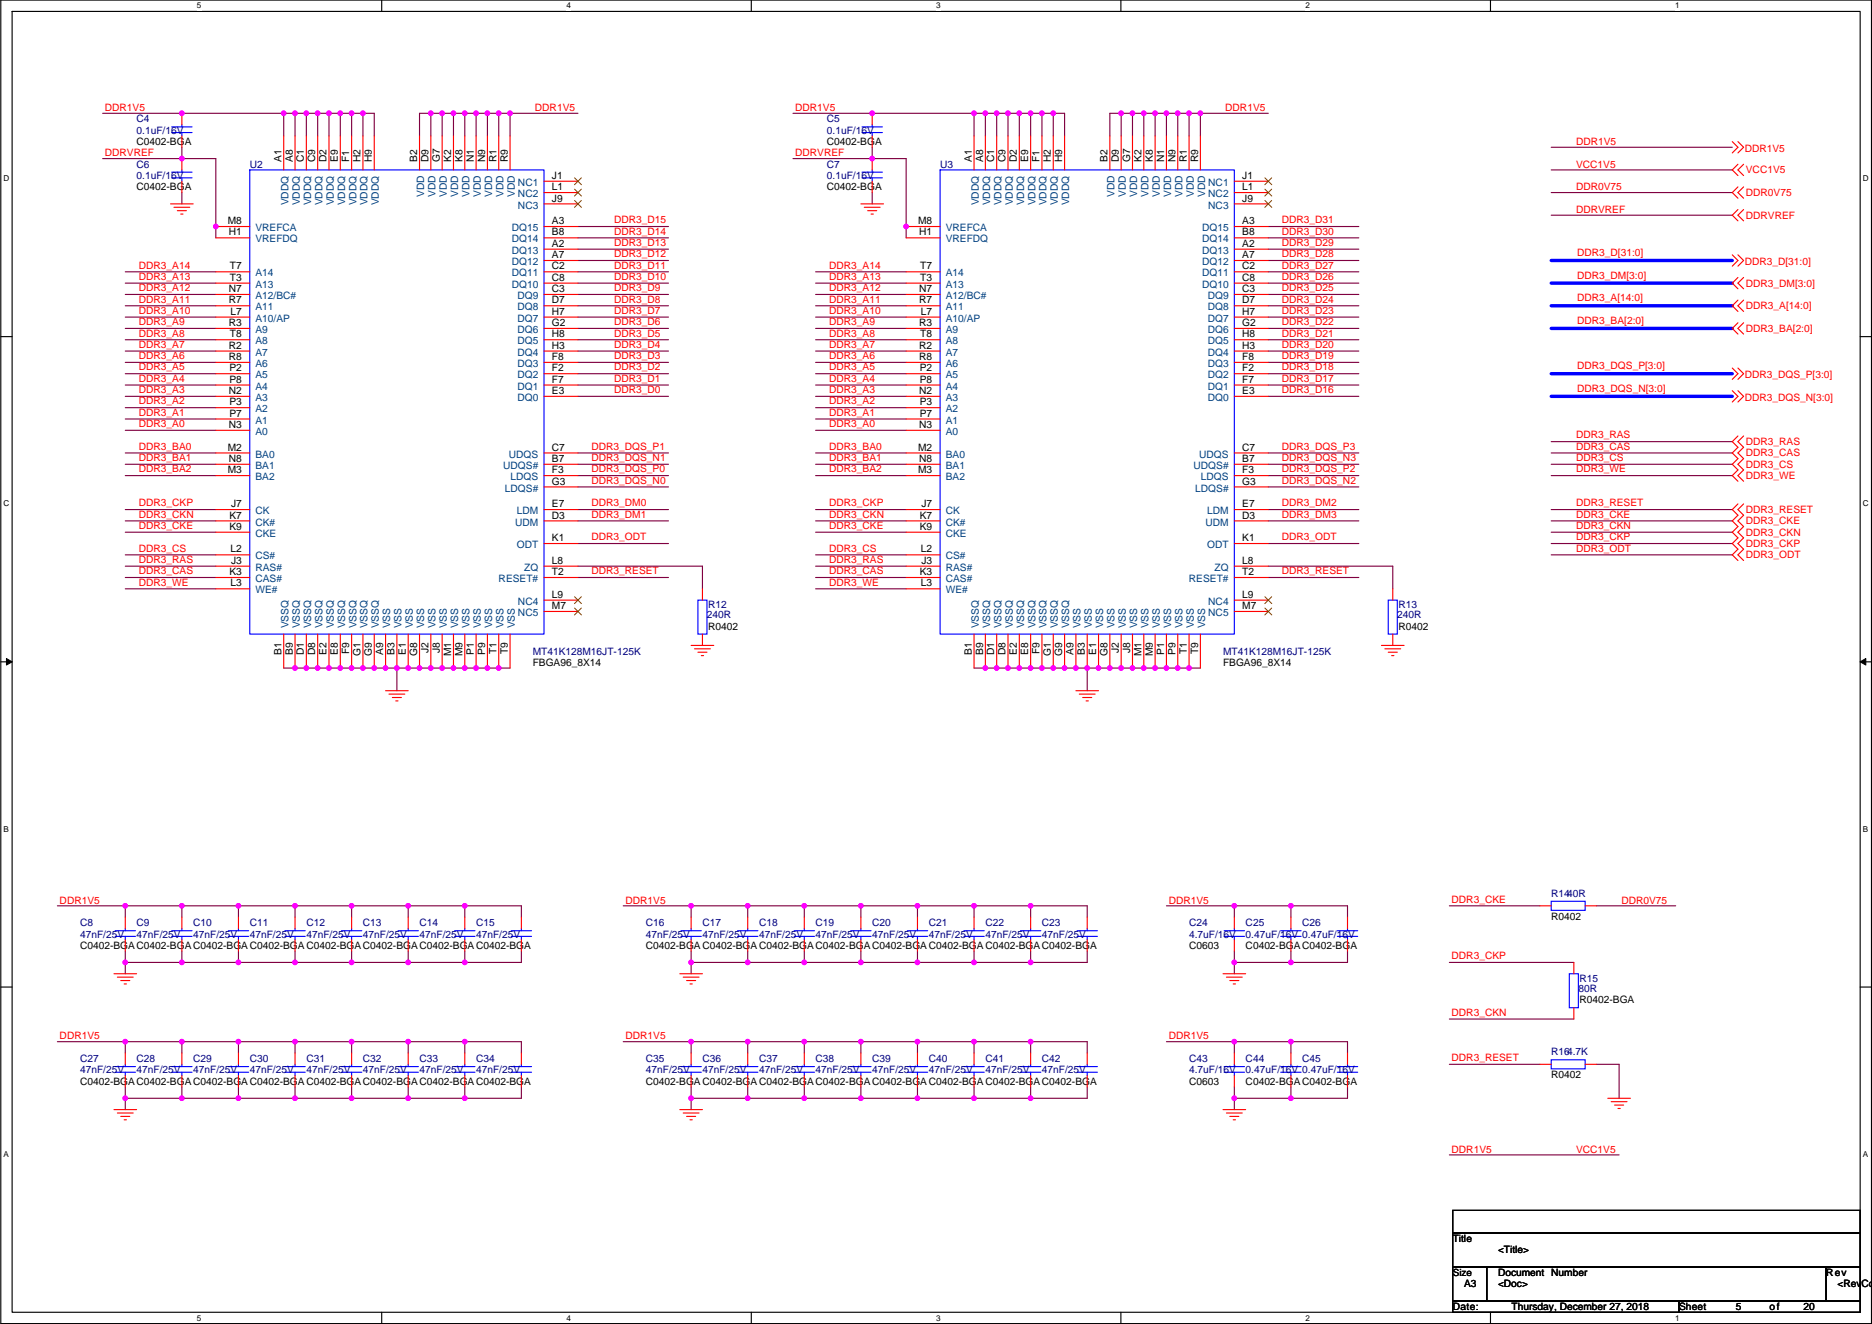
[picture p228: page 5]

<Doc> <Doc> <Doc> | <RevCo <RevCo <RevCo

Thursday, December 27, 2018 Thursday, December 27, 2018 Thursday, December 27, 2018 | 5 5 5 20 20 20

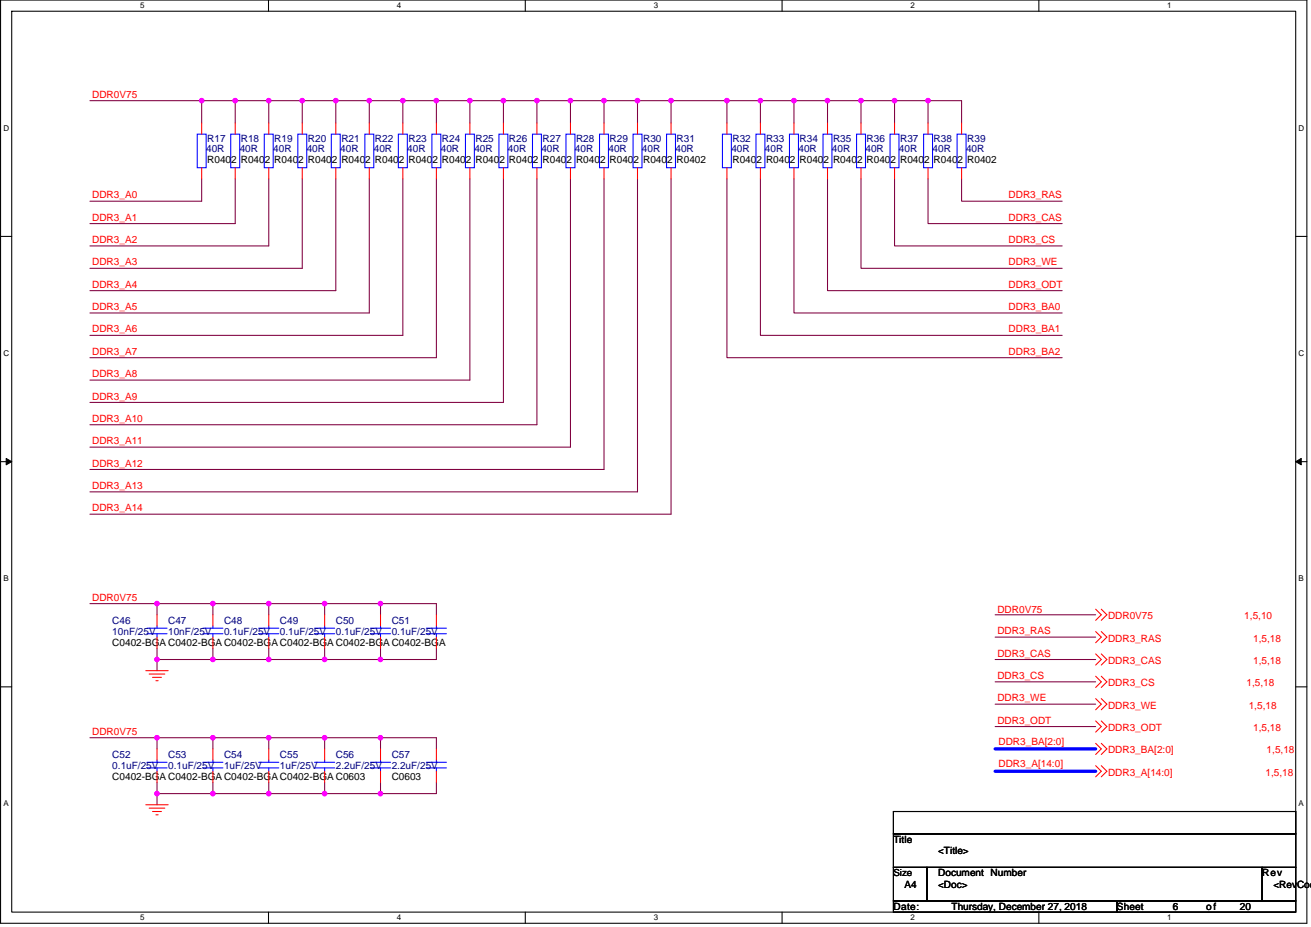
[picture p229: page 6]

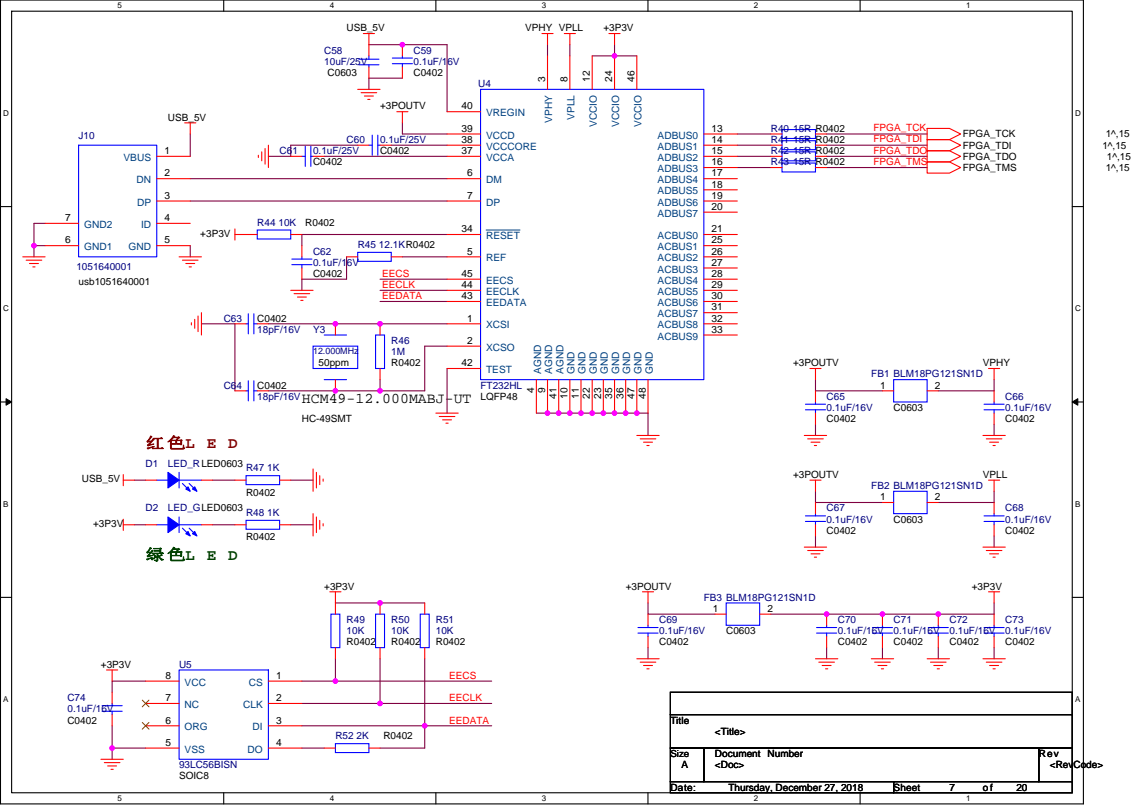
[picture p230: page 7]

Thursday, December 27, 2018 Thursday, December 27, 2018 Thursday, December 27, 2018 | 7 7 7 20 20 20

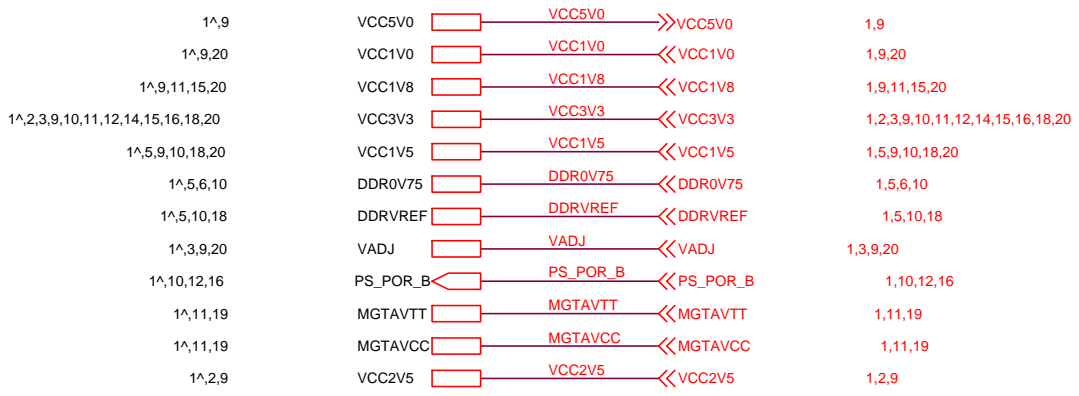
[picture p231: page 8]
VCC5V0; VCC1V0; VCC1V8; VCC3V3; VCC1V5; DDR0V75; DDRVREF; VADJ; PS_POR_B; MGTAVTT; MGTAVCC; VCC2V5; Title; <Doc>; <RevCode>; <Title>

Thursday, December 27, 2018 Thursday, December 27, 2018 Thursday, December 27, 2018 | 8 8 8 20 20 20

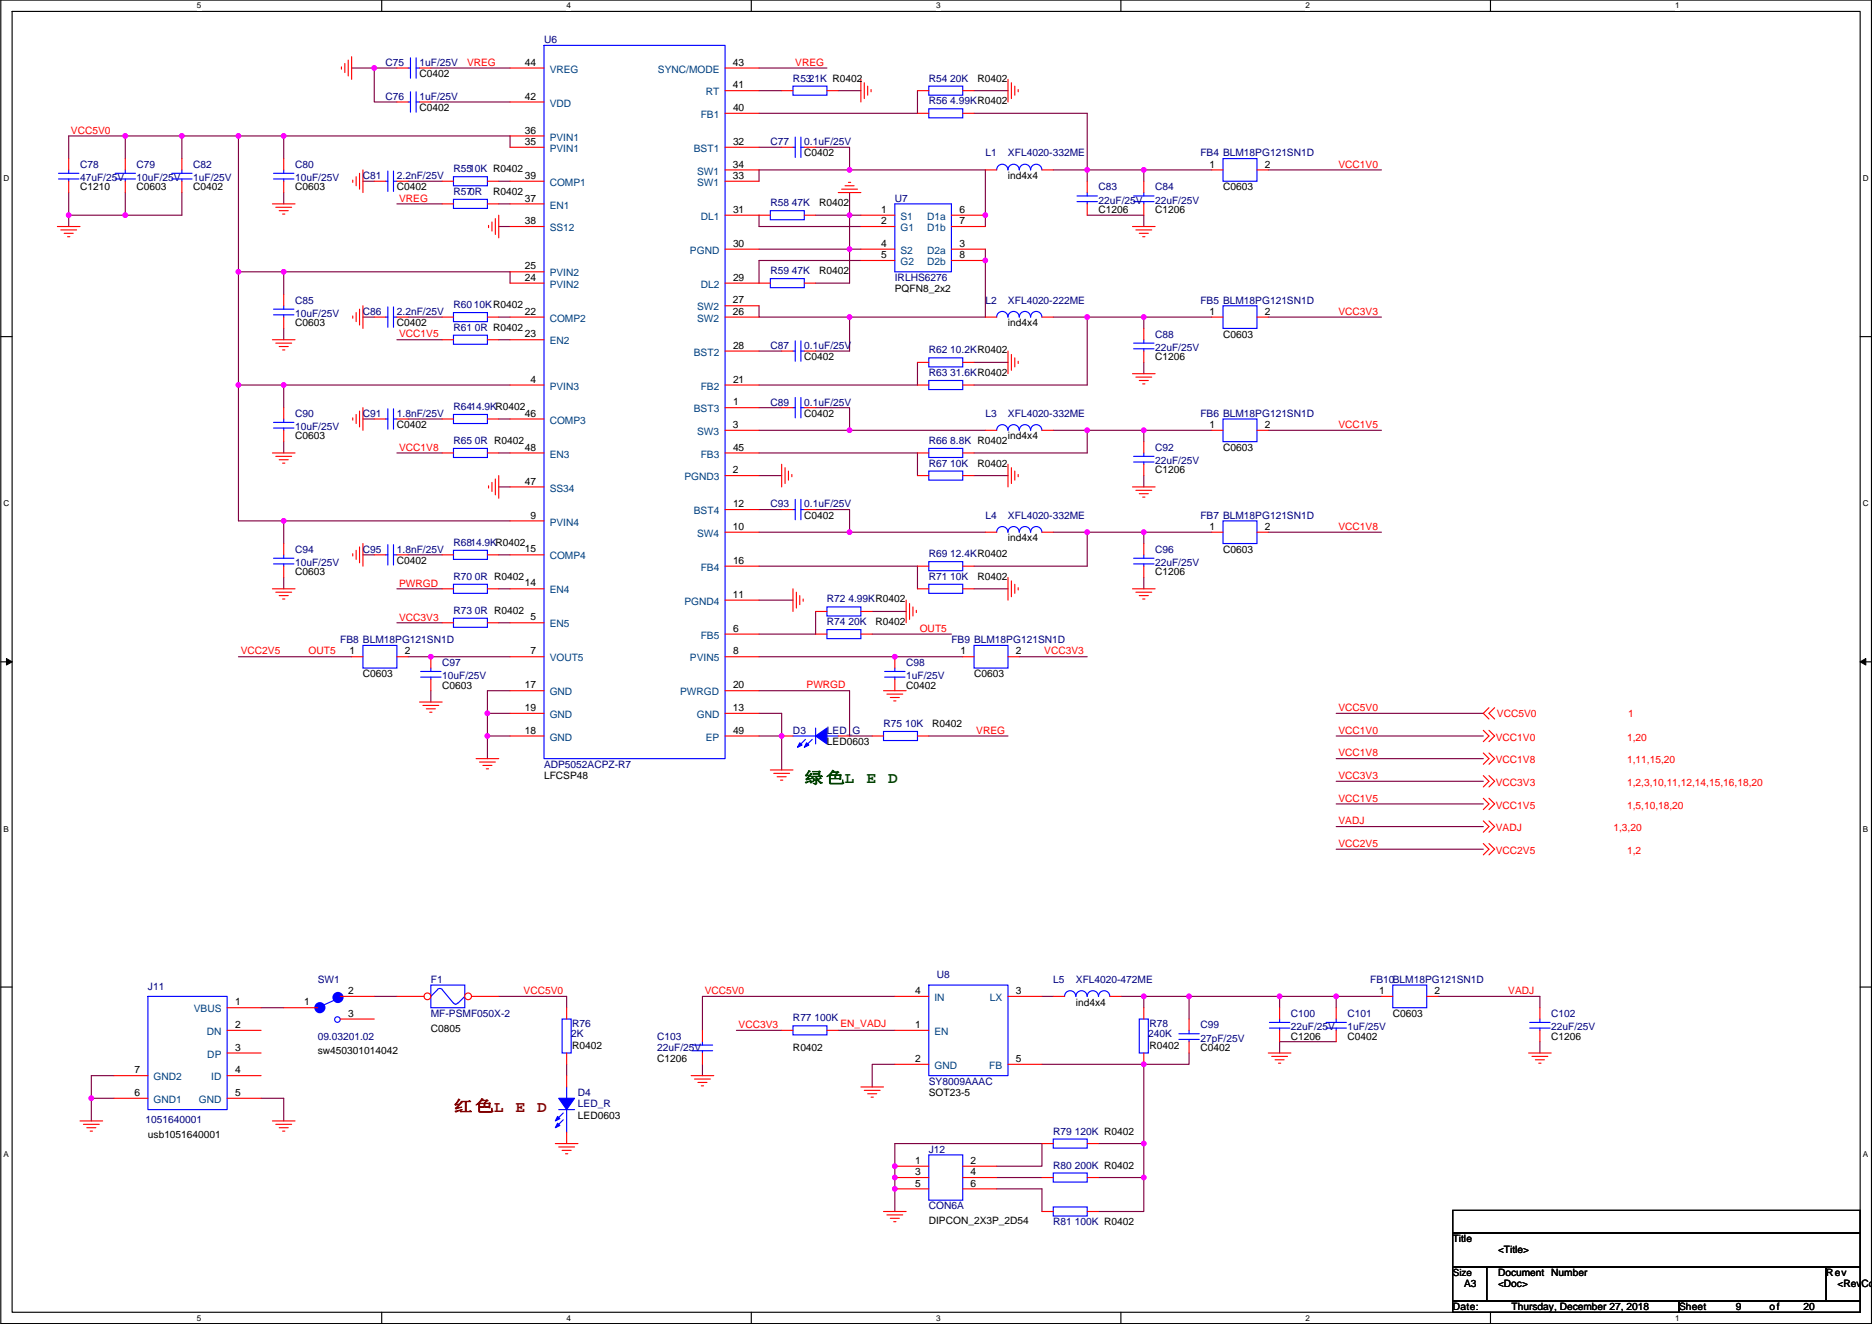
[picture p232: page 9]

<Doc> <Doc> <Doc> | <RevCo <RevCo <RevCo

Thursday, December 27, 2018 Thursday, December 27, 2018 Thursday, December 27, 2018 | 9 9 9 20 20 20

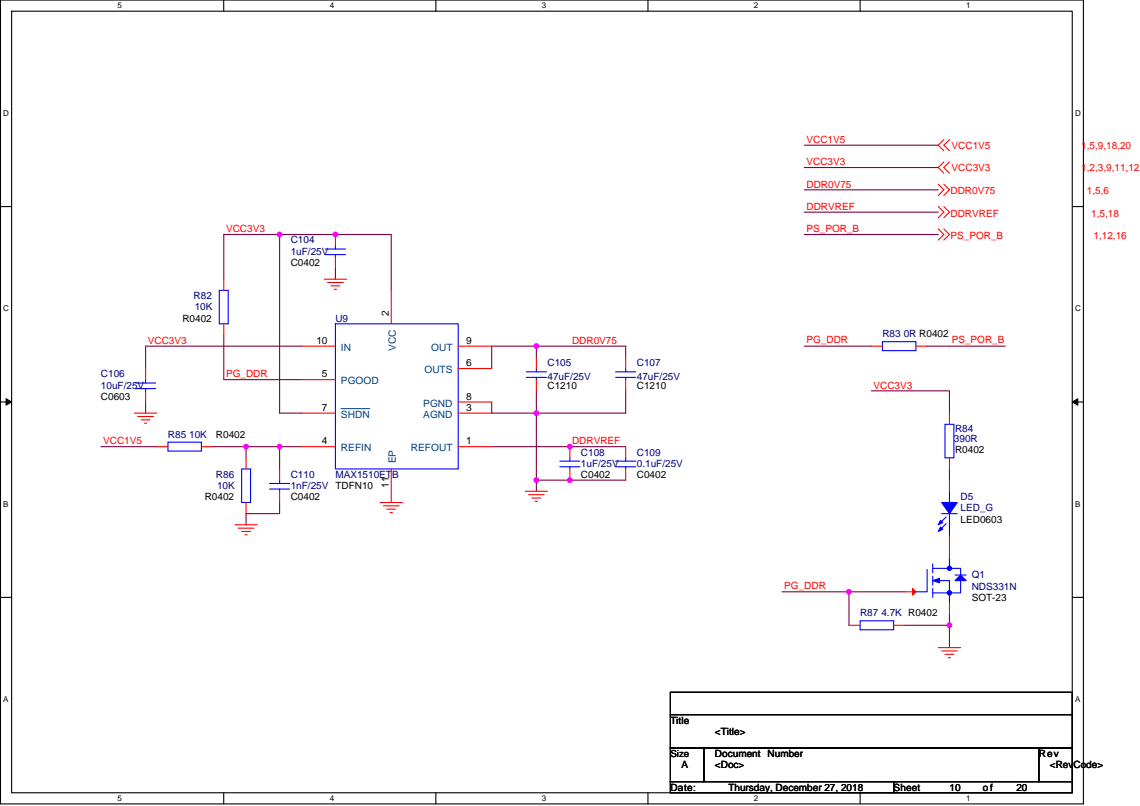
[picture p233: page 10]

Thursday, December 27, 2018 Thursday, December 27, 2018 Thursday, December 27, 2018 | 10 10 10 20 20 20

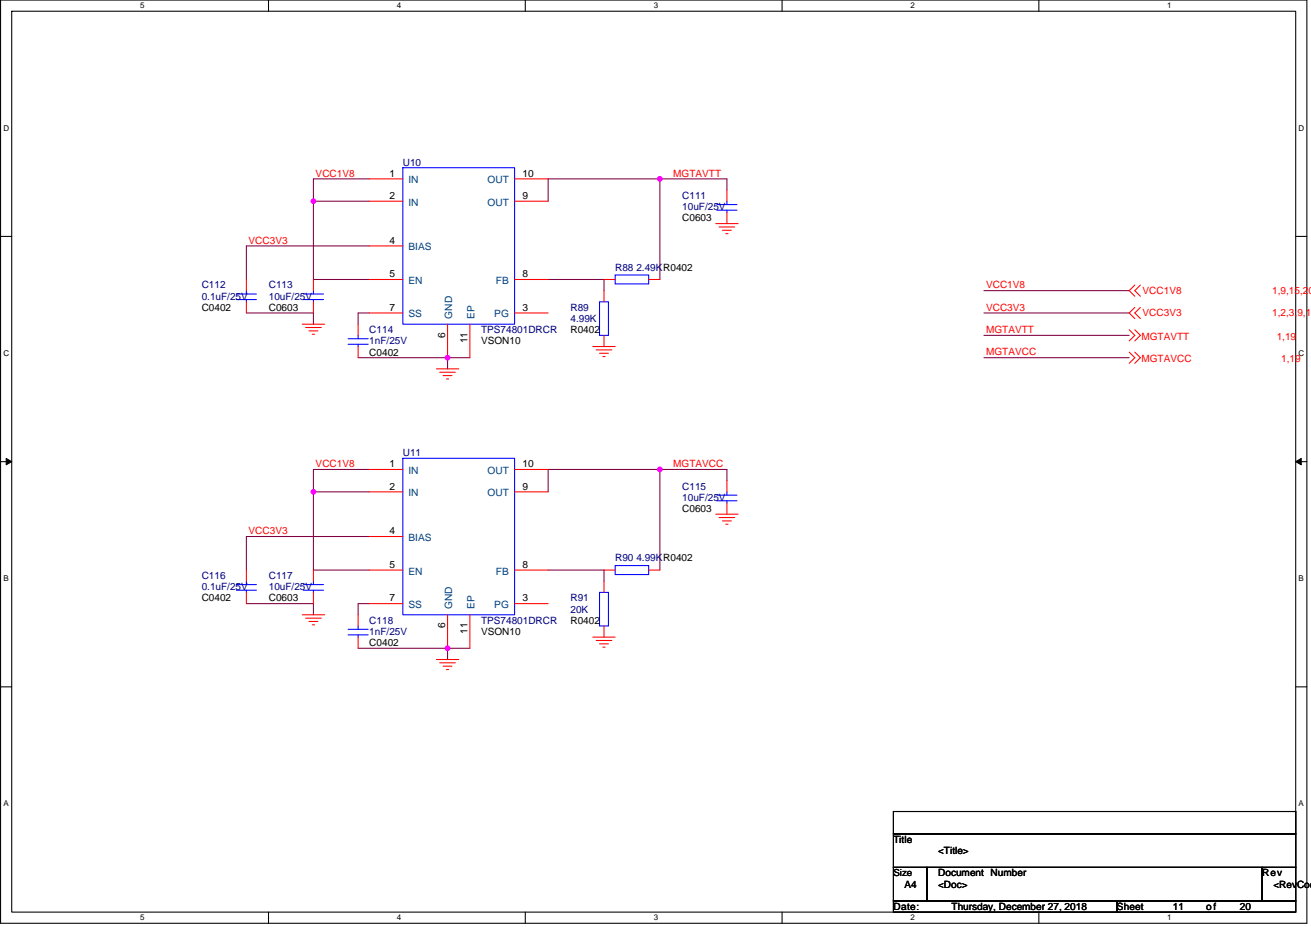
[picture p234: page 11]

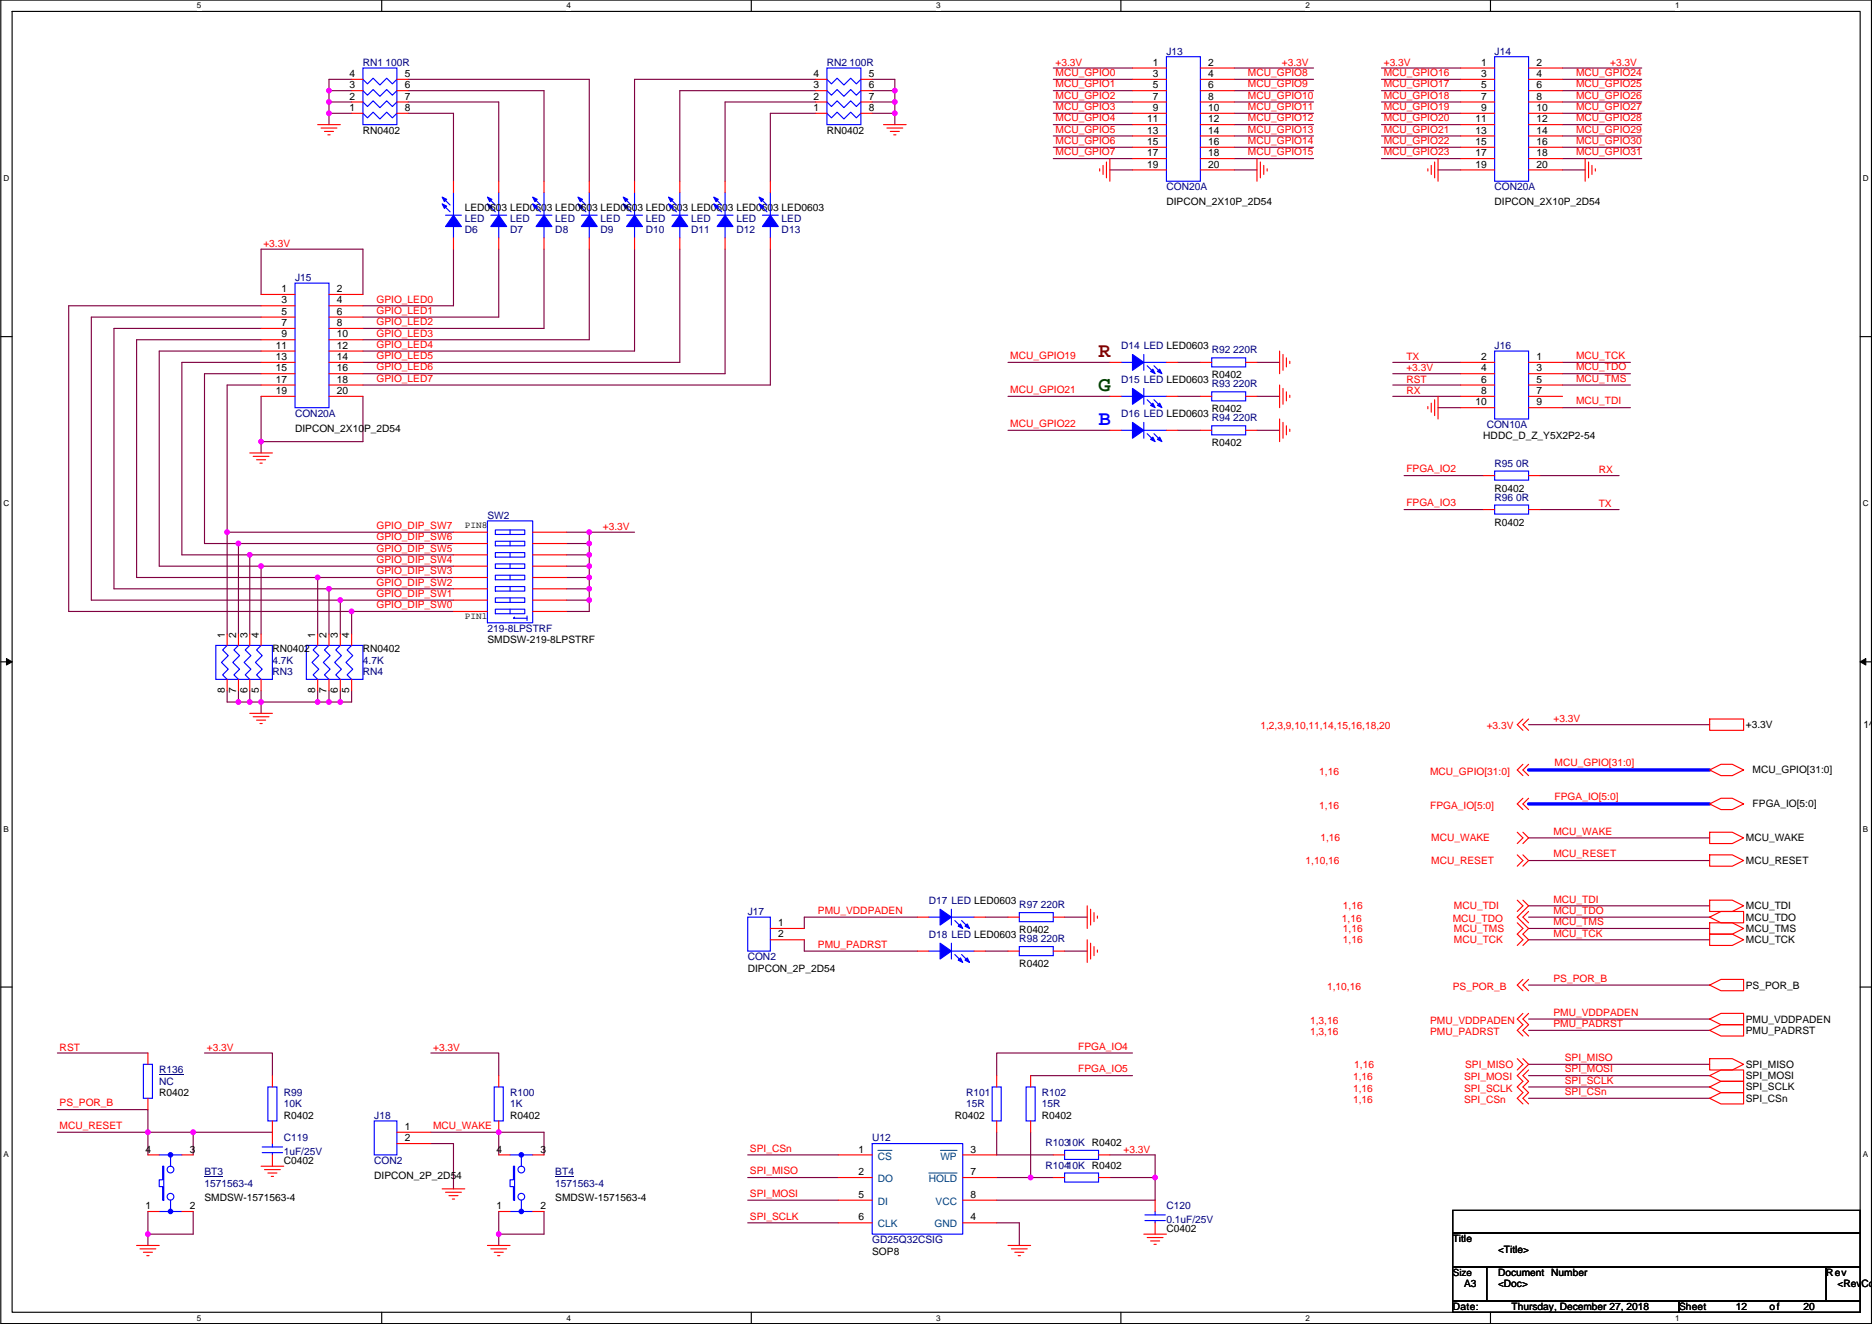
[picture p235: page 12]

5 | 6 GPIO_LED1
7 | 8 GPIO_LED2
9 | GPIO_LED3 10
11 | 12 GPIO_LED4
13 | 14 GPIO_LED5
15 | 16 GPIO_LED6
17 | 18 GPIO_LED7
19 | 20

GPIO_DIP_SW5
GPIO_DIP_SW4
GPIO_DIP_SW3
GPIO_DIP_SW2
GPIO_DIP_SW1
GPIO_DIP_SW0

<Doc> <Doc> <Doc> | <RevCo <RevCo <RevCo

Thursday, December 27, 2018 Thursday, December 27, 2018 Thursday, December 27, 2018 | 12 12 12 20 20 20

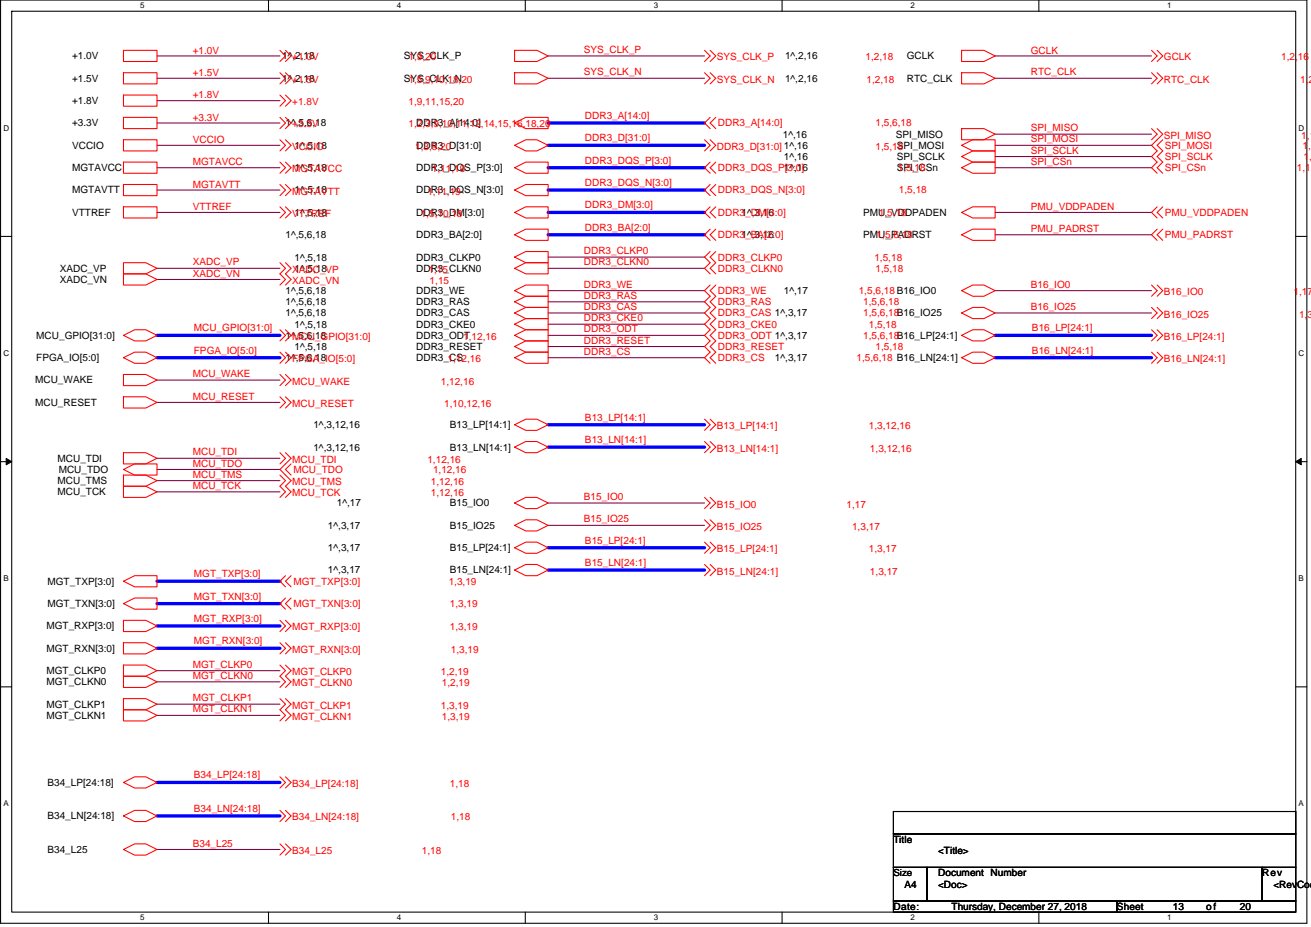
[picture p236: page 13]
VCCIO; MGTAVCC; MGTAVTT; VTTREF; XADC_VP XADC_VN; MCU_WAKE; MCU_RESET; MCU_GPIO[31:0]; FPGA_IO[5:0]; MCU_TDI MCU_TDO MCU_TMS MCU_TCK; MGT_TXP[3:0]; MGT_TXN[3:0]; MGT_RXP[3:0]; MGT_RXN[3:0]; MGT_CLKP0 MGT_CLKN0; MGT_CLKP1 MGT_CLKN1; SYS_CLK_P; SYS_CLK_N; DDR3_A[14:0]; DDR3_D[31:0]; DDR3_DQS_P[3:0]; DDR3_DQS_N[3:0]; DDR3_DM[3:0]; DDR3_BA[2:0]; DDR3_CLKP0 DDR3_CLKN0; DDR3_WE DDR3_RAS DDR3_CAS DDR3_CKE0 DDR3_ODT DDR3_RESET DDR3_CS; GCLK; RTC_CLK; SPI_MISO SPI_MOSI SPI_SCLK SPI_CSn; PMU_VDDPADEN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

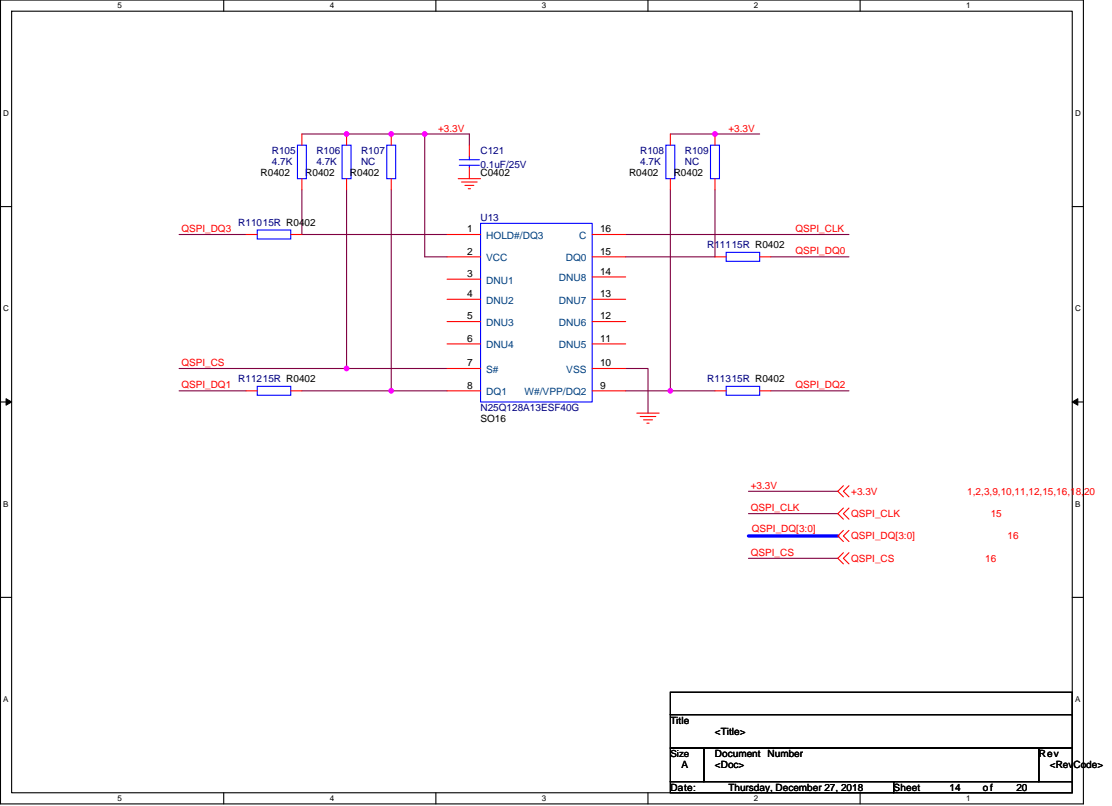
[picture p237: page 14]

Thursday, December 27, 2018 Thursday, December 27, 2018 Thursday, December 27, 2018 | 14 14 14 20 20 20

# BANK0

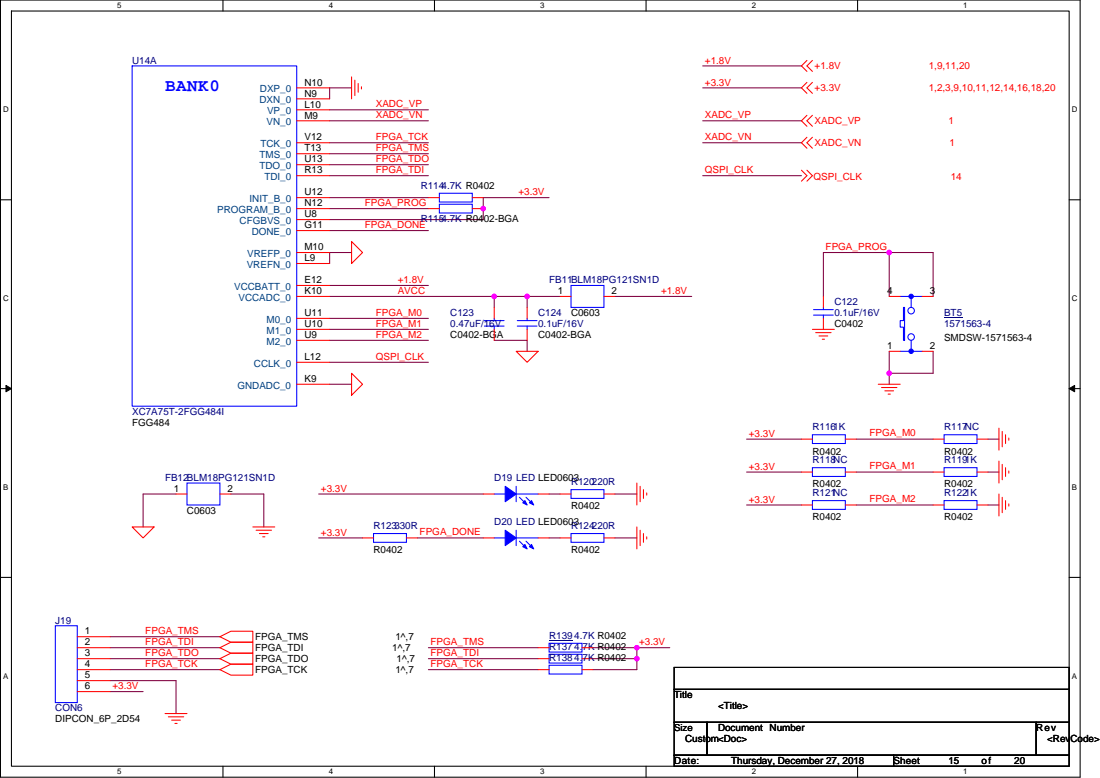
[picture p238: page 15]

Custom Custom Custom

Thursday, December 27, 2018 Thursday, December 27, 2018 Thursday, December 27, 2018 | 15 15 15 20 20 20

# BANK13

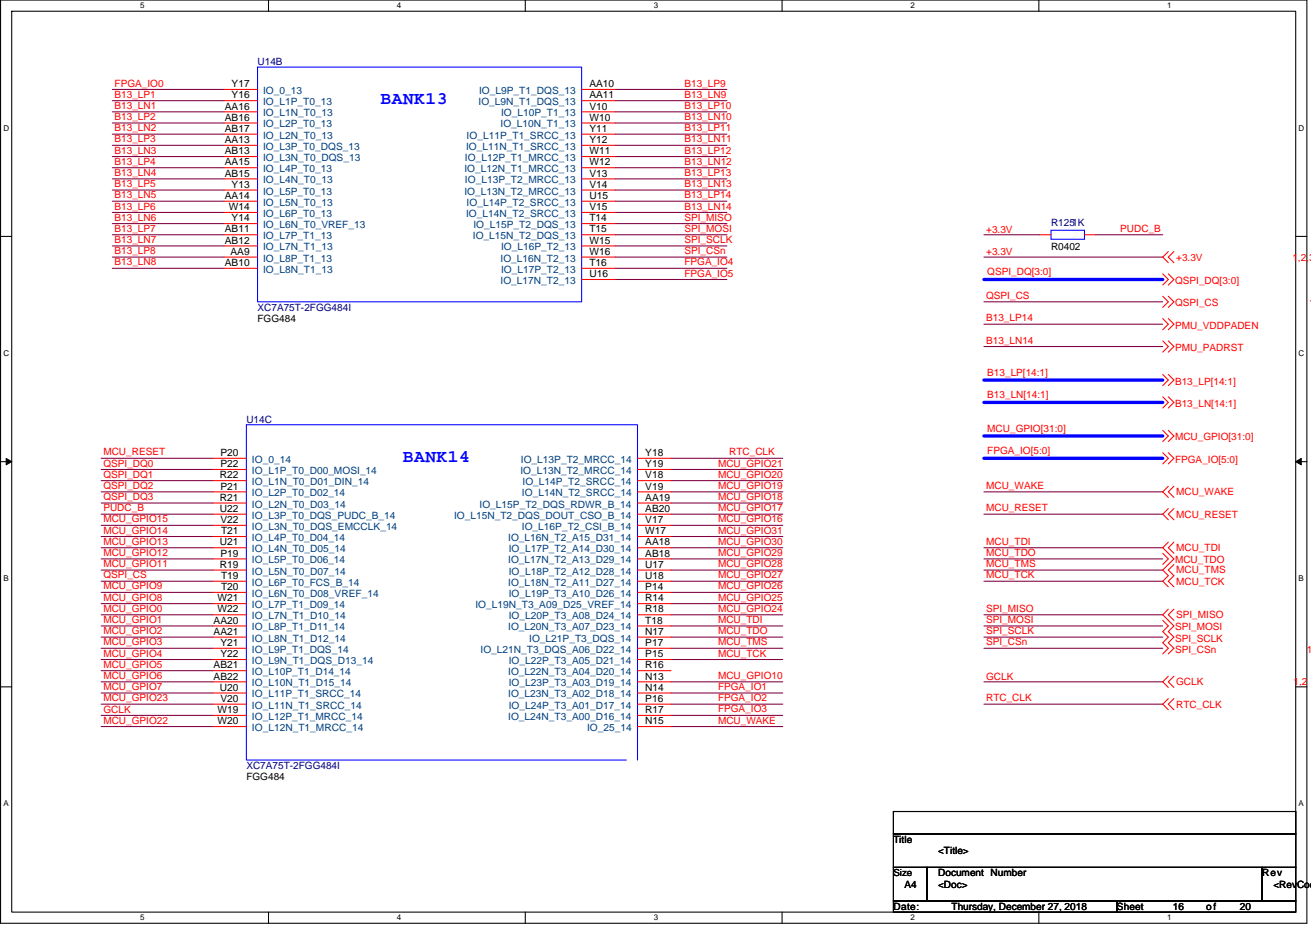
[picture p239: page 16]

# BANK15

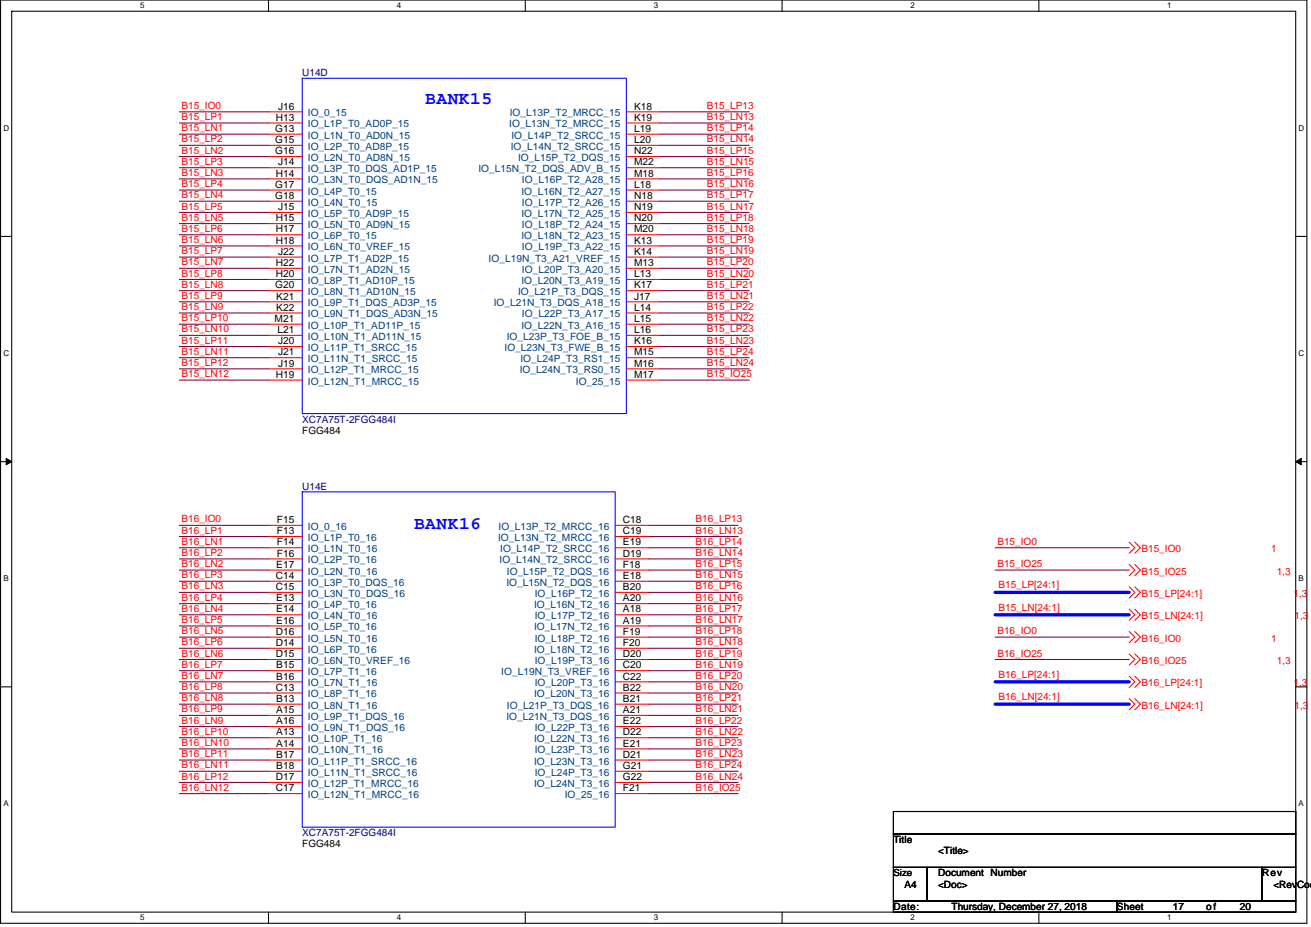
[picture p240: page 17]

# BANK34

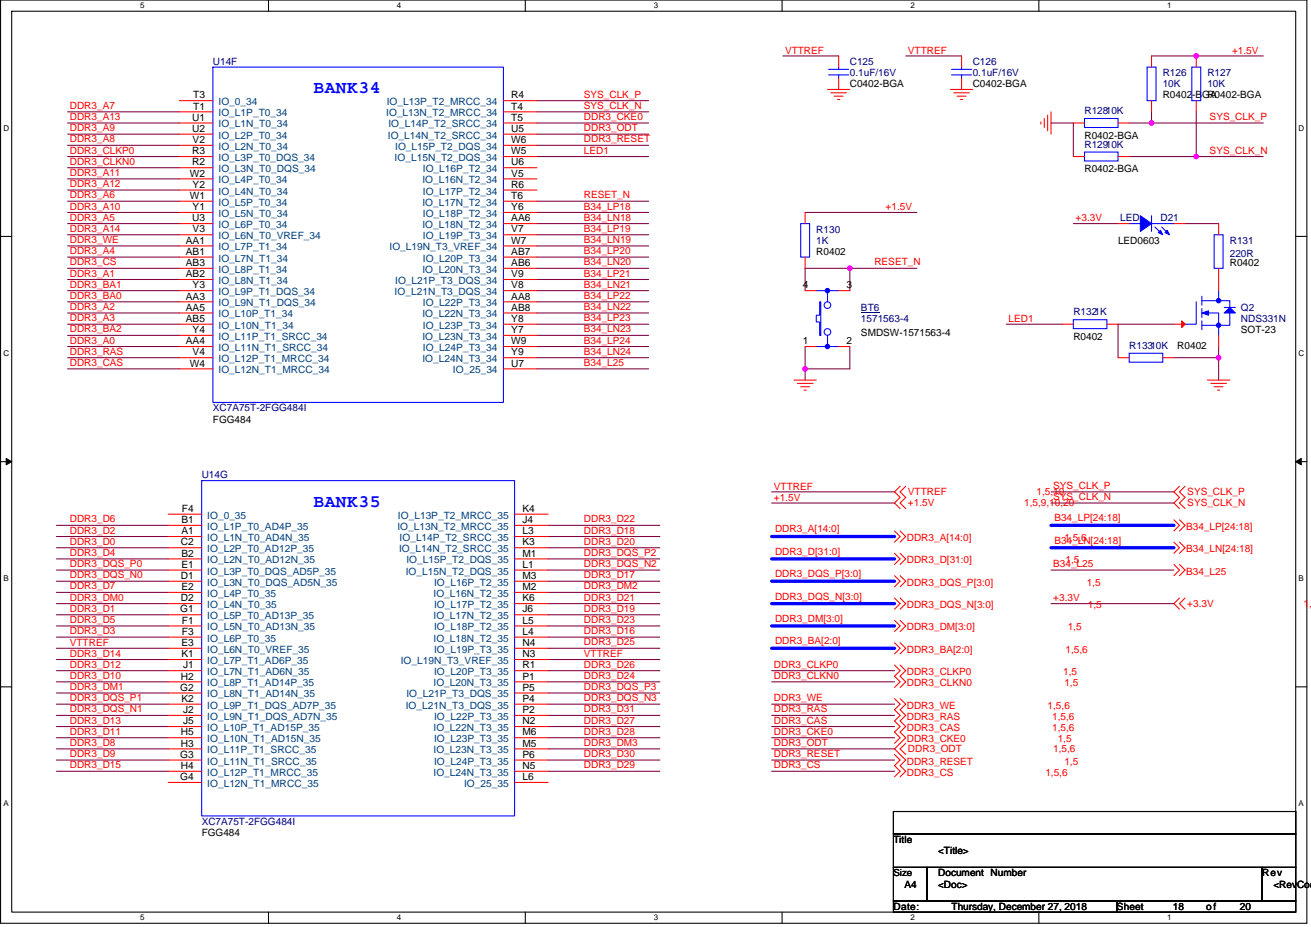
[picture p241: page 18]

# BANK216

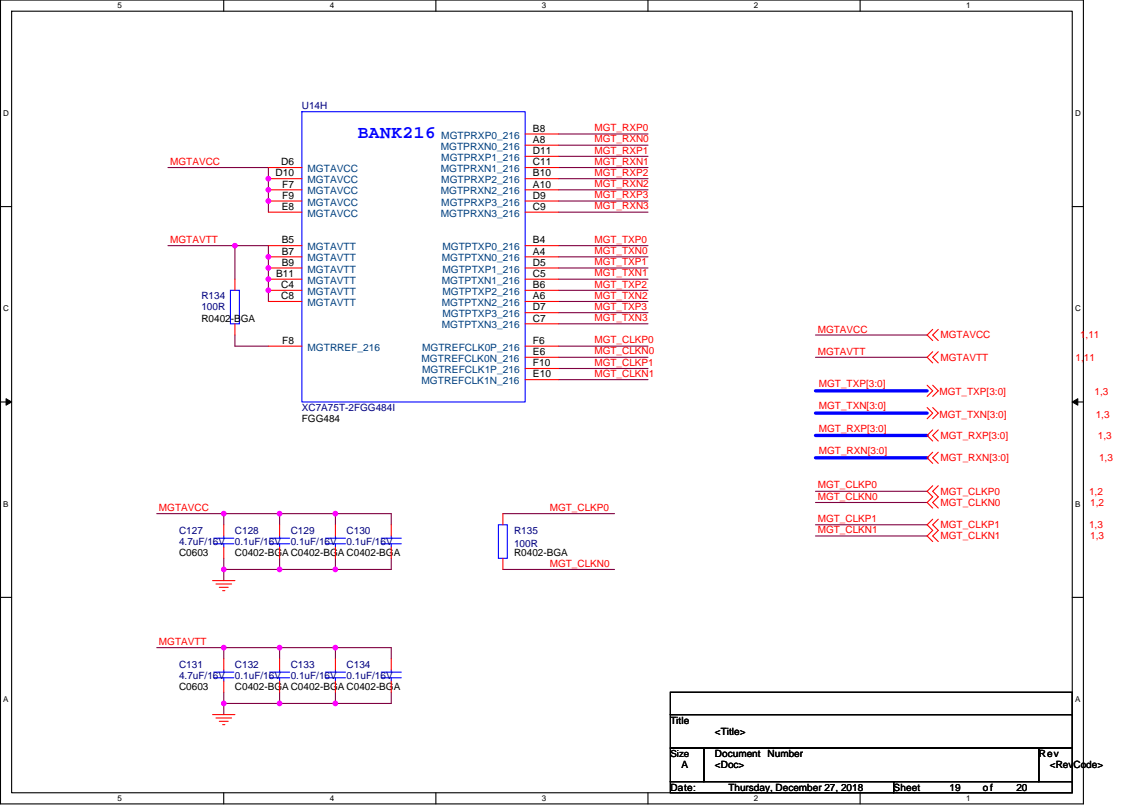
[picture p242: page 19]

MGTAVCC F7 | MGT_RXN2
MGTAVCC F9 | MGT_RXP3
MGTAVCC E8 | MGT_RXN3

MGTAVTT B9 | MGT_TXP1
MGTAVTT B11 | MGT_TXN1
MGTAVTT C4 | MGT_TXP2
MGTAVTT C8 | MGT_TXN2

Thursday, December 27, 2018 Thursday, December 27, 2018 Thursday, December 27, 2018 | 19 19 19 20 20 20

## POWER GND

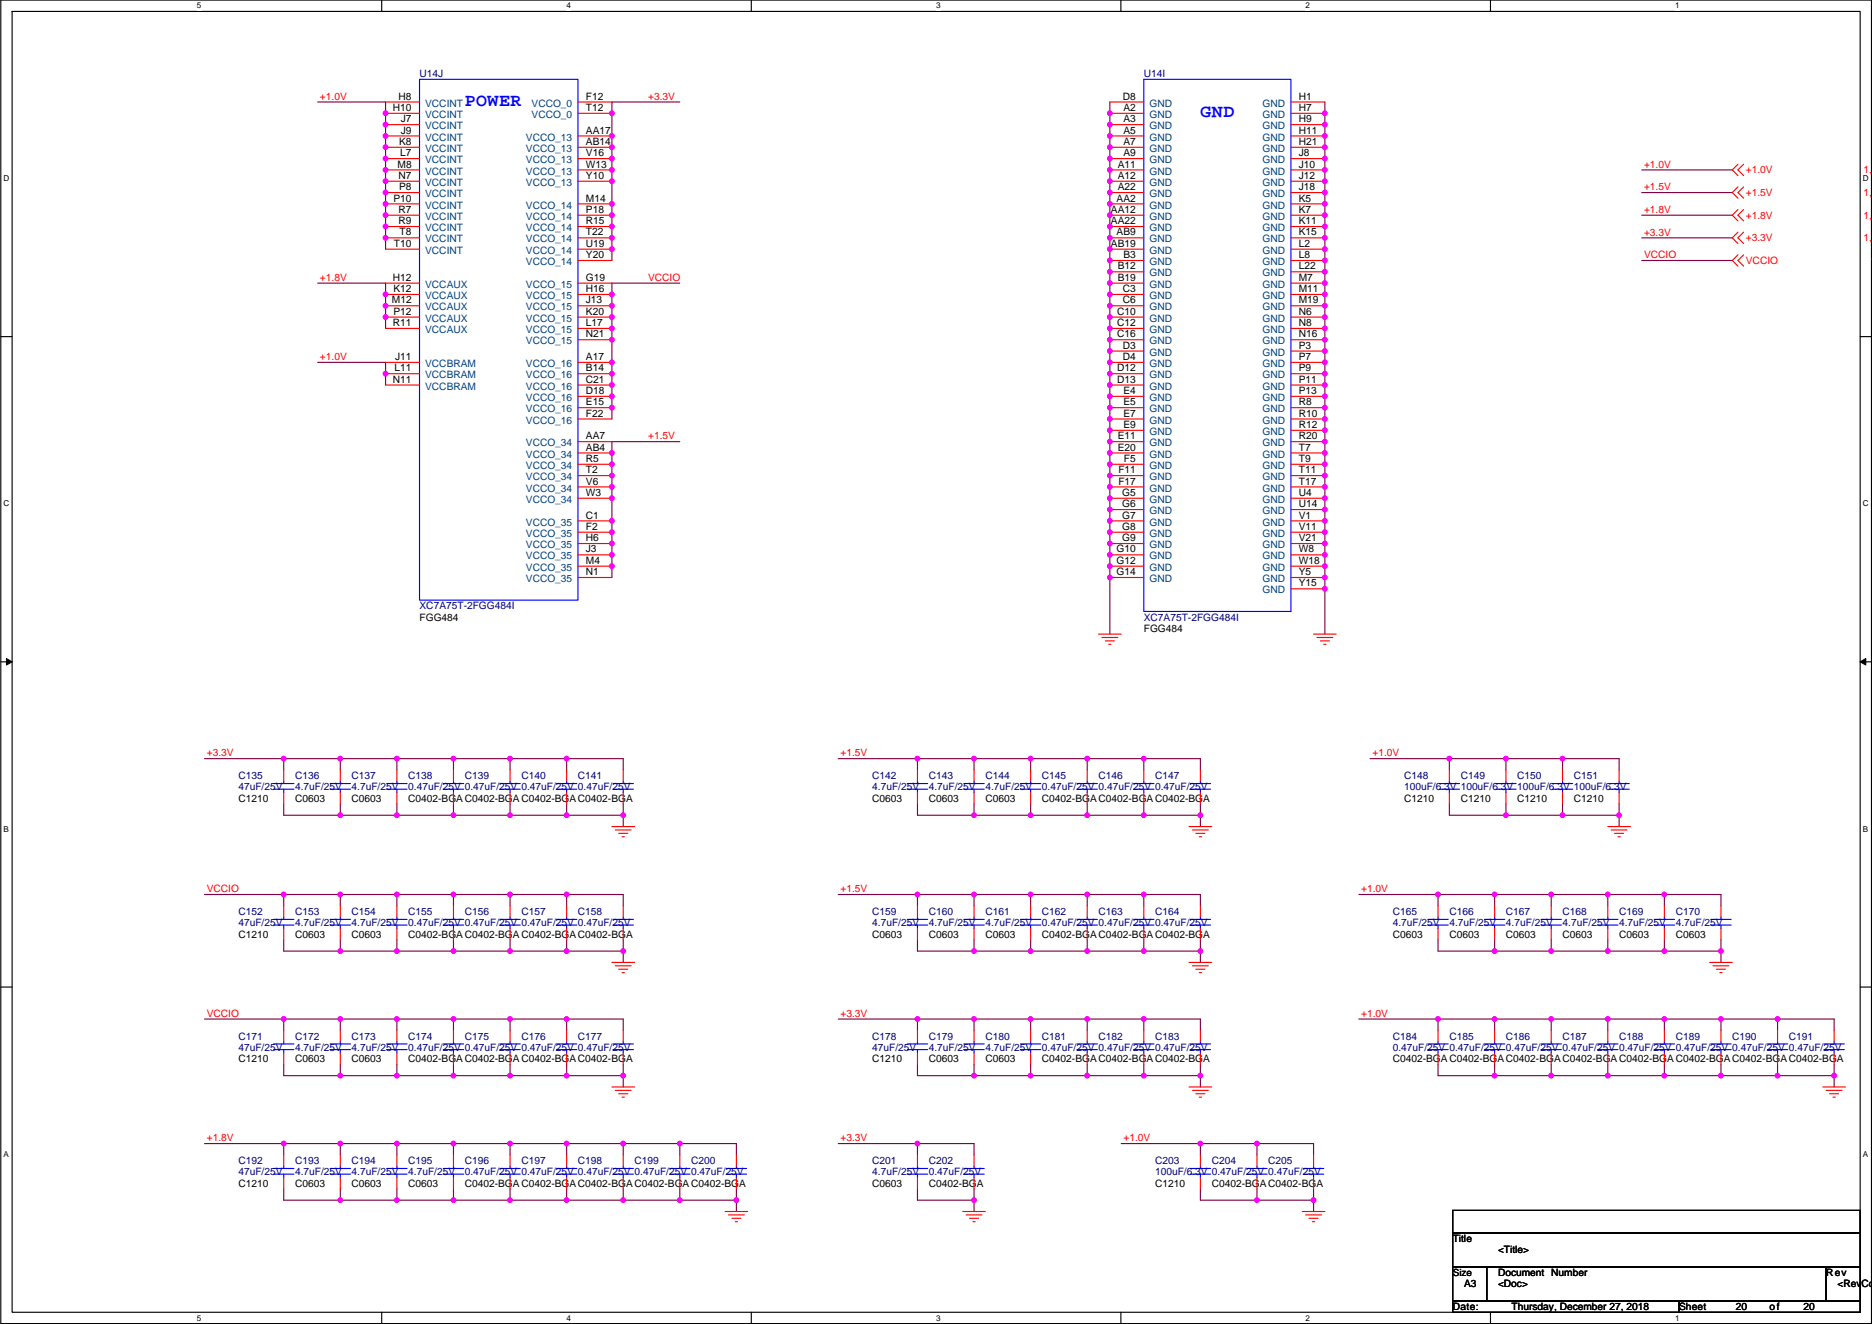
[picture p243: page 20]

<Doc> <Doc> <Doc> | <RevCo <RevCo <RevCo

Thursday, December 27, 2018 Thursday, December 27, 2018 Thursday, December 27, 2018 | 20 20 20
