xiaoerlang0359/E203plus/E203Plus/constraint（约束文件）/arty-master.xdc

## This file is a general .xdc for the ARTY Rev. B
## To use it in a project:
## - uncomment the lines corresponding to used pins
## - rename the used ports (in each line, after get_ports) according to the top level signal names in the project

## Clock signal

set_property -dict {PACKAGE_PIN E3 IOSTANDARD LVCMOS33} [get_ports CLK100MHZ]

##Switches

set_property -dict {PACKAGE_PIN A8 IOSTANDARD LVCMOS33} [get_ports sw_0]
set_property -dict {PACKAGE_PIN C11 IOSTANDARD LVCMOS33} [get_ports sw_1]
set_property -dict {PACKAGE_PIN C10 IOSTANDARD LVCMOS33} [get_ports sw_2]
set_property -dict {PACKAGE_PIN A10 IOSTANDARD LVCMOS33} [get_ports sw_3]

##RGB LEDs

set_property -dict {PACKAGE_PIN E1 IOSTANDARD LVCMOS33} [get_ports led0_b]
set_property -dict {PACKAGE_PIN F6 IOSTANDARD LVCMOS33} [get_ports led0_g]
set_property -dict {PACKAGE_PIN G6 IOSTANDARD LVCMOS33} [get_ports led0_r]
set_property -dict {PACKAGE_PIN G4 IOSTANDARD LVCMOS33} [get_ports led1_b]
set_property -dict {PACKAGE_PIN J4 IOSTANDARD LVCMOS33} [get_ports led1_g]
set_property -dict {PACKAGE_PIN G3 IOSTANDARD LVCMOS33} [get_ports led1_r]
set_property -dict {PACKAGE_PIN H4 IOSTANDARD LVCMOS33} [get_ports led2_b]
set_property -dict {PACKAGE_PIN J2 IOSTANDARD LVCMOS33} [get_ports led2_g]
set_property -dict {PACKAGE_PIN J3 IOSTANDARD LVCMOS33} [get_ports led2_r]
#set_property -dict { PACKAGE_PIN K2    IOSTANDARD LVCMOS33 } [get_ports { led3_b }]; #IO_L23P_T3_35 Sch=led3_b
#set_property -dict { PACKAGE_PIN H6    IOSTANDARD LVCMOS33 } [get_ports { led3_g }]; #IO_L24P_T3_35 Sch=led3_g
#set_property -dict { PACKAGE_PIN K1    IOSTANDARD LVCMOS33 } [get_ports { led3_r }]; #IO_L23N_T3_35 Sch=led3_r

##LEDs

set_property -dict {PACKAGE_PIN H5 IOSTANDARD LVCMOS33} [get_ports led_0]
set_property -dict {PACKAGE_PIN J5 IOSTANDARD LVCMOS33} [get_ports led_1]
set_property -dict {PACKAGE_PIN T9 IOSTANDARD LVCMOS33} [get_ports led_2]
set_property -dict {PACKAGE_PIN T10 IOSTANDARD LVCMOS33} [get_ports led_3]

##Buttons

set_property -dict {PACKAGE_PIN D9 IOSTANDARD LVCMOS33} [get_ports btn_0]
set_property -dict {PACKAGE_PIN C9 IOSTANDARD LVCMOS33} [get_ports btn_1]
set_property -dict {PACKAGE_PIN B9 IOSTANDARD LVCMOS33} [get_ports btn_2]
set_property -dict {PACKAGE_PIN B8 IOSTANDARD LVCMOS33} [get_ports btn_3]

##Pmod Header JA

set_property -dict {PACKAGE_PIN G13 IOSTANDARD LVCMOS33} [get_ports ja_0]
set_property -dict {PACKAGE_PIN B11 IOSTANDARD LVCMOS33} [get_ports ja_1]
#set_property -dict { PACKAGE_PIN A11   IOSTANDARD LVCMOS33 } [get_ports { ja_2 }]; #IO_L4N_T0_15 Sch=ja[3]
#set_property -dict { PACKAGE_PIN D12   IOSTANDARD LVCMOS33 } [get_ports { ja_3 }]; #IO_L6P_T0_15 Sch=ja[4]
#set_property -dict { PACKAGE_PIN D13   IOSTANDARD LVCMOS33 } [get_ports { ja_4 }]; #IO_L6N_T0_VREF_15 Sch=ja[7]
#set_property -dict { PACKAGE_PIN B18   IOSTANDARD LVCMOS33 } [get_ports { ja_5 }]; #IO_L10P_T1_AD11P_15 Sch=ja[8]
#set_property -dict { PACKAGE_PIN A18   IOSTANDARD LVCMOS33 } [get_ports { ja_6 }]; #IO_L10N_T1_AD11N_15 Sch=ja[9]
#set_property -dict { PACKAGE_PIN K16   IOSTANDARD LVCMOS33 } [get_ports { ja_7 }]; #IO_25_15 Sch=ja[10]

##Pmod Header JB

set_property -dict { PACKAGE_PIN E15   IOSTANDARD LVCMOS33 } [get_ports { jb_0 }]; #IO_L11P_T1_SRCC_15 Sch=jb_p[1]
set_property -dict { PACKAGE_PIN E16   IOSTANDARD LVCMOS33 } [get_ports { jb_1 }]; #IO_L11N_T1_SRCC_15 Sch=jb_n[1]
set_property -dict { PACKAGE_PIN D15   IOSTANDARD LVCMOS33 } [get_ports { jb_2 }]; #IO_L12P_T1_MRCC_15 Sch=jb_p[2]
set_property -dict { PACKAGE_PIN C15   IOSTANDARD LVCMOS33 } [get_ports { jb_3 }]; #IO_L12N_T1_MRCC_15 Sch=jb_n[2]
set_property -dict { PACKAGE_PIN J17   IOSTANDARD LVCMOS33 } [get_ports { jb_4 }]; #IO_L23P_T3_FOE_B_15 Sch=jb_p[3]
set_property -dict { PACKAGE_PIN J18   IOSTANDARD LVCMOS33 } [get_ports { jb_5 }]; #IO_L23N_T3_FWE_B_15 Sch=jb_n[3]
set_property -dict { PACKAGE_PIN K15   IOSTANDARD LVCMOS33 } [get_ports { jb_6 }]; #IO_L24P_T3_RS1_15 Sch=jb_p[4]
set_property -dict { PACKAGE_PIN J15   IOSTANDARD LVCMOS33 } [get_ports { jb_7 }]; #IO_L24N_T3_RS0_15 Sch=jb_n[4]

##Pmod Header JC

set_property -dict { PACKAGE_PIN U12   IOSTANDARD LVCMOS33 } [get_ports { jc_0 }]; #IO_L20P_T3_A08_D24_14 Sch=jc_p[1]
set_property -dict { PACKAGE_PIN V12   IOSTANDARD LVCMOS33 } [get_ports { jc_1 }]; #IO_L20N_T3_A07_D23_14 Sch=jc_n[1]
#set_property -dict { PACKAGE_PIN V10   IOSTANDARD LVCMOS33 } [get_ports { jc_2 }]; #IO_L21P_T3_DQS_14 Sch=jc_p[2]
#set_property -dict { PACKAGE_PIN V11   IOSTANDARD LVCMOS33 } [get_ports { jc_3 }]; #IO_L21N_T3_DQS_A06_D22_14 Sch=jc_n[2]
set_property -dict { PACKAGE_PIN U14   IOSTANDARD LVCMOS33 } [get_ports { jc_4 }]; #IO_L22P_T3_A05_D21_14 Sch=jc_p[3]
set_property -dict { PACKAGE_PIN V14   IOSTANDARD LVCMOS33 } [get_ports { jc_5 }]; #IO_L22N_T3_A04_D20_14 Sch=jc_n[3]
set_property -dict { PACKAGE_PIN T13   IOSTANDARD LVCMOS33 } [get_ports { jc_6 }]; #IO_L23P_T3_A03_D19_14 Sch=jc_p[4]
set_property -dict { PACKAGE_PIN U13   IOSTANDARD LVCMOS33 } [get_ports { jc_7 }]; #IO_L23N_T3_A02_D18_14 Sch=jc_n[4]

##Pmod Header JD

set_property -dict {PACKAGE_PIN D4 IOSTANDARD LVCMOS33} [get_ports jd_0]
set_property -dict {PACKAGE_PIN D3 IOSTANDARD LVCMOS33} [get_ports jd_1]
set_property -dict {PACKAGE_PIN F4 IOSTANDARD LVCMOS33} [get_ports jd_2]
#set_property -dict { PACKAGE_PIN F3    IOSTANDARD LVCMOS33 } [get_ports { jd_3 }]; #IO_L13N_T2_MRCC_35 Sch=jd[4]
set_property -dict {PACKAGE_PIN E2 IOSTANDARD LVCMOS33} [get_ports jd_4]
set_property -dict {PACKAGE_PIN D2 IOSTANDARD LVCMOS33} [get_ports jd_5]
set_property -dict {PACKAGE_PIN H2 IOSTANDARD LVCMOS33} [get_ports jd_6]
#set_property -dict { PACKAGE_PIN G2    IOSTANDARD LVCMOS33 } [get_ports { jd_7 }]; #IO_L15N_T2_DQS_35 Sch=jd[10]

##USB-UART Interface (FTDI FT2232H)

set_property -dict {PACKAGE_PIN D10 IOSTANDARD LVCMOS33} [get_ports uart_rxd_out]
set_property -dict {PACKAGE_PIN A9 IOSTANDARD LVCMOS33} [get_ports uart_txd_in]


##ChipKit Single Ended Analog Inputs
##NOTE: The ck_an_p pins can be used as single ended analog inputs with voltages from 0-3.3V (Chipkit Analog pins A0-A5).
##      These signals should only be connected to the XADC core. When using these pins as digital I/O, use pins ck_io[14-19].

#set_property -dict { PACKAGE_PIN C5    IOSTANDARD LVCMOS33 } [get_ports { ck_an_n[0] }]; #IO_L1N_T0_AD4N_35 Sch=ck_an_n[0]
#set_property -dict { PACKAGE_PIN C6    IOSTANDARD LVCMOS33 } [get_ports { ck_an_p[0] }]; #IO_L1P_T0_AD4P_35 Sch=ck_an_p[0]
#set_property -dict { PACKAGE_PIN A5    IOSTANDARD LVCMOS33 } [get_ports { ck_an_n[1] }]; #IO_L3N_T0_DQS_AD5N_35 Sch=ck_an_n[1]
#set_property -dict { PACKAGE_PIN A6    IOSTANDARD LVCMOS33 } [get_ports { ck_an_p[1] }]; #IO_L3P_T0_DQS_AD5P_35 Sch=ck_an_p[1]
#set_property -dict { PACKAGE_PIN B4    IOSTANDARD LVCMOS33 } [get_ports { ck_an_n[2] }]; #IO_L7N_T1_AD6N_35 Sch=ck_an_n[2]
#set_property -dict { PACKAGE_PIN C4    IOSTANDARD LVCMOS33 } [get_ports { ck_an_p[2] }]; #IO_L7P_T1_AD6P_35 Sch=ck_an_p[2]
#set_property -dict { PACKAGE_PIN A1    IOSTANDARD LVCMOS33 } [get_ports { ck_an_n[3] }]; #IO_L9N_T1_DQS_AD7N_35 Sch=ck_an_n[3]
#set_property -dict { PACKAGE_PIN B1    IOSTANDARD LVCMOS33 } [get_ports { ck_an_p[3] }]; #IO_L9P_T1_DQS_AD7P_35 Sch=ck_an_p[3]
#set_property -dict { PACKAGE_PIN B2    IOSTANDARD LVCMOS33 } [get_ports { ck_an_n[4] }]; #IO_L10N_T1_AD15N_35 Sch=ck_an_n[4]
#set_property -dict { PACKAGE_PIN B3    IOSTANDARD LVCMOS33 } [get_ports { ck_an_p[4] }]; #IO_L10P_T1_AD15P_35 Sch=ck_an_p[4]
#set_property -dict { PACKAGE_PIN C14   IOSTANDARD LVCMOS33 } [get_ports { ck_an_n[5] }]; #IO_L1N_T0_AD0N_15 Sch=ck_an_n[5]
#set_property -dict { PACKAGE_PIN D14   IOSTANDARD LVCMOS33 } [get_ports { ck_an_p[5] }]; #IO_L1P_T0_AD0P_15 Sch=ck_an_p[5]

##ChipKit Digital I/O Low

set_property -dict {PACKAGE_PIN V15 IOSTANDARD LVCMOS33} [get_ports {ck_io[0]}]
set_property -dict {PACKAGE_PIN U16 IOSTANDARD LVCMOS33} [get_ports {ck_io[1]}]
set_property -dict {PACKAGE_PIN P14 IOSTANDARD LVCMOS33} [get_ports {ck_io[2]}]
set_property -dict {PACKAGE_PIN T11 IOSTANDARD LVCMOS33} [get_ports {ck_io[3]}]
set_property -dict {PACKAGE_PIN R12 IOSTANDARD LVCMOS33} [get_ports {ck_io[4]}]
set_property -dict {PACKAGE_PIN T14 IOSTANDARD LVCMOS33} [get_ports {ck_io[5]}]
set_property -dict {PACKAGE_PIN T15 IOSTANDARD LVCMOS33} [get_ports {ck_io[6]}]
set_property -dict {PACKAGE_PIN T16 IOSTANDARD LVCMOS33} [get_ports {ck_io[7]}]
set_property -dict {PACKAGE_PIN N15 IOSTANDARD LVCMOS33} [get_ports {ck_io[8]}]
set_property -dict {PACKAGE_PIN M16 IOSTANDARD LVCMOS33} [get_ports {ck_io[9]}]
set_property -dict {PACKAGE_PIN V17 IOSTANDARD LVCMOS33} [get_ports {ck_io[10]}]
set_property -dict {PACKAGE_PIN U18 IOSTANDARD LVCMOS33} [get_ports {ck_io[11]}]
set_property -dict {PACKAGE_PIN R17 IOSTANDARD LVCMOS33} [get_ports {ck_io[12]}]
set_property -dict {PACKAGE_PIN P17 IOSTANDARD LVCMOS33} [get_ports {ck_io[13]}]

##ChipKit Digital I/O On Outer Analog Header
##NOTE: These pins should be used when using the analog header signals A0-A5 as digital I/O (Chipkit digital pins 14-19)

set_property -dict {PACKAGE_PIN F5 IOSTANDARD LVCMOS33} [get_ports {ck_io[14]}]
set_property -dict {PACKAGE_PIN D8 IOSTANDARD LVCMOS33} [get_ports {ck_io[15]}]
set_property -dict {PACKAGE_PIN C7 IOSTANDARD LVCMOS33} [get_ports {ck_io[16]}]
set_property -dict {PACKAGE_PIN E7 IOSTANDARD LVCMOS33} [get_ports {ck_io[17]}]
set_property -dict {PACKAGE_PIN D7 IOSTANDARD LVCMOS33} [get_ports {ck_io[18]}]
set_property -dict {PACKAGE_PIN D5 IOSTANDARD LVCMOS33} [get_ports {ck_io[19]}]

##ChipKit Digital I/O On Inner Analog Header
##NOTE: These pins will need to be connected to the XADC core when used as differential analog inputs (Chipkit analog pins A6-A11)

#set_property -dict { PACKAGE_PIN B7    IOSTANDARD LVCMOS33 } [get_ports { ck_io[20] }]; #IO_L2P_T0_AD12P_35 Sch=ad_p[12]
#set_property -dict { PACKAGE_PIN B6    IOSTANDARD LVCMOS33 } [get_ports { ck_io[21] }]; #IO_L2N_T0_AD12N_35 Sch=ad_n[12]
#set_property -dict { PACKAGE_PIN E6    IOSTANDARD LVCMOS33 } [get_ports { ck_io[22] }]; #IO_L5P_T0_AD13P_35 Sch=ad_p[13]
#set_property -dict { PACKAGE_PIN E5    IOSTANDARD LVCMOS33 } [get_ports { ck_io[23] }]; #IO_L5N_T0_AD13N_35 Sch=ad_n[13]
#set_property -dict { PACKAGE_PIN A4    IOSTANDARD LVCMOS33 } [get_ports { ck_io[24] }]; #IO_L8P_T1_AD14P_35 Sch=ad_p[14]
#set_property -dict { PACKAGE_PIN A3    IOSTANDARD LVCMOS33 } [get_ports { ck_io[25] }]; #IO_L8N_T1_AD14N_35 Sch=ad_n[14]

##ChipKit Digital I/O High

#set_property -dict { PACKAGE_PIN U11   IOSTANDARD LVCMOS33 } [get_ports { ck_io[26] }]; #IO_L19N_T3_A09_D25_VREF_14 Sch=ck_io[26]
#set_property -dict { PACKAGE_PIN V16   IOSTANDARD LVCMOS33 } [get_ports { ck_io[27] }]; #IO_L16N_T2_A15_D31_14 Sch=ck_io[27]
#set_property -dict { PACKAGE_PIN M13   IOSTANDARD LVCMOS33 } [get_ports { ck_io[28] }]; #IO_L6N_T0_D08_VREF_14 Sch=ck_io[28]
#set_property -dict { PACKAGE_PIN R10   IOSTANDARD LVCMOS33 } [get_ports { ck_io[29] }]; #IO_25_14 Sch=ck_io[29]
#set_property -dict { PACKAGE_PIN R11   IOSTANDARD LVCMOS33 } [get_ports { ck_io[30] }]; #IO_0_14 Sch=ck_io[30]
#set_property -dict { PACKAGE_PIN R13   IOSTANDARD LVCMOS33 } [get_ports { ck_io[31] }]; #IO_L5N_T0_D07_14 Sch=ck_io[31]
#set_property -dict { PACKAGE_PIN R15   IOSTANDARD LVCMOS33 } [get_ports { ck_io[32] }]; #IO_L13N_T2_MRCC_14 Sch=ck_io[32]
#set_property -dict { PACKAGE_PIN P15   IOSTANDARD LVCMOS33 } [get_ports { ck_io[33] }]; #IO_L13P_T2_MRCC_14 Sch=ck_io[33]
#set_property -dict { PACKAGE_PIN R16   IOSTANDARD LVCMOS33 } [get_ports { ck_io[34] }]; #IO_L15P_T2_DQS_RDWR_B_14 Sch=ck_io[34]
#set_property -dict { PACKAGE_PIN N16   IOSTANDARD LVCMOS33 } [get_ports { ck_io[35] }]; #IO_L11N_T1_SRCC_14 Sch=ck_io[35]
#set_property -dict { PACKAGE_PIN N14   IOSTANDARD LVCMOS33 } [get_ports { ck_io[36] }]; #IO_L8P_T1_D11_14 Sch=ck_io[36]
#set_property -dict { PACKAGE_PIN U17   IOSTANDARD LVCMOS33 } [get_ports { ck_io[37] }]; #IO_L17P_T2_A14_D30_14 Sch=ck_io[37]
#set_property -dict { PACKAGE_PIN T18   IOSTANDARD LVCMOS33 } [get_ports { ck_io[38] }]; #IO_L7N_T1_D10_14 Sch=ck_io[38]
#set_property -dict { PACKAGE_PIN R18   IOSTANDARD LVCMOS33 } [get_ports { ck_io[39] }]; #IO_L7P_T1_D09_14 Sch=ck_io[39]
#set_property -dict { PACKAGE_PIN P18   IOSTANDARD LVCMOS33 } [get_ports { ck_io[40] }]; #IO_L9N_T1_DQS_D13_14 Sch=ck_io[40]
#set_property -dict { PACKAGE_PIN N17   IOSTANDARD LVCMOS33 } [get_ports { ck_io[41] }]; #IO_L9P_T1_DQS_14 Sch=ck_io[41]

## ChipKit SPI

set_property -dict {PACKAGE_PIN G1 IOSTANDARD LVCMOS33} [get_ports ck_miso]
set_property -dict {PACKAGE_PIN H1 IOSTANDARD LVCMOS33} [get_ports ck_mosi]
set_property -dict {PACKAGE_PIN F1 IOSTANDARD LVCMOS33} [get_ports ck_sck]
set_property -dict {PACKAGE_PIN C1 IOSTANDARD LVCMOS33} [get_ports ck_ss]

## ChipKit I2C

#set_property -dict { PACKAGE_PIN L18   IOSTANDARD LVCMOS33 } [get_ports { ck_scl }]; #IO_L4P_T0_D04_14 Sch=ck_scl
#set_property -dict { PACKAGE_PIN M18   IOSTANDARD LVCMOS33 } [get_ports { ck_sda }]; #IO_L4N_T0_D05_14 Sch=ck_sda
#set_property -dict { PACKAGE_PIN A14   IOSTANDARD LVCMOS33 } [get_ports { scl_pup }]; #IO_L9N_T1_DQS_AD3N_15 Sch=scl_pup
#set_property -dict { PACKAGE_PIN A13   IOSTANDARD LVCMOS33 } [get_ports { sda_pup }]; #IO_L9P_T1_DQS_AD3P_15 Sch=sda_pup

##Misc. ChipKit signals

#set_property -dict { PACKAGE_PIN M17   IOSTANDARD LVCMOS33 } [get_ports { ck_ioa }]; #IO_L10N_T1_D15_14 Sch=ck_ioa
set_property -dict {PACKAGE_PIN C2 IOSTANDARD LVCMOS33} [get_ports ck_rst]

##SMSC Ethernet PHY

set_property -dict { PACKAGE_PIN D17   IOSTANDARD LVCMOS33 } [get_ports { eth_col }]; #IO_L16N_T2_A27_15 Sch=eth_col
set_property -dict { PACKAGE_PIN G14   IOSTANDARD LVCMOS33 } [get_ports { eth_crs }]; #IO_L15N_T2_DQS_ADV_B_15 Sch=eth_crs
set_property -dict { PACKAGE_PIN F16   IOSTANDARD LVCMOS33 } [get_ports { eth_mdc }]; #IO_L14N_T2_SRCC_15 Sch=eth_mdc
set_property -dict { PACKAGE_PIN K13   IOSTANDARD LVCMOS33 } [get_ports { eth_mdio }]; #IO_L17P_T2_A26_15 Sch=eth_mdio
set_property -dict { PACKAGE_PIN G18   IOSTANDARD LVCMOS33 } [get_ports { eth_ref_clk }]; #IO_L22P_T3_A17_15 Sch=eth_ref_clk
set_property -dict { PACKAGE_PIN C16   IOSTANDARD LVCMOS33 } [get_ports { eth_rstn }]; #IO_L20P_T3_A20_15 Sch=eth_rstn
set_property -dict { PACKAGE_PIN F15   IOSTANDARD LVCMOS33 } [get_ports { eth_rx_clk }]; #IO_L14P_T2_SRCC_15 Sch=eth_rx_clk
set_property -dict { PACKAGE_PIN G16   IOSTANDARD LVCMOS33 } [get_ports { eth_rx_dv }]; #IO_L13N_T2_MRCC_15 Sch=eth_rx_dv
set_property -dict { PACKAGE_PIN D18   IOSTANDARD LVCMOS33 } [get_ports { eth_rxd[0] }]; #IO_L21N_T3_DQS_A18_15 Sch=eth_rxd[0]
set_property -dict { PACKAGE_PIN E17   IOSTANDARD LVCMOS33 } [get_ports { eth_rxd[1] }]; #IO_L16P_T2_A28_15 Sch=eth_rxd[1]
set_property -dict { PACKAGE_PIN E18   IOSTANDARD LVCMOS33 } [get_ports { eth_rxd[2] }]; #IO_L21P_T3_DQS_15 Sch=eth_rxd[2]
set_property -dict { PACKAGE_PIN G17   IOSTANDARD LVCMOS33 } [get_ports { eth_rxd[3] }]; #IO_L18N_T2_A23_15 Sch=eth_rxd[3]
set_property -dict { PACKAGE_PIN C17   IOSTANDARD LVCMOS33 } [get_ports { eth_rxerr }]; #IO_L20N_T3_A19_15 Sch=eth_rxerr
set_property -dict { PACKAGE_PIN H16   IOSTANDARD LVCMOS33 } [get_ports { eth_tx_clk }]; #IO_L13P_T2_MRCC_15 Sch=eth_tx_clk
set_property -dict { PACKAGE_PIN H15   IOSTANDARD LVCMOS33 } [get_ports { eth_tx_en }]; #IO_L19N_T3_A21_VREF_15 Sch=eth_tx_en
set_property -dict { PACKAGE_PIN H14   IOSTANDARD LVCMOS33 } [get_ports { eth_txd[0] }]; #IO_L15P_T2_DQS_15 Sch=eth_txd[0]
set_property -dict { PACKAGE_PIN J14   IOSTANDARD LVCMOS33 } [get_ports { eth_txd[1] }]; #IO_L19P_T3_A22_15 Sch=eth_txd[1]
set_property -dict { PACKAGE_PIN J13   IOSTANDARD LVCMOS33 } [get_ports { eth_txd[2] }]; #IO_L17N_T2_A25_15 Sch=eth_txd[2]
set_property -dict { PACKAGE_PIN H17   IOSTANDARD LVCMOS33 } [get_ports { eth_txd[3] }]; #IO_L18P_T2_A24_15 Sch=eth_txd[3]

##Quad SPI Flash

set_property -dict {PACKAGE_PIN L16 IOSTANDARD LVCMOS33 IOB TRUE} [get_ports qspi_sck]
set_property -dict {PACKAGE_PIN L13 IOSTANDARD LVCMOS33 IOB TRUE} [get_ports qspi_cs]
set_property IOSTANDARD LVCMOS33 [get_ports {qspi_dq[0]}]
set_property IOB TRUE [get_ports {qspi_dq[0]}]
set_property PACKAGE_PIN K17 [get_ports {qspi_dq[0]}]
set_property PULLUP true [get_ports {qspi_dq[0]}]
set_property IOSTANDARD LVCMOS33 [get_ports {qspi_dq[1]}]
set_property IOB TRUE [get_ports {qspi_dq[1]}]
set_property PACKAGE_PIN K18 [get_ports {qspi_dq[1]}]
set_property PULLUP true [get_ports {qspi_dq[1]}]
set_property IOSTANDARD LVCMOS33 [get_ports {qspi_dq[2]}]
set_property IOB TRUE [get_ports {qspi_dq[2]}]
set_property PACKAGE_PIN L14 [get_ports {qspi_dq[2]}]
set_property PULLUP true [get_ports {qspi_dq[2]}]
set_property IOSTANDARD LVCMOS33 [get_ports {qspi_dq[3]}]
set_property IOB TRUE [get_ports {qspi_dq[3]}]
set_property PACKAGE_PIN M14 [get_ports {qspi_dq[3]}]
set_property PULLUP true [get_ports {qspi_dq[3]}]

##Power Measurements

#set_property -dict { PACKAGE_PIN B17   IOSTANDARD LVCMOS33     } [get_ports { vsnsvu_n }]; #IO_L7N_T1_AD2N_15 Sch=ad_n[2]
#set_property -dict { PACKAGE_PIN B16   IOSTANDARD LVCMOS33     } [get_ports { vsnsvu_p }]; #IO_L7P_T1_AD2P_15 Sch=ad_p[2]
#set_property -dict { PACKAGE_PIN B12   IOSTANDARD LVCMOS33     } [get_ports { vsns5v0_n }]; #IO_L3N_T0_DQS_AD1N_15 Sch=ad_n[1]
#set_property -dict { PACKAGE_PIN C12   IOSTANDARD LVCMOS33     } [get_ports { vsns5v0_p }]; #IO_L3P_T0_DQS_AD1P_15 Sch=ad_p[1]
#set_property -dict { PACKAGE_PIN F14   IOSTANDARD LVCMOS33     } [get_ports { isns5v0_n }]; #IO_L5N_T0_AD9N_15 Sch=ad_n[9]
#set_property -dict { PACKAGE_PIN F13   IOSTANDARD LVCMOS33     } [get_ports { isns5v0_p }]; #IO_L5P_T0_AD9P_15 Sch=ad_p[9]
#set_property -dict { PACKAGE_PIN A16   IOSTANDARD LVCMOS33     } [get_ports { isns0v95_n }]; #IO_L8N_T1_AD10N_15 Sch=ad_n[10]
#set_property -dict { PACKAGE_PIN A15   IOSTANDARD LVCMOS33     } [get_ports { isns0v95_p }]; #IO_L8P_T1_AD10P_15 Sch=ad_p[10]




create_clock -period 20.000 -name qspi_sck_pin -waveform {0.000 10.000} -add [get_ports qspi_sck]
create_clock -period 10.000 -name sys_clk_pin -waveform {0.000 5.000} -add [get_ports CLK100MHZ]
