xiaoerlang0359/E203plus/(notices)

Notices in the files:
yrtl/sim/main.c:
FreeRTOS is free software; you can redistribute it and/or modify it under
the terms of the GNU General Public License (version 2) as published by the
Free Software Foundation >>>> AND MODIFIED BY <<<< the FreeRTOS exception.
